Billiardchalktheif/2026ESWContest_free_bulchimbeon/README.md

# 2026ESWContest_free_불침번
> **점검을 대체하지 않고, 점검 사이를 지킵니다.**
> 소방설비 법정 점검(연 1~2회) 사이의 상태 열화를 상시 센서로 감시해, 점검 사각지대를 메우는 AIoT 기반 소방설비 상태감시·점검보조 플랫폼입니다.

## 저장소 구조

| 폴더 | 내용 |
|---|---|
| `docs/` | 설계·기획 자료 |
| `guides/` | 실험·조립 가이드 |
| `server/` | ESP32 펌웨어(.ino) |
| `bulchimbeon_sw/` | 라즈베리파이 서버(Python: 수신·판정·AI·대시보드) |
| `app/` | 네이티브 앱(Flutter) |
| `simulation/` | Wokwi 하드웨어 시뮬레이션 |
| `data/` | 실물 실험 원시 데이터 (엣지별, 상세는 `data/README.md`) |

## docs/ — 설계·기획 자료
불침번 개발과정을 정리한 자료입니다.

- `불침번_하드웨어_조감도_핀배치_v3.pdf` — 전체 시스템 구조도 + 모듈별 핀 배치 (가장 먼저 볼 자료)
- `불침번_하드웨어_최종기술문서.pdf` — 하드웨어 최종 기술문서
- `AI_학습_데이터_수집_가이드.md` — AI 학습 시 데이터 수집 방법 초기 구상안
- `Fail-Safe_설계철학_정리.md` — 프로젝트 구성 중 산업적인 측면에서의 정리
- `소프트웨어_구상안_초안.md` — 서버/AI/판정로직 아키텍처 초안
- `소프트웨어 구성안 v3.md` — 서버/AI/판정로직 아키텍처 최신안 (실제 코드는 이 기준)
- `개발_장애요인_해결방안_정리.md` — 개발 중 발생한 기술적 문제와 해결 과정 (CT클램프→INA219 교체 등)
- `네트워크_인프라_장애요인_해결방안_정리.md` — 라즈베리파이 자체 WiFi 핫스팟(BulchimbeonAP) 인프라에서 겪은 문제 정리 (핫스팟 비영속성, ESP32 WPA 협상 실패, RTC 부재로 인한 하트비트 오판정 등)
- `소화기_게이트웨이_ESP-NOW_WiFi_동시사용_문제_정리.md` — 위 문서의 WPA 협상 문제 해결 후에도 남아있던 소화기 게이트웨이 WiFi 반복 끊김 원인 추적기 (라즈베리파이 AP 모드 `brcmfmac` 드라이버 결함 + ESP32 ESP-NOW/WiFi 단일 라디오 공유 제약, 최종적으로 파이를 외부 공유기 클라이언트 모드로 전환해 해결), 예선(WiFi)/결선(RS-485 유선) 통신 방식 차이 결정 배경
- `소화기_리프노드_딥슬립_제거_디버깅_정리.md` - 소화기 노드 캘리브레이션 과정에서 발견한 esp32-mini의 딥슬립 과정에서의 충돌로 인한 딥슬립 로직 삭제
- `개발_체크리스트.md` — 하드웨어 조립 및 실험 시 체크할 내역
- `발전가능성_확장방안_정리_v2.md` — 실물 규모 확장 시 설계 변경 방향
- `불침번_잔여작업_체크리스트.md` — 하드웨어 및 소프트웨어 구축 완료 후의 잔여 작업 체크리스트
- `불침번_팀원용_이해자료_최종.md` — 프로젝트 취지·로직을 쉽게 풀어쓴 내부 참고자료
- `앱_통합_아이디어_초안.md` — (폐기) 텔레그램 알림봇 + PWA 연동 초기안 — 네이티브 앱으로 방향 전환됨
- `유도등_변경사항_정리.md` — 실제 제작 과정에서 생긴 문제점을 바탕으로 변경 및 수정 사항 정리본
- `유도등_실물실험_기록.md` — 유도등 노드 실물 제작 및 실험 내용 정리
- `수계_유량센서_추가_변경사항_정리.md` — 펌프성능시험의 문제점을 발견 후 성능시험배관에 유량센서를 추가하는 방안  
- `라즈베리파이_소프트웨어_검증_가이드.md` - 라즈베리파이를 통한 중앙제어 시스템을 시뮬레이션하는 가이드
- `라즈베리파이_초기세팅_가이드.md` - 라즈베리파이를 다루기 위한 초기 세팅 가이드라인
- `자탐_유도등_열화감지_회로구성.md` - 열화감지 관련 내용 정리 및 회로 구성 정리
- `자탐1(차동식)_실물실험_기록.md` - 자탐1(차동식) 노드 실물 제작 및 실험 내용 정리
- `자탐2(광전식)_실물실험_기록.md` - 자탐2(광전식) 노드 실물 제작 및 실험 내용 정리
- `자탐1_루프저항_2층판정_재조정_정리.md` — 자탐1 실물(5초 간격) 기준 오프셋 실측, 클램핑 위치 버그, 회귀 노이즈 증폭 문제 발견부터 시연용/결선전용 2단계 재조정, DEMO_MODE 플래그 도입까지 전 과정 정리
- `자탐1_온도상승률_판정로직 및 점검모드신설_소프트웨어_인수인계.md` - 자탐1의 작동/부작동시험의 판정 로직과 점검모드의 신설 관련 소프트웨어 수정사안
- `bulchimbeon_animatic.html` — 애니매틱으로 만든 시연영상 초기 구성안

**시연영상 초기 구성안**: [바로 재생하기](https://billiardchalktheif.github.io/2026ESWContest_free_bulchimbeon/docs/bulchimbeon_animatic.html)

## guides/ — 실험·조립 가이드
하드웨어 핀 배치 및 각 테스트베드 조립과 실험 방법입니다.

- `테스트베드_조립가이드.md` — 5개 모듈 조립 순서 총정리
- `자탐_실험가이드.md` — 자탐1(차동식)·자탐2(광전식) 실험 프로토콜
- `수계_실험가이드.md` — 압력센서를 활용한 펌프성능시험의 주기적인 측정 및 전류센서(INA219)를 통한 충압펌프 작동 빈도 확인
- `수계_배관구조_최종가이드.md` — 유량센서가 추가되고 배관구조가 변경되면서 수정된 실험 가이드
- `수계_통합가이드_최종.md` — 펌프성능시험과 충압펌프 자동 기동을 위한 배관/배선 정리 및 최종 로직 설명
- `가스계_실험가이드.md` — 로드셀을 이용한 가스저장용기의 무게 변화(공병중량 분리 계산) 확인
- `소화기_실험가이드.md` — 자이로 센서 및 게이트웨이와의 통신 연결 상태를 통해 도난/분실 확인
- `유도등_실험가이드.md` — 유도등 구동전압 탐색 및 배터리 방전 실험
- `유도등_실험가이드_v2.md` — 유도등 노드의 수정본(조도센서 사용 방안 삭제)
- `실험_캘리브레이션_데이터축적_통합정리.md` — 6개 엣지 실험을 "캘리브레이션/추세축적/AI학습축적/반복검증" 관점으로 재구성한 통합 인덱스 (무엇을·왜·얼마나 쌓아야 하는지 빠르게 파악용)

## server/ — ESP32 펌웨어
각 모듈의 ESP32에 올라가는 펌웨어(.ino)입니다. 라즈베리파이에서 상시 구동되는 수신·판정·AI·대시보드 서버는 아래 `bulchimbeon_sw/` 섹션 참고.

| 파일 | 담당 모듈 | 비고 |
|---|---|---|
| `fire_alarm_differential_node.ino` | 자탐1 (차동식구역) | ADS1115+TS0202, 온도상승률 계산, 배선 열화 감지 |
| `fire_alarm_differential_node_v5.ino` | 자탐1 (차동식구역) | 점검모드 신설 및 작동 택트스위치 설치 |
| `fire_alarm_differential_node_v6.ino` | 자탐1 (차동식구역) | 워치독 로직 삽입 |
| `fire_alarm_photoelectric_node.ino` | 자탐2 (광전식구역) | ADS1115+MQ-2+DHT22, AI 비화재보 판별 대상, 배선 열화 감지 |
| `fire_alarm_photoelectric_node_v2.ino` | 자탐2 (광전식구역) | 점검모드 신설 및 작동 택트스위치 설치 |
| `fire_alarm_photoelectric_node_v3.ino` | 자탐2 (광전식구역) | 워치독 로직 삽입 |
| `pump_node_INA219.ino` | 수계 | INA219(I2C) 기반 — CT클램프는 DC 측정 불가로 폐기, 이 파일이 최신 수정본 |
| `pump_node_INA219_v7.ino` | 수계 | 유량센서 추가 및 압력센서를 통한 충압펌프 자동 기동 |
| `pump_node_INA219_v23.ino` | 수계 | 압력센서 임계값 수정 및 주배관 측 압력값 기준으로 충압펌프 및 주펌프 작동 |
| `pump_node_INA219_v24.ino` | 수계 | 펌프성능시험 실행 명령어(P) 작동 택트스위치 설치 |
| `pump_node_INA219_v25.ino` | 수계 | 워치독 로직 삽입 |
| `gas_node.ino` | 가스계 (CO2) | HX711, NVS 기반 캘리브레이션 저장 |
| `gas_node_v2.ino` | 가스계 (CO2) | 캘리브레이션을 통해 실측 중량과 측정 중량 대조 후 무게 상수 대입 |
| `gas_node_v3.ino` | 가스계 (CO2) | 영점(TARE), 기준중량저장(SET_INITIAL) 실행 명령어 작동 택트스위치 설치 |
| `gas_node_v4.ino` | 가스계 (CO2) | 워치독 로직 삽입 |
| `extinguisher_leafnode.ino` | 소화기 리프노드 ×4 | ESP32-C3, MPU6500+딥슬립, ESP-NOW 송신 |
| `extinguisher_leafnode_v2.ino` | 소화기 리프노드 ×4 | 워치독 로직 삽입 과정에서 충돌로 인한 딥슬립 로직 삭제 |
| `extinguisher_leafnode_v3.ino` | 소화기 리프노드 ×4 | 상호 간 연결 확인 로직 삽입 |
| `extinguisher_gateway.ino` | 소화기 게이트웨이 | ESP-NOW 수신 → WiFi/UDP 중계, 상시전원 |
| `extinguisher_gateway_v2.ino` | 소화기 게이트웨이 | 점검모드 신설 및 작동 택트스위치 설치 |
| `extinguisher_gateway_v3.ino` | 소화기 게이트웨이 | 워치독 로직 삽입 |
| `extinguisher_gateway_v4.ino` | 소화기 게이트웨이 | 상호 간 연결 확인 로직 삽입 |
| `evac_light_node.ino` | 유도등 | CD74HC4067 멀티플렉서, 데모모드(20분→45초 압축) 포함 |
| `evac_light_node_v2.ino` | 유도등 | 아날로그 멀티플렉서 및 조도센서 사용 삭제 |
| `evac_light_node_v3.ino` | 유도등 | 방전시험을 거치며 얻은 결과를 기준으로 수정 |
| `evac_light_node_v4.ino` | 유도등 | 방전시험(s), 데모시험(d) 실행 명령어 작동 택트스위치 설치 |
| `evac_light_node_v5.ino` | 유도등 | 워치독 로직 삽입 |

## bulchimbeon_sw/ — 라즈베리파이 서버 소프트웨어 (Python)
UDP 수신 → SQLite 저장 → 규칙/회귀/AI 3계층 판정 → 부저·LCD·대시보드 출력까지, 라즈베리파이에서 상시 구동되는 서버 전체입니다. AI는 정확히 2곳(수계 주펌프 파형 분류, 자탐2 비화재보 판별)에만 쓰고 나머지 설비(자탐1/가스계/유도등/소화기)는 전부 통계·규칙 기반입니다. 구조·실행 순서·설계 결정 배경은 `bulchimbeon_sw/README.md`에 자세히 정리되어 있습니다.

- `server/` — `main.py`(실행 진입점), `receiver/`(UDP 수신), `storage/`(SQLite 스키마·마이그레이션), `judge/`(규칙·회귀·AI 판정 로직), `dispatch/`(부저+LCD 출력)
- `ml/` — 수계 파형 분류기·자탐2 비화재보 판별기 학습 스크립트, 예측 정확도(MAE) 검증
- `dashboard/` — Flask 대시보드(`app.py`) + 템플릿
- `app_api/` — 네이티브 앱(Flutter) 연동용 FastAPI 서버(`inspection_api.py`). 설비 체크리스트 조회 + 점검기록 등록 API 제공 (점검이력 영구 저장은 미구현, 앱 쪽 `app/네이비브앱_결선_발전방향.md`에 후속 작업으로 명시됨)
- `simulate/` — 더미 데이터 생성기, 실측 라벨 데이터 DB 반영 스크립트, 판정 로직 검증 스크립트
- `requirements.txt` — Python 의존성

## app/ — 네이티브 앱(Flutter) 개발
안드로이드 기준 네이티브 앱. 대시보드 외 알림/QR조회/PDF리포트 등 출력 채널을 담당합니다.

- `개발_코드/` — Flutter 앱 실제 소스. `main.dart`, `home_screen.dart`(설비 상태 리스트), `equipment_detail_screen.dart`(설비 상세), `alerts_screen.dart`(알림), `scanner_screen.dart`(QR 스캔), `settings_screen.dart`(설정+PDF 리포트), `pubspec.yaml`, `AndroidManifest.xml`, `network_security_config.xml`
- `네이티브앱_쉬운설명.md` — 네이티브 앱·Flutter가 뭔지 비유로 풀어쓴 개념 입문 자료
- `네이티브앱_개발가이드.md` — 화면 구성, API 연동 목록(`/api/status` 등), 기능별 구현 순서 정리
- `처음부터_시작하기_Windows.md` — Flutter 개발환경 설치 가이드 (Windows)
- `네이티브앱_고급기능_가이드.md` — QR스캔·PDF리포트 등 고급 기능 구현 가이드
- `QR코드_생성_가이드.md` — QR코드에는 짧은 식별자(예: `EXT-01`)만 넣고 앱이 스캔 후 서버(`/api/equipment/<코드>`)에 조회하는 A방식 생성 가이드
- `라즈베리파이_연동_가이드.md` — Flutter 앱을 라즈베리파이 서버(`api.py`, 5001포트)와 연동하는 단계별(STEP 0~) 실행 가이드
- `raspberry_pi_integration_plan.md` — 라즈베리파이·QR코드 연동 개발 마일스톤(단계별 작업 계획서)
- `앱개발_과정.md` - Flutter를 이용한 앱 개발 및 코드 (틀 완성 + QR스캔·PDF리포트 기능 완료, 서버 연동 대기 중)
- `앱개발_총정리.md` - 네이티브앱 개발 목적 과정 개선방향의 총정리
- `네이비브앱_결선_발전방향.md` — 예선 제출(9/3) 기준 QR→설비상세→점검완료→PDF 풀 플로우는 완성. 시간상 예선에서 스킵하고 결선에서 이어갈 6개 항목 정리(앱 아이콘 커스텀, PDF 한글 폰트, 점검이력 영구 저장, 홈화면 실시간 폴링 등)

## simulation/ — 하드웨어 시뮬레이션 (Wokwi)
실물 부품 도착 전, 회로·로직을 미리 검증한 시뮬레이션입니다.

- **가스계(CO2) 모듈(로드셀)**: [Wokwi에서 열기](https://wokwi.com/projects/471159083371335681)
  - 소스: `simulation/가스계_wokwi/`
   -  **시뮬레이션 한계 (자세히)**:
    - **HX711은 공식 지원 부품이라 실물과 거의 동일하게 동작** (Wokwi 부품 중 신뢰도가 가장 높은 축).
    - **캘리브레이션 계수(CALIBRATION_FACTOR)는 임시값**: 가상 로드셀의 신호 크기가 실물과 다르기 때문에, 실물 그램 단위로 정확히 안 맞습니다. 실물 로드셀 수령 후 알고 있는 무게(동전 등)로 재보정할 예정입니다.
    - **공병중량(EMPTY_CONTAINER_WEIGHT)은 시뮬레이션에서 0으로 설정**:
      실물 상수(예: 500g)를 그대로 넣으면 시뮬레이션의 작은 임의값(수십 단위)과 스케일이 안 맞아 손실률이 이상하게 계산되는 문제를 겪었습니다.
      시뮬레이션에서는 이 값을 0으로 두고 "슬라이더 값 자체를 약제중량으로 취급"하는 방식으로 로직만 검증했습니다.
    - **검증된 것**: 약제중량 기준 손실률 계산식(총중량이 아니라 공병중량을 뺀 값 기준), 10% 임계치 도달 시 상태 전환(정상→주의→재충전 필요) 판정 로직.
    - **검증 안 된 것**: 실제 CO2 저장용기 중량대에서의 로드셀 분해능, 실물 공병중량 적용 시의 정확도.

- **소화기 모듈(자이로 + 연결끊김)**: [Wokwi에서 열기](https://wokwi.com/projects/471162307837300737)
  - 소스: `simulation/소화기_wokwi/`
  -  **시뮬레이션 한계 (자세히)**:
    - **무선통신(ESP-NOW)을 푸시버튼으로 대체**:
       실물은 리프노드가 게이트웨이와 ESP-NOW로 실제 무선 통신하면서 "연결 유지/끊김"을 판단하지만, Wokwi에서 보드 2개 간 무선통신을 구현하기 어려워
       **푸시버튼 하나로 "연결 끊김" 상태를 대신 흉내냈습니다** (버튼 안 누름=연결 유지, 누름=연결 끊김).
    - **가속도 임계값(ACCEL_THRESHOLD)을 실측으로 재조정함**:
        처음엔 하드코딩된 "정지 시 9.8"을 기준으로 잡았는데, Wokwi의 가상 MPU6050은 기본 상태에서 중력을 시뮬레이션하지 않아 항상 흔들림으로 오인식되는 문제가 있었습니다.
        **정지 상태 기준값을 setup()에서 직접 측정해서 잡는 방식**으로 바꿔 해결했습니다 — 이 방식은 실물에서도 동일하게 적용 가능합니다(설치 각도가 어떻든 자동으로 맞춰짐).
    - **검증된 것**: 가속도 이벤트 감지 → 일정 시간 대기 → 연결상태 확인 → 오탐/이탈 확정이라는 2단계 판정 흐름 전체, 정지상태 기준값 자동 캘리브레이션 로직.
    - **검증 안 된 것**: 실제 ESP-NOW 페어링·통신 성공률, 실물 배터리(LiPo+TP4056) 구동 상태에서의 동작, 여러 리프노드가 동시에 게이트웨이와 통신할 때의 처리.
 
- **수계 모듈(압력 + 전류2)**: [Wokwi에서 열기](https://wokwi.com/projects/471258535724992513)
  - 소스: `simulation/수계_wokwi/`
  -  **시뮬레이션 한계 (자세히)**:
    - **INA219 미지원**: 전류센서 2개(충압/주펌프)를 포텐셔미터로 대체(GPIO0/GPIO1). 실물은 I2C(주소 0x40/0x41)로 통신하지만, 시뮬레이션에서는 아날로그 입력값을 그대로 mA 단위처럼 취급했습니다.
    - **압력센서도 포텐셔미터로 대체**(GPIO4) — 저항분압 계산 없이 raw값을 바로 kPa로 스케일링한 단순화 버전입니다.
    - **워터펌프 자체는 시뮬레이션 대상에서 제외** — 릴레이 출력(GPIO18/19)은 신호만 내보낼 뿐 실제로 아무것도 구동하지 않습니다.
    - **duty_cycle 계산은 캡처 타이밍에 민감함**:
      한 번의 전류 샘플링(캡처)이 매우 짧은 시간(수백ms~1초) 동안 이뤄지는데, 사람이 마우스로 포텐셔미터를 그 찰나에 움직이지 않으면 "값이 안 변한 것"으로 인식되어 duty_cycle이 0으로 나올 수 있습니다.
      이는 시뮬레이션 조작 방식의 한계이며, 실물 INA219는 실제 펌프의 진짜 전류 변화를 훨씬 빠르게 읽어 이런 제약이 없습니다.
    - **검증된 것**: RMS/Peak/duty_cycle 계산 로직이 입력 변화에 정확히 비례 반응하는 것, 충압펌프 기동 엣지 감지 및 기동 간격(cycle_interval_sec) 계산 로직.
    - **검증 안 된 것**: 실제 체절/부하 상태에서의 전류 패턴, 압력값 추세로 서버가 밸브 상태를 추정하는 로직(server 쪽 별도 검증 필요), 실물 니들밸브 조작과의 연동.
 
- **유도등 모듈(전압 + 조도)**: [Wokwi에서 열기](https://wokwi.com/projects/471260578018942977)
  - 소스: `simulation/유도등_wokwi/`
  -  **시뮬레이션 한계 (자세히)**:
    - **CD74HC4067 멀티플렉서 미지원**:
      실물은 유도등 4개(배터리전압×4 + 조도×4 = 8채널)를 멀티플렉서 하나로 순차 스캔하지만, Wokwi에 이 부품이 없어서 **유도등 1개 분량만 축소해서 시뮬레이션**했습니다.
      멀티플렉서의 채널 전환 로직 자체는 단순 반복(S0~S3 비트 조합)이라 코드 리뷰로 검증 가능하다고 판단해, 정작 확인이 필요한 핵심 판정 로직(전압 추이, 방전시험 상태전환)에 집중했습니다.
    - **배터리 전압을 포텐셔미터1(GPIO4)로 대체**:
      실물은 유도등 배터리 단자에서 저항분압으로 전압을 낮춰 ADS1115(또는 멀티플렉서 경유)로 읽지만, 시뮬레이션에서는 포텐셔미터로 전압값 자체를 흉내냈습니다. 손으로 값을 낮추면서 "배터리가 방전되는 상황"을 재현했습니다.
    - **CDS 조도센서를 포텐셔미터2(GPIO3)로 대체**:
      실제 빛의 밝기를 감지하는 게 아니라, "조도값이 바뀌면 lux 계산 로직이 반응하는가"만 검증했습니다.
      시험 초반(488→324→127)에는 값 변화를 확인했으나, 이후 구간에서는 포텐셔미터를 고정해둔 채로 진행해 127로 유지된 것이며 — 이는 조작을 멈춘 결과일 뿐 로직 결함은 아닙니다.
    - **실제 20분 정격 방전시험 대신 데모모드(45초 압축)만 시뮬레이션**:
      원본 코드에는 실제 정격시험(20분, 30초 간격 샘플)과 데모(45초, 그 비율에 맞춘 간격) 두 가지가 있는데, 20분을 시뮬레이션으로 기다리는 건 비효율적이라 데모모드 로직만 검증했습니다.
      두 모드는 "지속시간·샘플간격 숫자만 다르고 로직은 동일"하게 설계되어 있어(원본 코드의 `testDurationMs`, `testSampleIntervalMs` 파라미터화 구조),
      데모모드가 정상 작동하면 실제모드도 같은 코드 경로를 타므로 검증 효력이 있다고 판단했습니다.
    - **데모 버튼을 인터럽트(GPIO0)로 구현**: 실물과 동일하게 `attachInterrupt`로 버튼을 처리해, 시험 도중에도 다른 처리가 멈추지 않는 논블로킹 구조를 그대로 시뮬레이션했습니다.
    - **검증된 것**: 평상시 모니터링(3초 간격 전송) ↔ 방전시험 모드 전환, 방전시험 중 배터리 전압이 샘플마다 달라지는 것을 반영해 서버에 보내는 흐름, 시험 시간(45초) 경과 후 자동 종료 및 평상시 모드 복귀.
    - **검증 안 된 것**: 4개 유도등 동시 스캔(멀티플렉서 채널 전환 타이밍), 실제 20분 정격 방전시험(시간 관계상 데모모드로만 대체 검증), 2선식/3선식 배선에 따른 실물 동작 차이(현장 확인 필요 — 원본 코드 주석에도 명시됨).    
 
- **자탐1(차동식구역) 모듈(온도 + 루프저항)**: [Wokwi에서 열기](https://wokwi.com/projects/471254826421447681)
  - 소스: `simulation/자탐1(차동식)_wokwi/`
  -  **시뮬레이션 한계 (자세히)**:
    - **ADS1115 미지원**: Wokwi에 이 외장 ADC 부품이 없어서, 실물 코드의 `ads.readADC_SingleEnded()` 부분을 ESP32 내장 `analogRead()`로 임시 대체했습니다. 실물에서는 원래 코드(ADS1115 A0/A1 채널) 그대로 사용합니다.
    - **센서를 포텐셔미터로 대체**: 실물 온도센서(TS0202)와 감지기 루프저항을 손으로 돌리는 가변저항(포텐셔미터) 2개로 흉내냈습니다. 실제로 열을 가하는 게 아니라 "값이 서서히 변하면 코드가 올바르게 반응하는가"만 검증하는 용도입니다.
    - **핀 번호가 실물과 다름**: 시뮬레이터의 ESP32-C3 보드가 실제 구매한 ESP32-C3 보드와 핀 배치가 달라서(예: GPIO5는 시뮬레이터에서 아날로그 입력 자체가 안 됨), GPIO3/GPIO4로 임시 배정했습니다.
                                 실물 배선은 하드웨어 조감도 문서(ADS1115 A0/A1) 기준을 따릅니다.
    - **검증된 것**: 온도 상승률(dT/dt) 계산 로직, 루프저항 단선(개방) 감지 로직, JSON 패킷 구성 — 이 세 가지 핵심 판정 로직이 값 변화에 정확히 반응하는 것을 확인했습니다.
    - **검증 안 된 것**: 실제 센서의 정밀도·응답속도, ADS1115 특유의 노이즈 특성, WiFi/UDP 실제 전송(시뮬레이터는 가상 네트워크라 서버로 실제 도달하지 않음)

- **자탐2(광전식구역) 모듈(가스 + 온습도 + 루프저항)**: [Wokwi에서 열기](https://wokwi.com/projects/471257287920422913)
  - 소스: `simulation/자탐2(광전식)_wokwi/`
  -  **시뮬레이션 한계 (자세히)**:
    - **ADS1115 미지원**: 자탐1과 동일한 이유로, 실물 코드의 `ads.readADC_SingleEnded()` 부분을 ESP32 내장 `analogRead()`로 임시 대체했습니다. 실물에서는 원래 코드(ADS1115 A0/A1 채널) 그대로 사용합니다.
    - **MQ-2 가스센서를 포텐셔미터로 대체**: 실제 가스 성분을 감지하는 게 아니라, 손으로 돌리는 가변저항으로 "가스농도 신호값이 바뀌면 코드가 올바르게 반응하는가"만 검증했습니다.
    - **루프저항도 포텐셔미터로 대체**: 자탐1과 동일하게, 감지기 루프 배선 상태를 흉내낸 가변저항입니다.
    - **핀 번호가 실물과 다름**:
        ESP32-C3-MINI-1 시뮬레이터 보드는 GPIO0~4만 아날로그 입력이 가능해서(자탐1에서 GPIO5가 아날로그 입력 자체를 지원하지 않는 걸 확인했음), 포텐셔미터 2개를 GPIO4·GPIO3으로 배정했습니다.
        실물 배선은 하드웨어 조감도 문서(ADS1115 A0/A1) 기준을 따릅니다.
    - **DHT22는 공식 지원 부품**이라 실물과 동일하게 동작합니다 — 온도·습도 슬라이더를 직접 조절해 값 변화를 확인했습니다(온도 63.9℃, 습도 0%→34.5%로 각각 독립 반응 확인됨).
    - **검증된 것**: 루프저항(배선 상태)·가스농도(MQ-2)·온도·습도, 이 4개 값이 각각 독립적으로 측정되어 하나의 JSON 패킷으로 정상 구성·전송되는 흐름 전체.
    - **검증 안 된 것**: 실제 MQ-2가 진짜 화재 연기와 조리 수증기를 구분할 때 보이는 신호 패턴(이건 물리적으로 실물 센서·실제 연기/수증기가 있어야 확인 가능
                         실물 데이터 수집 후 자탐2 AI(비화재보 판별) 학습 단계에서 검증 예정), WiFi/UDP 실제 전송(시뮬레이터는 가상 네트워크라 서버로 실제 도달하지 않음).

- **라즈베리파이 서버 — MOCK_MODE 소프트웨어 검증**
  - 소스: `simulation/라즈베리파이 검증 로그.md`
  - **참고**: 위 항목들(가스계~유도등)은 Wokwi를 이용한 **하드웨어 회로 시뮬레이션**이고, 이 항목은 실물 라즈베리파이 도착 전 **서버 소프트웨어(수신·판정·AI·대시보드) 자체를 노트북에서 미리 실행·검증**한 기록입니다.
  - **검증 내용**: DB 초기화 → UDP 수신 서버 실행 → 더미데이터(9개 시나리오) 전송 → AI 모델 2종 학습(수계 펌프분류, 자탐2 비화재보판별) → 대시보드 실행 → 자탐 z-score 판정 로직 별도 검증 → 가스계/유도등 회귀예측 정확도(MAE) 산출
  - **확인된 것**: 판정 로직(규칙·회귀·AI 3계층) 정상 작동, 밸브상태 서버추정 로직 정상 작동, 자탐 오탐억제·열화감지 전이 정상 작동
  - **주의**: AI 분류 정확도가 시뮬레이션(더미)데이터 기준 100%로 나왔으나, 이는 인공 생성 데이터의 경계가 실측 센서 노이즈보다 뚜렷하기 때문 — **실물 센서 데이터 학습 전까지는 참고용 수치**로만 사용.
              대신 Feature importance(수계: rms 45.5%+peak 41.1%, 자탐2: 온도상승률·가스농도·습도가 고른 기여도)가 물리적으로 타당한 근거로 확인됨
  - 정량지표(보고서 활용 가능): 가스계 예측 MAE 0.77일(오차율 6.7%), 유도등 예측 MAE 0.62일(오차율 2.2%)
---

## data/ — 실물 실험 데이터
6개 엣지 중 지금까지 진행된 실험 데이터입니다. 파일별 컬럼 설명과 분석 결과는 `data/README.md`에 정리되어 있습니다.

| 엣지 | 상태 | 요약 |
|---|---|---|
| 광전식 | 실험 완료(최종본) | normal/smoking/incense/heat/fire 5클래스 64세션 통합 + 최종분석보고서 |
| 차동식 | 실험 5종 완료 | 온도 상승률 판정 임계값 확정(캘리브레이션 상수 포함) |
| 가스계 | 캘리브레이션 완료 | 로드셀 무게손실 회귀검증(3.85일 로그) |
| 수계 | 채집 완료 | 충압펌프 4클래스(정상/유량저하/공회전/기동실패) 분류용 데이터 |
| 유도등 | 실험 완료 | 충전시간별(1h~8h) 방전시험 |
| 소화기 | 캘리브레이션 완료 | 건물 내 층의 변화 시에 이탈 감지 확인 |
