Billiardchalktheif/2026ESWContest_free_bulchimbeon/docs/개발_장애요인_해결방안_정리.md

# 개발 중 발생한 장애요인과 해결방안 — 정리 자료

> 발표자료(개발완료보고서) 4번 항목용 소재 모음입니다. 지금까지 설계/부품 선정 과정에서 실제로 부딪혔던 문제와 해결 과정을 모듈별로 정리했습니다. 발표 슬라이드로 옮길 때 임팩트 있는 것 위주로 추리면 됩니다.

---

## 1. 가스계 (CO2 소화설비)

### 장애요인 ①: 압력센서로는 미세 누설을 감지할 수 없음
당초 가스계 저장용기의 약제 손실을 압력센서로 감지하려 했으나, 고압식 CO2/할론 저장용기는 내부가 액체+기체 평형 상태로 존재해 **약제가 새어나가도 압력은 거의 일정하게 유지**되고(포화증기압, 온도에만 좌우), 액체가 거의 소진된 시점에야 압력이 급격히 떨어지는 물리적 특성이 있음. 압력만으로는 점진적 손실을 조기에 감지할 수 없다는 것을 확인.

**해결방안**: 압력 대신 **로드셀(중량) 측정 방식**으로 설계 전환. 화물지킴이 프로젝트에서 사용한 HX711 로드셀 앰프 로직을 그대로 재사용해 개발 리스크를 최소화함. 판정 임계치는 **중량손실 10%** (출처: 소방시설등 점검관리 매뉴얼 — 이산화탄소소화설비 점검표, "이산화탄소는 중량 손실 10% 미만" — 불활성가스 5%·기타 가스계와 기준이 다름).

### 장애요인 ②: 약제 종류에 따라 물리적 특성이 상반됨
불활성기체(질소·아르곤 계열)는 순수 기체로 저장돼 압력이 곧 충전량을 직접 반영하는 반면, CO2/할론은 위와 같이 압력이 손실량을 반영하지 못함. 하나의 방식으로 통일할 수 없었음.

**해결방안**: 약제 화학적 특성에 따라 진단 방식을 분기 — **CO2/할론은 중량 측정, 불활성기체는 압력 측정**으로 설계 원칙 수립.

### 장애요인 ③: 로드셀 마운팅 방식 오류
재고로 보유한 S자형 로드셀은 원래 인장(당기는 힘)력 측정에 최적화된 형태로, 용기를 단순히 얹어놓는 압축 방식으로 쓰면 접촉 불안정으로 오차가 커짐.

**해결방안**: 평판 하프브릿지형 로드셀 2개를 평판 양 끝에 배치해 하중을 분산시키는 구조로 재설계, 안정성 확보.

---

## 2. 자동화재탐지설비 (자탐)

### 장애요인 ①: 실제 배선 전원(DC 24V) 재현 불가
자동화재탐지설비는 실제로 수신기에서 감지기 회로에 DC 24V를 공급하는 구조이나, 학생 프로젝트 특성상 실제 수신기 구매나 건물 배선공사가 불가능함.

**해결방안**: 진짜 감지기 제품을 재현하는 것이 아니라 **감지기 회로의 전기적 특성(루프 전류/저항)만 저전압(3.3V/5V)으로 시뮬레이션**하는 것으로 스코프를 명확히 재정의. 발표 시 이 스코프 한계를 정직하게 명시하기로 함.

### 장애요인 ②: 절연저항 측정 방식이 상시 감시에 부적합
절연저항 측정(DC 250V)은 정전 상태에서 주기적으로 측정하는 것이 정석이라, "상시 감시"라는 프로젝트 목적과 맞지 않음.

**해결방안**: 절연저항 대신 **루프 전류/저항 베이스라인 상시 로깅** 방식으로 대체. 감지기 종류(차동식/정온식/광전식)와 무관하게 범용으로 적용 가능한 방식임을 확인.

### 장애요인 ③: 열원 시뮬레이션 안전성 문제
차동식 감지기 작동 재현을 위한 열원으로 니크롬선(발열선)을 검토했으나, 발열체 노출로 인한 화재 위험이 있고 자탐 모듈 특성상 가연성 물질과 근접 배치될 가능성이 있어 안전 문제 제기.

**해결방안**: 니크롬선 대신 **열풍기(헤어드라이어 등)**로 대체 — 발열체 노출 없이 동일한 온도 상승 재현 가능, 준비물 확보도 용이함.

### 장애요인 ④: 온습도센서(DHT22)의 반응속도 한계
차동식 감지기의 핵심 원리는 온도 절대값이 아닌 "온도 상승 속도(dT/dt)"인데, DHT22는 초당 0.5회 수준의 느린 응답속도로 빠른 온도 변화율을 정밀하게 측정할 수 없음을 확인.

**해결방안**: 별도로 **NTC 서미스터(빠른 응답속도)**를 추가해 차동식 전용 온도 측정 라인을 구성. DHT22는 연기감지기구역의 습도 보조 측정용으로 역할 재조정.

### 장애요인 ⑤: 센서 수량 설계 오류
감지기 모형(더미) 개수에 맞춰 온도/가스 센서 개수도 늘려야 한다고 잘못 설계함(NTC 서미스터를 감지기 모형 수와 동일하게 3개로 배정).

**해결방안**: 감지기 모형은 회로에 저항만 얹은 더미 부품으로 그 자체로는 아무것도 감지하지 않으며, 실제 감지 센서(NTC/MQ-2/DHT22)는 **해당 방호구역(챔버) 공간의 대기 상태를 대표하는 것**이므로 감지기 모형 개수와 무관하게 방호구역당 1세트면 충분함을 재확인, 부품 수량 정정.

---

## 3. 수계소화설비

### 장애요인 ①: 유선/무선 통신구조 결정 시 원가 문제
설비 개수가 많은 자탐·소화기 모듈에서 "설비 1개당 ESP32 1개"로 설계하면 원가가 기하급수적으로 증가하는 문제 발견.

**해결방안**: 설비의 물리적 밀집도에 따라 유선/무선을 분리하는 원칙 수립 — 밀집된 설비(가스계, 수계)는 구역당 ESP32 1개로 유선 처리, 산개된 설비(소화기)는 저전력 무선 리프노드+게이트웨이 구조로 처리.

### 장애요인 ②: 워터펌프 양정(성능) 스펙 미상
선정한 미니 워터펌프 제품에 양정(수두) 정보가 명시되지 않아, 압력센서 스펙 선정이 어려움. 유량(Q)만으로 토리첼리 공식을 활용한 이론적 역산을 시도했으나, 이는 개방 상태 유속에 대응하는 값일 뿐 실제 최대 양정(체절 상태)과는 다른 값임을 확인.

**해결방안**: 이론적 역산 대신 **실측(펌프 구매 후 수직관 실험) 우선 원칙**으로 전환. 압력센서는 저압 범위(0~100kPa)로 스펙을 하향 조정.

### 장애요인 ③: 압력챔버 측정 로직의 우선순위 문제
초기에 CT클램프(전류)와 압력센서(압력) 둘 다 1차 프로토타입 필수 항목으로 설계했으나, 핵심 로직(충압펌프 기동빈도 감지)은 전류센서만으로 성립함을 재확인. (이후 CT클램프는 DC 전류 측정 불가로 INA219로 교체)

**해결방안**: 압력센서를 2차(통합/데모 단계)로 이동시켜 1차 개발 부담 경감.

### 장애요인 ④: 밸브 규격 불일치
미세누수 재현용 니들밸브를 구매하려 했으나, 실제 사용 중인 실리콘 호스(내경 8mm)와 초기 검토 제품의 니플 규격(내경 10mm 기준)이 맞지 않는 문제 발견.

**해결방안**: 니플(barb) 방식 대신 **푸시핏(퀵커넥트) 방식**으로 전환 — 이 방식은 호스 내경이 아닌 외경 기준으로 규격이 정해져, 보유 호스(외경 10mm)와 정확히 일치하는 제품으로 대체.

### 장애요인 ⑤: 릴레이 모듈 트리거 전압 호환성 우려
저가 범용 릴레이 모듈은 5V 트리거 기준으로 설계된 경우가 많아 ESP32(3.3V 출력)와 직결 시 정상 작동을 보장할 수 없는 문제.

**해결방안**: 3.3V 호환이 명시된 광커플러 방식 릴레이 HAT 모듈로 대체 구매.

### 장애요인 ⑥: 충압펌프 기동빈도 로직만으로는 점검 효과가 제한적이라는 문제 제기
누수 감지(충압펌프 기동빈도)와 파형분류(AI) 조합만으로는 실제 법정 점검 항목(펌프성능시험)과의 연관성이 약하고, 파형분류는 학습 데이터 확보·검증 난이도가 높아 결과 신뢰도에 대한 우려 제기.

**해결방안(검토 중)**: 법정 성능시험 기준(체절운전 시 정격토출압력 140% 이하, 150% 과부하 운전 시 정격토출압력 65% 이상)을 그대로 재현하는 방향으로 전환 검토. 솔레노이드 밸브를 추가해 체절/부하 조건을 자동으로 전환하며 압력값을 비교하는 규칙 기반 로직으로 설계 — AI 학습 없이도 법정 기준과 직접 비교 가능한 명확한 결과 도출. (팀 논의 진행 중)

### 장애요인 ⑦: CT클램프로는 DC 전류를 측정할 수 없음
전류센서 선정 단계에서 비접촉식 CT클램프(SCT-013)를 채택했으나, CT클램프는 전자기 유도 원리(변화하는 자기장 감지)로 동작해 **교류(AC) 전류만 측정 가능**하다는 사실을 뒤늦게 확인. 워터펌프는 12V **직류(DC)**로 구동되므로, 이 상태로는 전류값이 거의 0 또는 무의미한 노이즈로 측정될 뻔한 근본적 설계 오류였음.

**해결방안**: **INA219(션트저항 기반 I2C 전류/전력 모니터)**로 전면 교체. CT클램프처럼 전선을 감싸는 비접촉 방식이 아니라, 전선을 절단해 전류 경로에 직렬로 삽입(High-side)하는 방식으로 배선 자체를 재설계. DC/AC 모두 측정 가능하며, 저전류(수백 mA대) 정밀도도 CT클램프보다 우수해 오히려 미니 펌프 측정에 더 적합함을 확인.

---

## 4. 소화기구

### 장애요인 ①: 압력게이지 판독의 물리적 한계
소화기 압력게이지(직경 약 30mm)에 바늘 위치 판독용 센서(카메라, IR 반사센서 등)를 부착하려 했으나, 정상범위 구간이 4mm 내외로 매우 좁아 다중 센서 배치가 물리적으로 불가능함을 확인.

**해결방안 검토 과정**:
1. 카메라(ESP32-CAM) + 이미지 인식 → 실물 배포 시 소화기 개수만큼 카메라가 필요해 원가 구조가 무너지는 문제 발견 (예: 복도 1개당 7대 × 17,000원)
2. IR 반사센서 다중 배치 → 게이지 물리적 크기 제약으로 배치 불가

**최종 해결방안**: 압력 판독 자체를 포기하고, **"제자리에 있는가(도난·분실 감지)"로 점검 목표를 재정의**. 압력보다 더 근본적인 사각지대(육안점검 접근성 문제)를 겨냥하는 것으로 스코프 전환.

### 장애요인 ②: 가속도센서 단독으로는 오탐 발생
소화기 이동 감지를 가속도센서만으로 구현할 경우, 청소 중 접촉이나 단순 재배치와 실제 반출을 구분할 수 없는 문제.

**해결방안**: 가속도센서(즉시 이벤트 감지)와 무선 게이트웨이 연결상태(층 이탈 확인)를 **AND 조건으로 결합** — 빠르지만 오탐 가능성 있는 신호와, 느리지만 확실한 신호를 조합해 정확도 확보.

### 장애요인 ③: 배터리 물리적 크기와 전원 안전성 문제
초기 선정한 18650 배터리는 원통형으로 부피가 커 소형 리프노드(ESP32-C3, MPU6500)와 물리적 비율이 맞지 않고 부착이 어려움. 또한 LiPo 배터리 직결 시 완충 전압(4.2V)이 ESP32 허용 전압을 초과할 위험 확인.

**해결방안**: 18650 대신 **소형 LiPo 파우치셀**로 교체. 전압 문제는 **승압형(부스트) TP4056 모듈**을 사용해 배터리 잔량과 무관하게 항상 안정된 5V를 출력하도록 해결.

---

## 5. 유도등

### 장애요인: 20m 간격 다수 설치로 인한 원가 문제
유도등은 복도 20m마다 반복 설치되는 특성상, 개별 ESP32 배치 시 원가가 크게 증가하는 문제(자탐·소화기와 동일한 유형의 문제).

**해결방안**: **아날로그 멀티플렉서(CD74HC4067, 16채널)**를 도입해 구역당 ESP32 1개로 다수의 유도등 배터리 전압·조도 신호를 순차 처리하도록 설계. 배터리는 반드시 유도등 순정 규격(Ni-Cd/Ni-MH, 동일 전압·용량)을 사용해 화학종류 혼용에 따른 안전 문제를 방지.

---

## 6. 공통 인프라

### 장애요인: 부품 시세 변동
초기 예산안에 반영한 라즈베리파이4 가격이 실제 시세와 크게 차이남을 확인 — 2026년 D램 가격 급등으로 인해 제조사가 가격을 인상한 것이 원인.

**해결방안**: 최신 시세로 예산 재산정, 사양도 4GB에서 헤드리스 운용 기준 2GB로 하향해 비용 최적화.

---

## 사용 팁 (발표 슬라이드 구성 시)

분량 제약(2번+3번 항목이 10P) 안에서 4번 항목까지 배분해야 하므로, 위 내용 중 **기술적으로 가장 흥미롭고 시각적으로 보여주기 좋은 3~4개**만 추려서 슬라이드화하는 것을 추천합니다:

1. **가스계 압력→중량 전환** (물리 원리 이해도를 보여주기 좋음)
2. **소화기 압력판독→이탈감지 전환** (원가 구조 분석 능력을 보여주기 좋음, 표/그래프로 시각화 용이)
3. **통신 구조(유무선 분리)** (전체 시스템 설계 사고력을 보여주기 좋음)
4. (여유 있으면) 수계 성능시험 전환 논의

나머지는 "그 외 세부 트러블슈팅"으로 한 줄씩 요약해 언급하는 정도로 처리하면 좋을 것 같습니다.
