Billiardchalktheif/2026ESWContest_free_bulchimbeon/data/수계 엣지/충압펌프_전류파형_분석_보고서.md

# 충압펌프 전류파형 데이터 채집 실험 — 분석 보고서

**작성일**: 2026-08-22
**목적**: 충압펌프 INA219 전류값(RMS/Peak/Duty)으로 정상운전/유량저하/공회전/기동실패
4가지 상태를 분류하는 AI 모델(`train_pump_classifier.py`)의 학습용 데이터 채집 및 사전 분석

---

## 1. 실험 배경

기존 5개 분류(정상운전/체절운전/유량저하/공회전/기동실패) 중 **체절운전을 제외**하고 4개
클래스로 단순화하여 진행함. 사유:
- 충압펌프는 원래 배관이 거의 충수된 상태에서 짧게 보충하는 역할이라, "체절운전"과
  "정상운전"의 전류파형 차이가 주펌프만큼 뚜렷하지 않을 것으로 판단.
- 실무적으로 조치가 필요한 4가지 상황(정상/공회전/유량저하/기동실패)에 집중하는 것이
  더 명확한 분류체계.

각 클래스는 전용 데이터 채집 스케치(`pump_jockey_data_collector_v2.ino`, v23 운영 코드와
완전히 별개)로, 충압펌프 릴레이를 상시 ON 상태로 유지하며 물리적 조건만 바꿔가며 채집함.

---

## 2. 실험 설계

| 클래스 | 물리적 조건 | 내부 다양화 |
|---|---|---|
| normal | 정격전압(12V) 고정 | 나비밸브 개도 3단계(완전개방/중간개방/완전폐쇄) |
| low_flow | 나비밸브는 normal 상태로 고정 | 파워서플라이 전압 6.5V~12V, 0.5V 간격 12단계 |
| dryrun | 정격전압(12V) 고정 | 배관 제거 정도 2가지 시도 → 최종 1가지 채택 |
| start_fail | 정격전압(12V) 고정 + 전압부족(6V) | 전원선 반복 분리 / 6V 극단적 저전압 |

**원칙**: 각 클래스마다 하나의 변수만 바꾸고 나머지는 고정 — 모델이 "이 변화가 어느
원인 때문인지" 명확하게 학습하도록 설계.

---

## 3. 데이터 채집 중 발견된 이슈와 조치

### 3.1 라벨 컬럼 오류 (채집 단계 실수, raw 값은 정상)

채집 스케치의 `LABEL` 명령 입력을 누락하여, 원본 CSV의 `label` 컬럼이 전 파일에서
`normal`로 고정 출력됨. **측정된 RMS/Peak/Duty 값(raw data) 자체는 정상적으로 채집되었으며
오염되지 않음** — 파일명이 실제 실험 조건을 정확히 나타내고 있어, 파일명 기준으로 라벨을
재구성하여 `summary/combined_all_labeled.csv`를 생성함. 데이터 재채집은 불필요했음.

### 3.2 6V — "유량저하"가 아니라 "기동실패"에 더 가까움

6V에서 물이 거의 나오지 않는 것을 육안으로 확인. 데이터도 이를 뒷받침:
- 대부분 샘플 RMS 4.6~4.9mA (거의 정지 수준)
- 간헐적으로 30~70mA 버스트 (임펠러가 간간이 꿈틀대는 것으로 추정)

이는 "유량이 줄어든 정상적 저속운전"이 아니라 "기동 토크 부족으로 사실상 멈춘 상태"에
해당하여, **`low_flow`에서 제외하고 `start_fail` 클래스로 재분류**함.

### 3.3 공회전 — 두 조건 중 하나만 채택

- **흡입+토출 배관 모두 제거**(펌프만 단독 구동): RMS 75~90mA — 다른 클래스와 겹치지
  않는 명확한 구간. **채택.**
- **흡입측만 제거**: RMS 160~180mA — `low_flow` 9V대(179~186mA)와 값 범위가 크게 겹침
  (§4.2 참고). 학습 데이터에서 **제외**하고 참고용으로만 보관
  (`raw/reference_excluded/`).

---

## 4. 데이터 분석 결과

### 4.1 클래스별 기본 통계

| 클래스 | 샘플 수 | RMS 평균(mA) | RMS 범위 |
|---|---|---|---|
| dryrun | 39 | 81.3 | 72.0~101.9 |
| low_flow | 867 | 182.3 | 113.8~245.0 |
| normal | 235 | 209.8 | 139.7~261.4 |
| start_fail | 156 | 7.3 | 0.9~68.7 |

전압이 오를수록 low_flow 내에서도 RMS가 단조증가(6.5V 126.9mA → 11.5V 235.9mA)하는
경향이 확인되어, feature가 물리적 원인과 잘 대응됨.

### 4.2 클래스 간 중첩(Overlap) 문제

**normal과 low_flow의 RMS 값은 83.7%가 서로의 값 범위 안에서 겹칩니다.**
(low_flow 867개 샘플 중 726개가 normal의 RMS 최소~최대 구간 내부에 위치)

이는 RMS 단일 지표만으로는 두 클래스 완전 분리가 어렵다는 뜻이며, 아래 두 가지로
보완이 필요함:
1. **다변량 특징 활용**: Peak, Duty, Peak/RMS 비율(파형 형태)을 함께 사용
   - Peak/RMS 비율: dryrun 1.76 > start_fail 1.97(변동 큼) > normal 1.68 > low_flow 1.52
   - 단일 지표보다 클래스 간 분리에 유리할 것으로 기대
2. **다른 센서와의 결합**: 전류만으로 애매한 경계(예: 흡입측 일부 이상 vs 중간 수준
   저전압)는, 유량센서·압력센센서 값과 결합하면 명확히 구분 가능
   (공회전이면 유량 0에 가깝고, 저전압이면 유량은 있되 적음).

### 4.3 정상운전 내부 변동성

`valve_full_closed`(체절 상태)의 RMS 표준편차(21.2)가 다른 정상 조건(8~9대)보다 훨씬
큼. 밸브가 막힌 상태에서 압력이 주기적으로 쌓였다 빠지며 생기는 진동성 부하로 추정되며,
나쁜 데이터가 아니라 정상 클래스 내의 자연스러운 다양성을 반영한 것으로 판단.

---

## 5. 클래스 불균형

| 클래스 | 샘플 수 |
|---|---|
| low_flow | 867 |
| normal | 235 |
| start_fail | 156 |
| dryrun | 39 |

`dryrun`이 `low_flow` 대비 1/22 수준으로 극히 적음. 학습 시 다음 중 하나 이상 고려 필요:
- `class_weight='balanced'` 옵션 사용 (RandomForest 등)
- dryrun 클래스 추가 채집 (시간 되면 우선순위로 권장)
- SMOTE 등 오버샘플링 기법 적용

---

## 6. 학습 데이터셋 최종 구성

`summary/combined_all_labeled.csv` — 총 1,297개 샘플, 4개 클래스, 올바른 라벨 반영 완료.
`low_flow`의 12V 데이터는 정격전압 기준점(사실상 normal과 동일 조건)이라 학습셋에서 제외.

---

## 7. 다음 단계 제안

1. `train_pump_classifier.py`에 위 데이터셋 연결, RandomForest 등으로 1차 학습
2. Confusion Matrix로 normal↔low_flow 오분류율 확인 (§4.2 중첩 문제 실제 영향 검증)
3. 시간이 되면 dryrun 클래스 데이터 추가 채집 (클래스 불균형 완화)
4. 서버(라즈베리파이)에 학습된 모델 배치, 실시간 분류 파이프라인 연결
5. `reference_excluded/` 데이터는 향후 "경계 사례(edge case)" 보강 학습용으로 재검토 가능
