Billiardchalktheif/2026ESWContest_free_bulchimbeon/data/광전식 엣지/자탐2_광전식_최종분석보고서.md

# 불침번 — 자탐2(광전식) 비화재보 판별 AI 학습데이터 최종 분석 보고서

> normal(정상) / smoking(흡연: 연초+전자담배) / incense(향 단독) / heat(열풍기 단독) / fire(향+열원, 화재모의) — 5개 클래스, 총 64세션 통합 분석. MQ-2·DHT22(온습도) 센서 기반, ADS1115로 상시 수집.

---

## 1. 요약

| 클래스 | 세션수 | MQ2 상승률(평균) | 습도 변화(평균) | 온도 상승(평균) |
|---|---|---|---|---|
| normal | 15 | 14.33%* | ±0.24%p | +0.05°C |
| smoking | 20 | 21.93% | **+12.99%** | +0.24°C |
| incense | 10 | 37.61% | +3.07% | +0.41°C |
| heat | 10 | 2.86% | **-29.01%** | +10.32°C |
| fire | 9 | 23.85% | **-35.94%** | +13.06°C |

*normal의 MQ2 상승률은 실제 반응이 아니라 센서 예열 아티팩트입니다 (2절 참고).

**가장 중요한 결론**: 온도가 거의 안 움직이는 세 클래스(normal/smoking/incense) 중에서는 MQ2·습도 조합으로, 온도가 뚜렷이 오르는 두 클래스(heat/fire) 중에서는 **습도의 방향(heat는 -29%, fire는 -36%로 더 큼)과 MQ2 반응 유무(heat는 2.86%로 거의 없고 fire는 23.85%로 뚜렷함)** 로 갈립니다. 특히 **습도가 오르는가/내리는가**가 1차 분리 기준으로 가장 강력합니다 — 연기·흡연 계열은 전부 습도 상승, 열이 개입되는 순간 습도는 확실히 하강으로 꺾입니다.

---

## 2. 클래스별 상세

### 2-1. normal (정상상태, 15세션)

세션마다 MQ-2가 예열되며 상승하다 평탄해지는 곡선입니다. **이 상승은 정상상태의 신호가 아니라 히터 예열 아티팩트**이므로, 실제 분류 특징으로는 "예열 이후 평탄구간에서 변화가 거의 없다(0%대)"는 점을 써야 합니다. `normal_plateau_reference.csv`에 예열 제외한 평탄구간 대표값이 별도로 있습니다.

- 세션 진행 순서에 따라 습도(59.5%→57.5%)와 MQ2 plateau가 같이 낮아지는 경향 확인 — MQ-2가 습도에도 교차반응한다는 근거

### 2-2. smoking (흡연, 20세션 = 연초10 + 전자담배10)

- 연초(야외): MQ2 +16.25%, 습도 +6.78% — 다만 측정 자체가 더운 습한 야외에서 진행되어 절대값이 아닌 상승률 기준
- 전자담배(실내, 거리별): 가까이 MQ2 +51.4%/습도 +40.0%, 중간 +31.9%/+18.5%, 멀리서 +11.4%/+9.5% — **거리에 선형적으로 비례하는 깔끔한 용량-반응**
- 연초 9회차(MQ2 +34.91%)가 이상치로 남아있음, 원인 미확인
- **습도가 크게 오른다는 게 이 클래스의 핵심 시그니처** (PG/VG 에어로졸·연소 수분 때문으로 추정)

### 2-3. incense (향 단독, 10세션)

- MQ2 +37.61%(가장 큼), 습도는 +3.07%로 거의 안 움직임
- 7회차(MQ2 +85.09%)가 뚜렷한 이상치 — 근접 노출 여부 확인 필요, 원인 미확인
- **MQ2는 크게 반응하는데 습도는 거의 안 움직인다**는 게 스모킹 클래스와 갈리는 지점 (고체 연소 연기는 수분이 적음)

### 2-4. heat (열풍기 단독, 10세션)

- MQ2 +2.86%(거의 무반응), 습도 -29.01%(하강), 온도 +10.32°C
- 루프저항 절대값이 다른 클래스 대비 약 50Ω 높게 나왔으나, **가변저항 조작에 따른 정상적 변동으로 확인됨** (문제 아님)
- **열만 있고 연소 부산물이 없으면 MQ2는 거의 반응하지 않는다**는 걸 보여주는 대조군

### 2-5. fire (향+열원, 화재모의, 9세션 — 원래 10세션에서 1·2회차 중복 병합)

- 1회차와 2회차가 같은 실험을 시간축만 밀려 두 번 기록한 것으로 확인되어 하나로 병합, 9세션으로 처리
- MQ2 +23.85%, 습도 -35.94%(전체 클래스 중 최대 하강), 온도 +13.06°C
- 열풍기 단독보다 습도 하강폭·온도 상승폭이 더 큼 — 향의 연소열이 더해졌거나 측정일 조건 차이로 추정(원인 미확정, 결론에는 영향 없음)

---

## 3. 분류 로직 제안 (특징 우선순위)

```
1차 분리 — 습도 변화 방향
  ├─ 습도 상승 (+) → normal 또는 smoking
  │     └─ MQ2 상승률 낮음(~0%, 평탄) → normal
  │     └─ MQ2 상승률 높음(10%+) → smoking
  │
  └─ 습도 하강 (-) → heat 또는 fire
        └─ MQ2 거의 무반응(~0~5%) → heat (오작동 원인, 화재 아님)
        └─ MQ2 뚜렷이 상승(20%+) → fire

  (incense는 습도 변화가 거의 없는 애매한 위치 — MQ2가 크게 뛰는데 온도·습도 변화가 없다는
   조합 자체로 별도 분리 필요: "MQ2만 단독으로 크게 뛰고 온도·습도는 안 움직인다" → incense)
```

normal/smoking 경계보다 **incense가 heat·fire 판정 로직에서 가장 헷갈리는 위치**입니다 — MQ2는 크게 뛰지만 온도가 안 오른다는 점에서 fire와는 구분되지만, 학습 시 이 조합이 명확히 학습되도록 각 클래스가 충분히 대표되어야 합니다.

---

## 4. 데이터 품질 이슈 — 학습 전 반드시 확인할 것

| 이슈 | 클래스/세션 | 처리 상태 |
|---|---|---|
| MQ2 예열 아티팩트 | normal 전체(1회차 제외) | 평탄구간만 사용하도록 별도 참고파일 제공 |
| 이상치 | tobacco 9회차(+34.91%), incense 7회차(+85.09%) | 원인 미확인 — 포함 여부 결정 필요 |
| 세션 중복 | fire 1·2회차 | 병합 완료, 9세션으로 재처리됨 |
| 환경 조건 차이 | tobacco(야외, 고온다습) | 절대값 대신 상승률(%) 기준으로 통일해 완화 |
| 루프저항 베이스라인 차이 | heat/fire(약 315~320Ω) vs 나머지(약 265~269Ω) | 가변저항 조작에 의한 정상 변동으로 확인, 문제 아님 |

**학습 데이터로 쓰기 전에 두 이상치(tobacco_09, incense_07)의 실험 조건을 다시 한번 확인해주시면, 최종 확정본으로 넘길 수 있습니다.**

---

## 5. 첨부 데이터

- **`photoelectric_all_classes_combined.csv`** — 5클래스 64세션 통합, 상승률(%) 기준 대표값 1행/세션 (AI 담당에게 넘길 메인 파일)
- 클래스별 원본 시계열 + 세션요약 (참고/재처리용, 항상 함께 보존): `normal_raw_timeseries.csv`/`normal_session_summary.csv`/`normal_plateau_reference.csv`, `tobacco_raw_timeseries.csv`/`tobacco_session_summary.csv`/`tobacco_delta_reference.csv`, `ecig_raw_timeseries.csv`/`ecig_session_summary.csv`, `incense_raw_timeseries.csv`/`incense_session_summary.csv`, `heat_raw_timeseries.csv`/`heat_session_summary.csv`, `fire_raw_timeseries.csv`/`fire_session_summary.csv`

## 6. 다음 단계 제안

1. tobacco_09, incense_07 이상치 원인 확인 → 포함/제외 결정
2. `photoelectric_all_classes_combined.csv`를 AI 담당에게 전달, `ml/train_nuisance_classifier.py` 학습 실행
3. 학습 결과 confusion matrix에서 incense↔fire, normal↔smoking 경계 오분류율 확인 — 위 3절 분류 로직 가설이 맞는지 검증
4. 필요 시 소화기/수계 등 다른 엣지 데이터도 같은 형식(session_id/label/rise%)으로 정리해 프로젝트 전체 데이터 문서 통일
