Billiardchalktheif/2026ESWContest_free_bulchimbeon/docs/불침번_팀원용_이해자료_최종.md

# 불침번 — 우리가 만드는 게 뭔지, 왜 만드는지

> 조원들과 시스템 이해를 맞추기 위한 문서입니다. 발표자료 아니고, 그냥 "이게 뭔지 알고 시작하자"용이에요. 편하게 읽으세요.

---

## 1. 한 줄 요약

**"소방설비 점검을 1년에 1~2번 사람이 하는데, 그 사이에 설비가 서서히 고장 나가는 건 아무도 몰라요. 우리는 그 사이 기간을 센서로 상시 감시합니다."**

이게 전부예요. 나머지는 다 이 한 문장을 구현하는 디테일입니다.

---

## 2. 왜 이걸 만들었나 — 문제의식

소방설비(감지기, 스프링클러, 소화기, 유도등 등)는 법으로 정기점검을 받아야 해요. 근데 이 점검이:

- **작동점검**: 1년에 1번
- **종합점검**: 1년에 1~2번

이게 딱 그 순간의 "스냅샷"이에요. 사진 한 장 찍는 거랑 비슷해요. 근데 실제로 설비가 망가지는 건 사진 찍는 그 순간이 아니라, **점검과 점검 사이 몇 달 동안 서서히** 일어나요. 배선이 부식되거나, 배터리가 조금씩 방전되거나, 배관에서 물이 미세하게 새거나.

법정 점검은 이 "서서히 나빠지는 과정"을 못 봐요. 다음 점검 때 가서야 "어? 이거 왜 이래" 하는 거죠.

**우리 시스템이 하는 일**: 그 사이 기간에 센서를 계속 붙여놓고 데이터를 쌓아서, "이거 서서히 나빠지고 있다"를 미리 잡아내는 거예요. 관리사님을 대체하는 게 아니라, 관리사님이 못 보는 그 빈 시간을 채워주는 보조 시스템이에요.

---

## 3. 전체 그림

```
[센서 5분야] → [각자 담당 ESP32 보드가 판단] → [라즈베리파이 서버로 전송]
                                                        ↓
                                    [데이터 저장 + 필요하면 AI 분석]
                                                        ↓
                              [화면 대시보드 / 경고음 / 스마트폰 알림]
```

자탐, 수계, 가스계, 유도등은 각 구역마다 ESP32 보드가 있어서 WiFi로 서버에 데이터를 보내고, 소화기는 배터리로 돌아가는 작은 보드들이 전력을 아끼려고 더 가벼운 무선 방식(ESP-NOW)으로 근처 게이트웨이한테 보낸 뒤, 게이트웨이가 그걸 모아서 서버로 전달해요.

| 분야 | 뭘 감시하나 |
|---|---|
| 자탐 (화재감지기) | 배선이 서서히 나빠지는지 + 오작동 원인 구분 |
| 수계 (스프링클러 펌프) | 펌프 성능이 기준치를 유지하는지 |
| 가스계 소화설비 (CO2 소화설비) | 가스가 조금씩 빠지고 있는지 |
| 소화기 | 제자리에 잘 있는지 (도난/분실) |
| 유도등 | 배터리가 비상시 20분을 버틸 수 있는 상태인지 |

하나씩 풀어볼게요.

---

## 4. 분야별로 뭘 하는지 (비유로)

### 🔥 자탐 (화재감지기) — "배선 건강검진 + 가짜 신고 구분"

감지기 종류에 따라 두 구역으로 나눠서 다뤄요.

**차동식구역**: 열을 감지하는 방식이에요. 온도가 얼마나 빠르게 오르는지(NTC 서미스터로 측정)를 보고 진짜 화재인지 판단해요. 열원은 열풍기로 재현해요.

**광전식(연기)구역**: 이 구역도 메인은 배선 감시(위와 동일)이고, 여기엔 하나가 더 붙어요. 담배연기나 요리할 때 나는 수증기 때문에 감지기가 괜히 울리는 경우가 많은데(비화재보), 가스 성분(MQ-2)과 습도(DHT22)를 같이 봐서 **"지금 감지기가 오작동할 만한 상황인지"를 참고 정보로 진단**해요. 이건 화재를 판정해서 경보를 울리는 게 아니라(그건 원래 있는 수신기 역할), 감지기가 비화재보 없이 정확히 작동하는지 점검하는 보조 기능이에요.

**공통 로직**: 두 구역 다, 감지기랑 수신반을 잇는 전선에 흐르는 전류/저항을 계속 재서 **서서히 오르는 추세**를 잡아요. 배선이 부식되거나 접촉이 헐거워지면 이 값이 서서히 변하거든요. 혈압을 매일 재면 병 오는 걸 미리 아는 것처럼요. 감지기 모형은 그냥 회로에 저항 하나 얹은 더미(장식)라서, 실제 감지는 별도 센서(NTC/MQ-2/DHT22)가 그 방 전체 공기 상태를 대표해서 재는 거예요.

---

### 💧 수계 (스프링클러 펌프) — "펌프가 제 힘을 내는지 확인 + AI로 상시 검증"

두 계층으로 나눠서 운영해요. 하나가 실패하면 다른 하나로 넘어가는 관계가 아니라, **역할이 다른 두 판정이 동시에 존재**하는 구조예요.

**1차 확인 — 펌프성능시험 원리 참고 (규칙 기반, 대시보드 참고 지표)**

> ⚠️ 이건 소방시설관리사가 하는 공식 법정 점검(연 1~2회)을 대체하는 게 아니에요. 법정 성능시험의 원리(체절/부하 압력 비교)를 **참고해서 축소 재현**하고, 그 결과는 어디까지나 참고용 추세 지표예요. 공식 점검은 그대로 그 주기대로 필요하고, 우리는 그 사이 기간에 이상 징후를 미리 알려주는 보조 역할이에요.

실제 법정 기준: 펌프를 완전히 막았을 때(체절) 압력이 너무 세면 안 되고, 부하를 걸었을 때 압력이 너무 약하면 안 돼요. 우리는 이 원리를 참고해서 축소 재현해요:
1. 밸브를 완전히 잠금 → 펌프 켬 → 최고 압력값 측정 (체절압)
2. 밸브를 열음 → 펌프 계속 작동 중 압력값 측정 (부하압)
3. 이 두 값을 법정 기준, 처음 설치했을 때 기록해둔 값이랑 비교

압력은 배관에 끼운 압력센서로 재고, 밸브는 시연 때 직접 손으로 조작해서 체절/부하 상태를 만들어요. 실제 건물이라면 이 시험은 펌프 마모·방류 비용 때문에 법정 점검 주기(연 1~2회)에만 할 수 있어요.

> 출처: 화재안전기준(NFPC/NFTC) — 체절운전 시 정격토출압력의 140% 초과 금지, 정격토출량 150% 운전 시 정격토출압력의 65% 이상

**2차 판정 — INA219 전류센서 + AI 검증계층 (상시 작동)**
성능시험은 어차피 자주 못 돌리니까, 그 사이 기간(실배포 기준 361일)은 **INA219로 잰 전류 파형을 AI가 상시로 감시**해서 "정상/과부하/공회전"을 판단해요. 이게 원래 우리 프로젝트의 핵심 취지(점검 사이 사각지대를 저비용 센서로 메운다)와 정확히 맞아떨어지는 부분이에요.

> 참고: 처음엔 CT클램프(비접촉식)로 설계했는데, CT클램프는 자기유도 원리라 **직류(DC)를 측정할 수 없다는 걸 뒤늦게 발견**했어요. 우리 펌프는 12V DC라 이대로면 전류값이 아예 안 잡힐 뻔했고, **INA219(전선을 끊어서 직렬로 끼우는 방식)로 교체**해서 해결했어요.

**두 판정이 만나는 지점**: 성능시험을 실행하는 그 짧은 순간(밸브를 조작하는 순간)엔, 압력센서가 "지금 체절/부하 상태다"를 객관적으로 확인해주니까, 그 순간의 INA219 전류 파형에 확실한 정답 라벨(체절→OO, 부하→OO)을 붙일 수 있어요. 즉 **성능시험이 AI 학습 데이터를 검증해주는 역할도 겸해요** — 예전엔 "이 파형이 정상인지 아닌지" 사람이 대충 판단해서 라벨 붙였는데, 이제는 밸브 상태로 객관적으로 확인된 라벨을 쓸 수 있게 된 거예요.

**확인이 아직 필요한 부분**: 밸브를 완전히 잠갔을 때(체절) 펌프 전류가 정말 "과부하"에 해당하는 높은 값으로 나오는지는 펌프 종류에 따라 다를 수 있어요. 원심펌프는 오히려 막았을 때 전류가 낮게 나오는 경우도 있어서, 부품 받으면 제일 먼저 실측으로 확인해봐야 하는 부분이에요. (반대로 나와도 라벨만 바꾸면 되니 로직이 무너지는 건 아니에요)

**보조 지표 — 충압펌프 기동빈도**
배관에 미세누수가 있으면 압력 보충하려고 펌프가 자주 켜졌다 꺼져요. 같은 INA219로 이 패턴도 같이 봐요(전류가 흐르면 펌프 켜짐, 안 흐르면 꺼짐). 타이어에 미세한 구멍 나면 며칠마다 바람을 넣어야 하는 것과 같은 원리예요.

---

### 🧯 가스계 소화설비 (CO2 소화설비) — "저울 위에 올려두고 무게 재기"

가스 소화설비는 압력이 아니라 **무게**로 재야 해요(CO2가 액체+기체로 같이 있어서 압력만으로는 손실량을 못 잡거든요). 저울(로드셀) 위에 용기를 얹어놓고 무게를 계속 재요. **CO2는 무게가 처음보다 10% 이상 줄면 재충전**해야 하는데, 그 10%에 도달하기 며칠 전에 미리 "곧 재충전해야 함"이라고 알려줘요.

> 출처: 소방시설등 점검관리 매뉴얼 — 이산화탄소소화설비 점검표(9-B 소화약제), 소화약제 저장량 점검방법 합격기준 — "이산화탄소는 중량 손실 10% 미만"(불활성가스는 압력손실 5% 미만, 기타 가스계는 압력손실 10% 또는 중량손실 5% 미만으로 CO2와 기준이 다름)

---

### 🧯 소화기 — "누가 들고 가면 바로 알림"

원래 소화기는 게이지 압력을 확인하는 게 점검 항목인데, 게이지가 500원짜리 동전보다 조금 큰 크기라 센서 붙이는 게 물리적으로 너무 어려웠어요. 그래서 방향을 바꿨어요.

→ **압력 대신 "제자리에 있는가"를 감시**해요. 소화기에 작은 가속도 센서를 붙여서, 누가 들어올리는 순간 바로 감지해요. 청소하다 살짝 건드린 것까지 다 경보 울리면 성가시니까, "진짜로 다른 층/구역으로 이동했는지"까지 같이 확인해서(무선 신호가 원래 있던 곳과 끊겼는지) 오작동을 걸러요.

---

### 💡 유도등 — "정전 났을 때 불이 켜질까?"

정전되면 유도등이 배터리로 20분 이상 버텨야 하는데, 이 배터리가 평소엔 멀쩡해 보여도 서서히 열화될 수 있어요. 우리는 배터리 전압을 계속 재서, 서서히 떨어지는 추세를 보고 "이 배터리 곧 문제 생기겠다"를 미리 예측해요. 유도등이 20m마다 여러 개 설치되는 특성상, 멀티플렉서(신호를 순서대로 여러 개 처리해주는 부품) 하나로 ESP32 1개가 여러 유도등을 한꺼번에 처리하도록 설계했어요.

> 출처: 유도등 및 유도표지의 화재안전기준 — 비상전원(배터리) 20분 이상 유효하게 작동

---

## 5. 다 합치면 어디로 가나

각 분야 센서들은 자기 구역 담당 ESP32 보드로 데이터를 보내고, 그게 다시 라즈베리파이(중앙 서버)로 모여요. 거기서:

- 데이터를 계속 저장하고
- 필요한 곳은 AI/통계로 판단하고
- 화면 대시보드에 지도처럼 보여주고
- 이상 있으면 경고음이나 앱 알림을 보내요

---

## 6. AI는 어디에 쓰이나

**"AI가 시스템 전체를 판단한다"가 아니에요.** 판정 대부분은 그냥 "법으로 정해진 기준값보다 큰가 작은가"를 계산식으로 확인하는 거예요 (예: CO2 무게가 10% 이상 줄었나? 체절압이 기준치를 넘었나?). 이게 훨씬 명확하고 설명하기도 쉬워요.

AI가 실제로 필요한 곳은 두 군데예요 — 둘 다 **"여러 값을 동시에 보고 패턴을 구분해야 하는" 문제**라는 공통점이 있어요.

**① 자탐 연기감지기구역 — 오작동(비화재보) 판별**
온도 상승률(NTC), 가스 농도(MQ-2), 습도(DHT22) 세 가지 값을 동시에 보고 "진짜 화재냐, 요리하다 난 연기냐"를 구분해요. 조건이 여러 개 얽혀있어서 단순 if문으로는 깔끔하게 안 나뉘어요.

**② 수계 — 펌프 전류 파형으로 정상/과부하/공회전 구분**
INA219로 잰 전류 파형의 모양을 보고 펌프 상태를 분류해요. 이건 성능시험(체절/부하 시험)이 도는 그 순간에 확실한 정답 라벨을 붙여서 학습하고, 평소에는 이 모델이 상시로 돌면서 INA219만으로 펌프 상태를 계속 감시해요.

**나머지(추세 예측)는 AI 없이 파이썬 몇 줄로 충분해요**
- 자탐 배선 저항이 서서히 오르는 추세
- 유도등 배터리 전압이 서서히 떨어지는 추세
- 가스계 무게가 서서히 줄어드는 추세

이런 건 "값이 시간에 따라 어떻게 변하는지" 점 몇 개를 직선으로 이어서, 그 직선이 언제 기준선에 닿을지 계산하는 **회귀분석**으로 풀려요. `numpy.polyfit` 한 줄이면 되는 수준이라 AI 담당이 아니어도 누구나 짤 수 있어요:

```python
import numpy as np
a, b = np.polyfit(경과일_리스트, 측정값_리스트, 1)  # 직선의 기울기(a)와 절편(b) 구하기
도달예상일 = (기준값 - b) / a
```

학습 데이터를 모아서 훈련시키는 AI랑 다르게, 이건 그냥 수학 공식이라 데이터가 몇 개만 있어도 바로 계산돼요.

**정리하면**: AI는 "자탐 오작동 판별"과 "수계 펌프 상태 분류" 두 곳에 쓰고, 나머지 추세 예측은 회귀분석(파이썬 몇 줄)으로 처리하는 걸로 방향을 잡았어요.

---

## 7. 부품 오기 전까지 다 같이 할 수 있는 것

역할을 미리 딱딱 나누기보다, 지금 이 시점에 부품 없이도 할 수 있는 일들이에요. 관심 가는 것부터 편하게 붙잡으면 될 것 같아요.

- **코드 뼈대 짜기**: 센서값 읽는 부분, 판정 로직(if문), 서버로 데이터 보내는 부분 — 실제 센서 대신 임시로 가짜 값 넣어서 흐름만 먼저 만들어두면 부품 오자마자 바로 연결 가능
- **라즈베리파이 서버 준비**: 데이터 받아서 저장하고, 화면에 보여주는 부분 — 센서 부품이랑 무관하게 지금 바로 시작 가능
- **개발완료보고서 작성**: 개발개요, 개발환경, 기능설계도, 차별성, 파급효과 항목 — 지금까지 정리된 자료로 대부분 채울 수 있어요
- **배선 체크리스트 정리**: 부품 오는 순간 바로 조립 시작할 수 있게, 어떤 핀에 뭘 연결할지 미리 문서로 정리해두기

다들 이 중에서 관심 가거나 자신 있는 거 골라서 시작하면 되고, 겹쳐도 상관없어요 — 어차피 다 같이 봐야 할 부분들이라.

---

*질문 있으면 언제든 편하게 물어보세요.*
