Billiardchalktheif/2026ESWContest_free_bulchimbeon/simulation/라즈베리파이 검증 로그.md

*C:\Users\khjzz>cd C:\임베디드 sw 경진대회\bulchimbeon_sw
C:\임베디드 sw 경진대회\bulchimbeon_sw> 
이런식으로 코드가 들어가있는 파일로 경로를 바꾼 후 진행해야함!

# 0) requirements 설치치

-  pip install -r requirements.txt

C:\임베디드 sw 경진대회\bulchimbeon_sw>pip install -r requirements.txt
Defaulting to user installation because normal site-packages is not writeable
Requirement already satisfied: numpy in C:\Users\khjzz\AppData\Roaming\Python\Python314\site-packages (from -r requirements.txt (line 1)) (2.5.1)
Requirement already satisfied: pandas in C:\Users\khjzz\AppData\Roaming\Python\Python314\site-packages (from -r requirements.txt (line 2)) (3.0.5)
Requirement already satisfied: scikit-learn in C:\Users\khjzz\AppData\Roaming\Python\Python314\site-packages (from -r requirements.txt (line 3)) (1.9.0)
Requirement already satisfied: joblib in C:\Users\khjzz\AppData\Roaming\Python\Python314\site-packages (from -r requirements.txt (line 4)) (1.5.3)
Requirement already satisfied: flask in C:\Users\khjzz\AppData\Roaming\Python\Python314\site-packages (from -r requirements.txt (line 5)) (3.1.3)
Requirement already satisfied: python-dateutil>=2.8.2 in C:\Users\khjzz\AppData\Roaming\Python\Python314\site-packages (from pandas->-r requirements.txt (line 2)) (2.9.0.post0)
Requirement already satisfied: tzdata in C:\Users\khjzz\AppData\Roaming\Python\Python314\site-packages (from pandas->-r requirements.txt (line 2)) (2026.3)
Requirement already satisfied: scipy>=1.10.0 in C:\Users\khjzz\AppData\Roaming\Python\Python314\site-packages (from scikit-learn->-r requirements.txt (line 3)) (1.18.0)
Requirement already satisfied: narwhals>=2.0.1 in C:\Users\khjzz\AppData\Roaming\Python\Python314\site-packages (from scikit-learn->-r requirements.txt (line 3)) (2.24.0)
Requirement already satisfied: threadpoolctl>=3.5.0 in C:\Users\khjzz\AppData\Roaming\Python\Python314\site-packages (from scikit-learn->-r requirements.txt (line 3)) (3.6.0)
Requirement already satisfied: blinker>=1.9.0 in C:\Users\khjzz\AppData\Roaming\Python\Python314\site-packages (from flask->-r requirements.txt (line 5)) (1.9.0)
Requirement already satisfied: click>=8.1.3 in C:\Users\khjzz\AppData\Roaming\Python\Python314\site-packages (from flask->-r requirements.txt (line 5)) (8.4.2)
Requirement already satisfied: itsdangerous>=2.2.0 in C:\Users\khjzz\AppData\Roaming\Python\Python314\site-packages (from flask->-r requirements.txt (line 5)) (2.2.0)
Requirement already satisfied: jinja2>=3.1.2 in C:\Users\khjzz\AppData\Roaming\Python\Python314\site-packages (from flask->-r requirements.txt (line 5)) (3.1.6)
Requirement already satisfied: markupsafe>=2.1.1 in C:\Users\khjzz\AppData\Roaming\Python\Python314\site-packages (from flask->-r requirements.txt (line 5)) (3.0.3)
Requirement already satisfied: werkzeug>=3.1.0 in C:\Users\khjzz\AppData\Roaming\Python\Python314\site-packages (from flask->-r requirements.txt (line 5)) (3.1.8)
Requirement already satisfied: colorama in C:\Users\khjzz\AppData\Roaming\Python\Python314\site-packages (from click>=8.1.3->flask->-r requirements.txt (line 5)) (0.4.6)
Requirement already satisfied: six>=1.5 in C:\Users\khjzz\AppData\Roaming\Python\Python314\site-packages (from python-dateutil>=2.8.2->pandas->-r requirements.txt (line 2)) (1.17.0)

---

# 1) DB 생성
 - python server/storage/db.py

C:\임베디드 sw 경진대회\bulchimbeon_sw>python server/storage/db.py
DB 초기화 완료: C:\임베디드 sw 경진대회\bulchimbeon_sw\server\storage\bulchimbeon.db

---
# 2) 수신 서버 실행 (터미널 A, 실제로는 라즈베리파이에서 상시 구동)

 - python server/main.py

C:\임베디드 sw 경진대회\bulchimbeon_sw>python server/main.py
UDP 수신 대기 중: 0.0.0.0:9000
[ALERT:caution] fire_alarm/A구역(정상): 루프 저항 z-score 이상 감지 (z=1.91, 저항=20.67Ω, 상태=caution)
[알림-LCD] (LCD 없는 개발환경 - 콘솔로 대체) fire_alarm/A구역(정상): 루프 저항 z-score 이상 감지 (z=1.91, 저항=20.67Ω, 상태=caution)
[ALERT:caution] fire_alarm/광전식구역: 루프 저항 z-score 이상 감지 (z=4.40, 저항=20.73Ω, 상태=caution)
[알림-LCD] (LCD 없는 개발환경 - 콘솔로 대체) fire_alarm/광전식구역: 루프 저항 z-score 이상 감지 (z=4.40, 저항=20.73Ω, 상태=caution)
[ALERT:alarm] evac_light/1층 복도: 실측 방전지속시간 19.0분 - 법정 최소 20분 미달
[알림-부저] (GPIO 없는 개발환경 - 콘솔로 대체)
[알림-LCD] (LCD 없는 개발환경 - 콘솔로 대체) evac_light/1층 복도: 실측 방전지속시간 19.0분 - 법정 최소 20분 미달
[ALERT:alarm] extinguisher/창고 4: 소화기 이탈 확정 - 마지막 중계 게이트웨이: gw_01
[알림-부저] (GPIO 없는 개발환경 - 콘솔로 대체)
[알림-LCD] (LCD 없는 개발환경 - 콘솔로 대체) extinguisher/창고 4: 소화기 이탈 확정 - 마지막 중계 게이트웨이: gw_01

---
# 3) 더미 데이터 전송 (터미널 B)

- python simulate/dummy_generator.py --all

C:\임베디드 sw 경진대회\bulchimbeon_sw>python simulate/dummy_generator.py --all
[수계-분류] 180개 파형 전송 완료 (정상/과부하/공회전 각 60개)
[수계-충압펌프] 기동주기 40회 전송 완료 (후반부 미세누수 재현)
[수계-성능시험] 체절/부하/공회전 각 40개 전송 완료 (valve_state는 서버가 압력값으로 추정 - dryrun만 예외)
[자탐] 100개 시점 전송 완료 (A=정상 / B=점진적 열화)
[자탐2-비화재보] fire/cooking/normal 각 60개 전송 완료 (label 자동부여)
[가스계] 60일치 중량 데이터 전송 완료 (gas_type=co2)
[유도등] 60일치 배터리 전압 데이터 전송 완료
[유도등-데모방전시험] evac_light_01 30개 샘플 전송 완료 (목표 잔여시간 약 18분 재현)
[소화기] 4개 노드 이탈감지 시나리오 전송 완료 (ext_02=오탐으로 무시되어야 함 / ext_04=이탈 확정되어야 함)

---
# 4) AI 모델 학습 (성능시험/비화재보 라벨 우선) -> server/judge/ai_models/에 저장됨

- python ml/train_pump_classifier.py

C:\임베디드 sw 경진대회\bulchimbeon_sw>python ml/train_pump_classifier.py
[정보] 성능시험 라벨 354개로 학습 (신뢰도 우선, manual 라벨 미포함)
==================================================
학습 데이터: 265개 / 테스트 데이터: 89개
==================================================

[분류 리포트]
                  precision    recall  f1-score   support

         dry_run       1.00      1.00      1.00        30
normal_operation       1.00      1.00      1.00        30
 stall_operation       1.00      1.00      1.00        29

        accuracy                           1.00        89
       macro avg       1.00      1.00      1.00        89
    weighted avg       1.00      1.00      1.00        89

[혼동 행렬] (행=실제, 열=예측)
        dry_run  normal_operation  stall_operation
  dry_run        30          0          0
normal_operation         0         30          0
stall_operation         0          0         29

[Feature importance] - 왜 이렇게 판정했는지 설명하는 근거
  rms          0.455 ##################
  peak         0.411 ################
  duty_cycle   0.134 #####

모델 저장 완료: C:\임베디드 sw 경진대회\bulchimbeon_sw\server\judge\ai_models\pump_classifier.joblib

---
- python ml/train_nuisance_classifier.py
C:\임베디드 sw 경진대회\bulchimbeon_sw>python ml/train_nuisance_classifier.py
==================================================
학습 데이터: 405개 / 테스트 데이터: 135개
==================================================

[분류 리포트]
              precision    recall  f1-score   support

     cooking       1.00      1.00      1.00        45
        fire       1.00      1.00      1.00        45
      normal       1.00      1.00      1.00        45

    accuracy                           1.00       135
   macro avg       1.00      1.00      1.00       135
weighted avg       1.00      1.00      1.00       135

[혼동 행렬] (행=실제, 열=예측) - fire/cooking 신호가 겹치면 여기 바로 드러남
        cooking       fire     normal
  cooking        45          0          0
     fire         0         45          0
   normal         0          0         45

[Feature importance] - 왜 이렇게 판정했는지 설명하는 근거
  temp_rise_rate 0.360 ##############
  mq2_raw        0.355 ##############
  humidity_pct   0.284 ###########

모델 저장 완료: C:\임베디드 sw 경진대회\bulchimbeon_sw\server\judge\ai_models\nuisance_classifier.joblib

---
# 5) 대시보드 실행 (터미널 C) -> http://localhost:5000

- python dashboard/app.py

C:\임베디드 sw 경진대회\bulchimbeon_sw>python dashboard/app.py
 * Serving Flask app 'app'
 * Debug mode: on
WARNING: This is a development server. Do not use it in a production deployment. Use a production WSGI server instead.
 * Running on all addresses (0.0.0.0)
 * Running on http://127.0.0.1:5000
 * Running on http://172.16.239.40:5000
Press CTRL+C to quit
 * Restarting with stat
 * Debugger is active!
 * Debugger PIN: 108-448-140
172.16.239.40 - - [05/Aug/2026 18:03:30] "GET / HTTP/1.1" 200 -
172.16.239.40 - - [05/Aug/2026 18:03:36] "GET / HTTP/1.1" 200 -
172.16.239.40 - - [05/Aug/2026 18:03:41] "GET / HTTP/1.1" 200 -
172.16.239.40 - - [05/Aug/2026 18:03:46] "GET / HTTP/1.1" 200 -
172.16.239.40 - - [05/Aug/2026 18:03:51] "GET / HTTP/1.1" 200 -
172.16.239.40 - - [05/Aug/2026 18:03:56] "GET / HTTP/1.1" 200 -
172.16.239.40 - - [05/Aug/2026 18:04:01] "GET / HTTP/1.1" 200 -
172.16.239.40 - - [05/Aug/2026 18:04:07] "GET / HTTP/1.1" 200 -
172.16.239.40 - - [05/Aug/2026 18:04:12] "GET / HTTP/1.1" 200 -
... 계속 나옴

---
# 6) 자탐 z-score 판정 검증

- python simulate/verify_fire_alarm_zscore.py

C:\임베디드 sw 경진대회\bulchimbeon_sw>python simulate/verify_fire_alarm_zscore.py
[ALERT:caution] fire_alarm/B구역(열화재현): 루프 저항 z-score 이상 감지 (z=1.87, 저항=21.58Ω, 상태=caution)
[알림-LCD] (LCD 없는 개발환경 - 콘솔로 대체) fire_alarm/B구역(열화재현): 루프 저항 z-score 이상 감지 (z=1.87, 저항=21.58Ω, 상태=caution)
[ALERT:caution] fire_alarm/A구역(정상): 루프 저항 z-score 이상 감지 (z=-3.97, 저항=19.19Ω, 상태=caution)
[알림-LCD] (LCD 없는 개발환경 - 콘솔로 대체) fire_alarm/A구역(정상): 루프 저항 z-score 이상 감지 (z=-3.97, 저항=19.19Ω, 상태=caution)

[fire_zone_A] 상태 이력 (뒤 20개): ['normal', 'normal', 'normal', 'normal', 'normal', 'normal', 'normal', 'normal', 'normal', 'normal', 'normal', 'normal', 'normal', 'normal', 'normal', 'normal', 'normal', 'normal', 'normal', 'normal']
  [PASS] alarm 비율=0%, caution 비율=7% (지속성 조건으로 오경보 억제됨)

[fire_zone_B] 상태 이력 (뒤 20개): ['normal', 'normal', 'caution', 'caution', 'normal', 'normal', 'caution', 'alarm', 'caution', 'caution', 'caution', 'caution', 'caution', 'normal', 'normal', 'normal', 'normal', 'normal', 'normal', 'normal']
  [PASS] caution -> alarm 전이 확인됨

---

# 7) 가스계/유도등 회귀 예측 정확도 검증 (개발완료보고서 근거자료)

- python ml/evaluate_predictions.py

C:\임베디드 sw 경진대회\bulchimbeon_sw>python ml/evaluate_predictions.py
============================================================
예측 정확도 검증 - 앞 70% 데이터로 예측, 뒤 30%로 실측 비교
============================================================
[가스계] 케이스 8개 / MAE = 0.77일 (평균 오차율 6.7%)
[유도등(predicted_days_to_replace)] 케이스 8개 / MAE = 0.62일 (평균 오차율 2.2%)

JSON 저장: C:\임베디드 sw 경진대회\bulchimbeon_sw\ml\prediction_accuracy.json
CSV 저장: C:\임베디드 sw 경진대회\bulchimbeon_sw\ml\prediction_accuracy.csv
