Billiardchalktheif/2026ESWContest_free_bulchimbeon/data/차동식 엣지/차동식_실험보고서.md

# 자탐1(차동식구역) 온도 상승률 판정 임계값 설계 실험보고서

| 항목 | 내용 |
|---|---|
| 실험 일자 | 2026-08-23 |
| 실험 대상 | 자탐1 (차동식 화재감지 구역, `fire_alarm_differential_node.ino`) |
| 실험자 | 하드웨어/실험 담당 |
| 목적 | NTC 온도센서 raw↔℃ 캘리브레이션 및 "감지기의 형식승인 및 검정기술기준" 제14조 기반 화재 판정(온도 상승률) 임계값 확정 |
| 관련 원본 데이터 | `raw/`, `originals/` (본 폴더) |

## 1. 실험 목적 및 배경

### 1-1. 왜 "상승률" 기준인가

자탐1은 `zone_type = differential`(차동식)로 분류되며, 차동식 감지기는 절대온도가 아니라 **단위시간당 온도 상승 속도(℃/min)** 로 화재를 판정해야 한다. 절대온도 고정 임계값 방식(예: "25℃ 넘으면 경보")은 정온식 감지기의 판정 방식이며, 차동식에 적용하면 규정에 어긋난다.

### 1-2. 근거 규정

"감지기의 형식승인 및 검정기술기준" 제14조(차동식스포트형감지기의 감도시험)에 따른 1종 기준:

| 종별 | 작동시험 상승률 T(℃/min) | 작동 제한시간 M(분) | 부작동시험 상승률 t(℃/min) | 부작동 유지시간 m(분) |
|---|---|---|---|---|
| 1종 | 10 이상 | 4.5 | 2 이하 | 15 |

설계 목표: **10℃/min 이상 상승 시 화재로 판정(4.5분 이내 응답)**, **2℃/min 이하 상승은 15분간 유지되어도 오작동 금지**.

### 1-3. 핵심 설계 원칙

판정 로직은 "부작동시험용"과 "작동시험용"으로 나뉜 두 개의 별도 알고리즘이 아니라, 하나의 상시 임계값 함수(`evaluate_temp_rise_rate()`)가 양쪽 기준을 동시에 만족하도록 설계된다. 부작동시험/작동시험은 이 하나의 로직에 서로 다른 물리적 자극(완만한 상승 vs 급격한 상승)을 가해 검증하는 절차일 뿐이다.

## 2. 실험 방법

총 5개 실험을 순서대로 진행했다. 열원은 가정용 열풍기(1단, 저출력)를 사용했고, 온도 측정은 시판 디지털 온도계로 수기 기록했다. ESP32 노드는 ADS1115(16bit ADC)로 NTC 전압을 5초 간격으로 측정해 UDP로 전송하며, 시리얼 로그에도 동일 데이터를 출력하도록 구성했다.

| # | 실험명 | 방법 | 지속시간 |
|---|---|---|---|
| 1 | 무반응시험 | 열원 없이 상온 방치, raw 노이즈 바닥 확인 | 15분 |
| 2 | 부작동시험 1회 | 열풍기를 짧게 여러 번 분사(간헐적 버스트)해 완만한 상승 재현 시도 | 15분 |
| 3 | 부작동시험 2회 | 열풍기 1단 고정, 거리를 초반에 맞춘 뒤 건드리지 않고 15분 유지(연속 저출력) | 15분 |
| 4 | 작동시험 1회 | 열풍기를 거리 바꿔가며 연속으로 조사("와리가리"), 중단 없이 진행 | 2분 |
| 5 | 작동시험 2회 | 열풍기 1분 고정 조사 후 중단, 나머지는 자연 냉각 관찰 | 약 7.3분(가열 1분+냉각) |

실험 3의 median filter 관련 노트: 실험 3 진행 중 raw 로그에서 실제 온도 변화로 설명되지 않는 단일 샘플 이상치(주변 대비 150~420raw 이탈)가 다수 발견되어, 이후 `measureTempC()`를 단일 ADC 읽기에서 **10회 측정 후 중앙값(median)** 방식으로 교체했다. 실험 4, 5는 이 수정 이후 진행됐다.

## 3. 실험 결과

### 3-1. 실험 1 — 무반응시험

15분간 무열원 상태에서 raw는 8518~8601 사이(폭 83)에서 미세하게 흔들렸고, 5초 구간 변화량은 -54~+32 범위였다. 이 값이 "아무 일도 없을 때의 노이즈 바닥"이며, 판정 임계값은 이 폭보다 확실히 커야 한다.

### 3-2. 실험 2 — 부작동시험 1회 (간헐적 버스트) — 방법론 부적합, 참고용

간헐적으로 열풍기를 분사한 결과 실측온도가 22.6~28.6℃ 사이에서 크게 출렁였고, 구간 최대 상승률이 **+10.2℃/min**(9분→9분30초, 23.5→28.6℃)로 나타났다. 이는 오히려 "작동시험" 기준(10℃/min)에 해당하는 수치로, **부작동시험이 요구하는 "2℃/min 이하로 완만하게, 15분간"이라는 시험 조건 자체를 충족하지 못했다.** 즉 이 실험은 방법론이 부적합해 부작동시험 통과/실패 판정 근거로 사용할 수 없으며, raw↔℃ 관계 파악을 위한 참고 데이터로만 남긴다(전체 구간 회귀: raw ≈ -102.3×℃ + 10881.2, R²=0.639, 낮은 신뢰도).

### 3-3. 실험 3 — 부작동시험 2회 (고정저출력 연속) — 방법론 충족

열풍기 거리를 고정하고 건드리지 않은 결과, 실측온도는 22.9~24.8℃ 사이에서 완만하게 움직였고 구간 최대 상승률은 **+2.00℃/min**(9분→9분30초, 23.8→24.8℃)로 규정 상한(2℃/min)에 정확히 걸쳤다. 15분 내내 이를 초과하는 구간이 없어 **부작동시험의 물리적 조건(t=2, m=15)은 충족**된 것으로 판단한다.

다만 raw 로그에는 실제 온도 변화로 설명되지 않는 단일 샘플 이상치가 다수 관측됐다(§4-3 참고). 이 데이터에 최종 확정 임계값(`ALARM_RAW_DROP_PER_WINDOW=500`, 20초 창)을 그대로 적용해보면, **20초 창 기준 최대 raw 하락폭이 554로 임계값을 초과**한다(00:05:35 부근, 노이즈 스파이크 구간). 즉 이 raw 원본을 그대로 판정 로직에 흘렸다면 부작동시험 도중 오탐(false alarm)이 발생했을 수 있다는 뜻이다. 이 발견이 median filter 도입의 직접적 근거가 됐다(§5-3).

### 3-4. 실험 4 — 작동시험 1회 (2분 연속 와리가리)

실측온도가 22.2℃에서 120초 만에 106.6℃까지 상승했다(구간 최대 상승률 238.2℃/min). raw는 9684에서 1493까지 하락했고, **20초 창 기준 최대 raw 하락폭은 4580**으로 확정 임계값(500)의 약 9배에 달한다.

### 3-5. 실험 5 — 작동시험 2회 (1분 가열 + 냉각) — 캘리브레이션 채택 데이터

열풍기를 1분간 고정 조사한 후 중단, 이후 약 6분간 자연 냉각을 관찰했다. 실측온도는 22.5℃에서 70초 만에 78.3℃까지 상승한 뒤 서서히 냉각해 440초 시점에 22.5℃까지 복귀했다. raw는 최저 1533까지 하락했으며, **20초 창 기준 최대 raw 하락폭은 7708**로 확정 임계값의 약 15배에 달한다.

## 4. 캘리브레이션 분석 (raw ↔ ℃)

### 4-1. 손 온도계와 임베디드 NTC의 열적 반응 지연(hysteresis) 발견

실험 5 데이터에서 raw가 가장 낮은(가장 뜨거운) 시점은 61초인데, 실측 온도계의 최고점은 70초로 **9초의 시차**가 있었다. 더 결정적으로, **같은 실측 23.5~23.6℃ 구간**임에도:

- 가열 초반(26초, 온도가 오르는 중): raw ≈ 9301
- 냉각 후반(291~301초, 온도가 내려가는 중): raw ≈ 8111~8212

동일 온도에서 raw가 1000 이상 차이 났다. 이는 측정 노이즈가 아니라, 손 온도계(반응이 빠름)와 인클로저 안에 있는 임베디드 NTC(열용량이 커서 반응이 느림)의 열적 반응 속도 차이로 발생하는 이력현상(hysteresis)으로 판단된다.

**결론: 냉각 구간 데이터는 raw↔℃ 캘리브레이션에서 제외하고, 가열(상승) 구간 데이터만 사용한다.**

### 4-2. 회귀 결과 비교

실측온도를 시리얼 로그 시각에 선형보간해 raw와 대응시킨 뒤 회귀분석한 결과는 다음과 같다.

| 데이터 | 구간 | 슬로프 (raw/℃) | 절편 | R² | 채택 |
|---|---|---|---|---|---|
| 부작동시험 1회 | 전체 (22.6~28.6℃) | -102.3 | 10881.2 | 0.639 | 참고용(방법론 부적합) |
| 부작동시험 2회 | 전체 (22.9~24.8℃) | -207.8 | 13350.2 | 0.523 | 참고용(노이즈 스파이크로 신뢰도 낮음) |
| 작동시험 1회 | 전체 (22.2~106.6℃) | -99.8 | 11643.0 | 0.946 | 참고용(온도범위 과도하게 넓어 NTC 비선형성 영향) |
| 작동시험 2회 | 전체(가열+냉각, 22.5~78.3℃) | -125.5 | 11091.1 | 0.855 | 참고용(냉각구간 hysteresis 오염) |
| **작동시험 2회** | **상승구간만 (22.5~78.3℃, ≤70s)** | **-138.6** | **12769.5** | **0.956** | **✅ 최종 채택** |

NTC 서미스터는 저항-온도 관계가 원래 비선형(지수적)이라, 22~106℃처럼 넓은 범위를 하나의 직선으로 피팅하면 범위에 따라 로컬 기울기가 달라진다. 판정 로직이 실제로 신경 써야 하는 구간은 상온(20~30℃대)에서 상승이 막 시작되는 초반이므로, 상온에 가장 가까운 상승구간 데이터를 최종치로 채택했다.

### 4-3. 이 오차가 실제 판정에 영향을 주는가

슬로프 추정치가 실험마다 -99.8~-207.8로 흔들리지만, 이 불확실성이 알람 판정에 미치는 영향은 다음 마진 비교로 확인했다.

10℃/min(작동시험 기준)을 raw/20초창으로 환산하면 슬로프에 따라 약 333~692 raw/20초 수준이다. 반면 실제 작동시험에서 관측된 raw 하락폭은 20초 창 기준 4580~7708로, 계산상 임계값의 **최소 7배 이상**에 달한다. 슬로프 추정에 다소 오차가 있어도 실화재를 놓칠 위험은 낮다고 판단한다.

다만 부작동시험(2회) 원본에서는 노이즈로 인한 20초창 최대 하락폭이 554까지 나와, 확정 임계값(500)을 근소하게 초과했다(§3-3). 이는 실화재 미탐지보다 **오탐(false alarm) 리스크**에 해당하며, median filter 적용으로 완화될 것으로 기대되나 필터 적용 후 재검증은 아직 수행하지 않았다(§6 한계 참고).

## 5. 펌웨어 개선 이력

### 5-1. 원시 ADC 값 보존

기존에는 온도값(℃) 계산 결과만 로깅했으나, 캘리브레이션을 위해 `temp_raw_adc`, `temp_v` 원시값을 별도로 로깅/전송하도록 `measureTempC()`, `sendPacket()`을 수정했다.

### 5-2. 경과시간 로깅 추가

수기로 측정하는 실측온도와 로그를 시간축으로 대조할 수 있도록 `boot=HH:MM:SS` 형식의 부팅 경과시간을 시리얼 로그와 패킷(`boot_elapsed_ms`)에 추가했다.

### 5-3. 중앙값 필터 적용

실험 3(부작동시험 2회) 진행 중 실제 온도 변화로 설명되지 않는 단일 샘플 raw 이상치(주변 대비 150~420raw 이탈)가 다수 발견됐다. 평균 필터는 이상치를 1/N로 희석할 뿐 완전히 제거하지 못하므로, `measureTempC()`를 10회 측정 후 정렬해 중앙값을 취하는 방식으로 교체했다. 실험 4, 5는 이 수정 적용 후 진행됐으며, 육안상 단일 샘플 스파이크 빈도가 눈에 띄게 줄었다.

## 6. 결론 및 최종 확정 값

| 상수 | 값 | 근거 |
|---|---|---|
| `TEMP_RAW_PER_C` | -139.0 (반올림) | §4-2 작동시험 2회 상승구간 회귀 |
| `RATE_WINDOW_SAMPLES` | 5 (20~25초 창) | 무반응시험 노이즈 폭(§3-1) 대비 충분히 큰 창 확보 |
| `ALARM_RAW_DROP_PER_WINDOW` | 500 | 제14조 1종 10℃/min 환산치(약 333~692) 대비 여유 있는 하한 + 실제 화재 재현 시 마진 7배 이상(§4-3) 확인 |

이 값들은 `server/judge/`의 `evaluate_temp_rise_rate()` 함수에 반영되며, 판정 로직 자체는 점검모드 여부와 무관하게 항상 동일하게 동작하도록 설계했다(별도 문서 `자탐1_온도상승률_판정로직_소프트웨어_인수인계.md` 참고).

## 7. 한계 및 후속 과제

- **부작동시험 재검증 미실시**: median filter 적용 이전 데이터(실험 3)에서 확정 임계값 기준 오탐 가능 구간(554 > 500)이 발견됐다. 필터 적용 후 동일 조건(15분, 2℃/min 이하 완만 상승)으로 재실험해 오탐이 실제로 해소됐는지 확인하는 절차가 남아 있다. 시간이 허락한다면 우선순위가 가장 높은 후속 실험이다.
- **저온구간 상승 데이터 부족**: 최종 채택 회귀(§4-2)에 사용된 상승구간 실측 포인트가 4개뿐이라(22.7/22.8/24.1/26.1℃), 정밀도를 높이려면 20~40℃대에서만 서서히(1분 이상) 가열하는 보충 실험이 이상적이다. 다만 §4-3의 마진 분석상 필수는 아니다.
- **WiFi 미연결 상태**: 모든 실험에서 `WIFI_SSID`/`WIFI_PASS`가 placeholder라 매 5초 재연결 시도 로그가 발생했다. 통합테스트 전 실 자격증명으로 교체가 필요하다.
