Billiardchalktheif/2026ESWContest_free_bulchimbeon/data/가스계 엣지/가스계_캘리브레이션_결과_정리.md

# 가스계(CO2) 노드 — 캘리브레이션 최종 정리

**작성일**: 2026-08-21
**대상 파일**: `gas_node.ino`
**테스트 기간**: 2026-08-17 16:30 (SET_TIME) ~ 2026-08-21 (약 3.85일)
**테스트 방식**: 실제 CO2 용기 대신 자동 방향제 분사기(7분 30초 간격 분사)를 무게손실 시뮬레이션용 대체물로 사용

---

## 1. 하드웨어 이슈 및 해결

- 로드셀(10kg 바형 2개 병렬) 신호선(흰/초록) 접촉불량 발견 — 손으로 흔들 때 raw 값이 -1.5M~-3.2M까지 튀는 것으로 진단(정상 범위 ±650K 근처). 실시간 진단용 `MONITOR`/`STOP` 시리얼 명령으로 배선 4가닥을 개별로 흔들어보며 원인 특정.
- 원인: E+/E- (전원)보다 A+/A- (신호선)이 HX711 내부에서 ~128배 증폭되기 때문에 접촉저항 영향이 훨씬 크게 증폭됨.
- 조치: 신호선 납땜 처리 → 흔들림 테스트 시 편차가 ±162g 수준에서 ±16g 수준으로 개선 확인.
- **캘리브레이션 계수 변경 이력**: `420.0`(임시값) → `93.07`(502g 실측 역산) → **`87.9`**(납땜 후 재캘리브레이션, 501g 실측 기준). *하드웨어를 물리적으로 만질 때마다(납땜 등) raw 신호 특성이 바뀌므로 재캘리브레이션이 필요했음.*

## 2. 온도 드리프트 발견 (중요 — 소프트웨어팀 공유 필요)

- 테스트 도중 에어컨을 껐다 켰다 하면서 로드셀 판독값이 최대 ±50g 수준으로 요동치는 현상 발견.
- 실측(전자저울) 대조로 확인:
  - 테스트 시작 시점 실측: **501g**
  - 테스트 종료 시점 실측: **458g**
  - 같은 시점 시스템 판독값(에어컨 off 누적 상태): **~407g** → 시스템이 실제보다 약 50g 낮게 표시하는 절대오차 확인
- 원인: 로드셀(스트레인게이지)과 HX711 모두 온도 의존적 드리프트가 있음 — 저가 바형 로드셀은 온도보상이 부실해 영향이 큼.
- **중요**: 이 오차는 배율(calibration factor) 오차가 아니라 **영점(TARE) 오차**라서 %손실 계산에서 상쇄되지 않음. 절대 중량값의 신뢰도에 직접 영향을 줌.
- 완화책: 에어컨을 상시 가동해 온도를 안정시킨 구간만 분리해서 분석에 사용(§3).
- **향후 과제**: 서미스터 보유 중이나 이번 일정상 온도보상 로직은 미구현. 온도센서 기반 보정(raw 보정, `initial` 기준선은 건드리지 않는 방식) 또는 주기적 실측 대조+오프셋 보정 절차 도입이 필요. 실제 CO2 저장실은 법적으로 40도 이하 유지 의무가 있어 이번 책상 테스트보다는 온도 변동폭이 작을 것으로 예상되나, 근본 해결은 아님.

## 3. 회귀분석 검증 결과

- 전체 로그(817개 유효 포인트, 5분 간격) 중 에어컨을 상시 가동해 온도가 안정적이었던 구간(2026-08-20 14:00 ~ 종료, 약 22.8시간)만 추려서 검증.
- 이 구간의 **앞 70%**만으로 1차 선형회귀를 학습시켜 "10% 손실 임계값(450.9g, 시작 실측 501g 기준) 도달 시점"을 예측하고, 나머지 구간에서 실제 도달 시점과 대조:

| 항목 | 값 |
|---|---|
| 회귀 적합도 (R², 학습 구간) | 0.951 |
| 기울기 | -4.88 g/h (-117.0 g/day) |
| 예측 도달 시점 | 청정구간 시작 +7.85h |
| 실제 도달 시점 | 청정구간 시작 +8.67h |
| **예측 오차** | **약 49분** |

→ 짧은 구간의 데이터만으로도 향후 임계값 도달 시점을 신뢰할 만한 정확도로 예측 가능함을 실측으로 확인.

- 실측 anchor(501g → 458g) 기준 전체 헤드라인 수치:
  - 3.85일간 실측 손실률 **8.58%** (환산 **2.23%/day**)
  - 이 속도 유지 시 10% 도달까지 총 **4.48일** 소요 예상

## 4. 소프트웨어팀 전달 사항 — `gas_node.ino` 확정 설정값

```cpp
const int   HX711_DOUT_PIN = 16;
const int   HX711_SCK_PIN  = 17;
const float DEFAULT_CALIBRATION_FACTOR = 87.9;   // 납땜 후 재캘리브레이션 확정값
const byte  AVG_SAMPLES = 30;                    // 노이즈 저감용 평균 샘플 수
```

- `initialWeightG`은 ESP32 Preferences(NVS)에 저장되며, **설치 시 반드시 `TARE` → `SET_INITIAL` 순서로 현장에서 재설정 필요** (이 문서의 87.9는 로드셀 계수일 뿐, 기준중량은 설치 환경마다 다시 잡아야 함).
- 서버(`bulchimbeon_sw/server/judge/regression.py`)에 이미 있는 확인 필요 항목 재확인 요청:
  1. **공병중량 미차감 이슈**: 손실률은 총중량이 아니라 "총중량 − 공병중량"(약제중량) 기준으로 계산해야 함(v7 버그수정 코멘트 참고). 이번 방향제 테스트 리그는 공병중량을 별도 실측하지 않아 이 보정을 적용하지 못했음 — 실제 CO2 용기 설치 시 `EMPTY_CONTAINER_WEIGHT_G` 실측 필수.
  2. **임계값 확정 필요**: 소방시설 점검관리 매뉴얼 1권은 CO2 중량손실 10%, 2권은 5%로 기준이 달라 팀 확인 대기 중(코드 주석에도 명시됨). 확정 전까지는 보수적으로 낮은 값(5%) 기본 적용 중 — 이 프로젝트에서는 실험 편의상 10% 기준으로 검증했으므로, 최종 임계값이 5%로 확정될 경우 위 §3 예측 오차 검증도 5% 기준으로 재확인 권장.

## 5. 첨부 파일

- `gas_node.ino` — 확정 캘리브레이션 반영된 최종 펌웨어
- `gas_node_log.csv` — 원본 로그 (817개 유효 포인트, 2026-08-18 16:51 ~ 2026-08-21 12:51)
- `gas_regression_chart.png` — 회귀검증 차트 (원시 데이터, 청정구간, 예측/실제 크로싱 포인트, 실측 대조점 포함)

---

*이 문서는 3일 캘리브레이션 테스트 종료 시점 기준 정리본입니다. 실제 CO2 용기 설치 후에는 §4의 절차(TARE/SET_INITIAL, 공병중량 실측)를 반드시 다시 수행해야 합니다.*
