Billiardchalktheif/2026ESWContest_free_bulchimbeon/data/광전식 엣지/스모킹(연초_전자담배) 클래스/스모킹_클래스_분석보고서.md

# 불침번 — 자탐2 스모킹(흡연) 클래스 데이터 분석

> 연초 10세션 + 전자담배 10세션(가까이 2 · 중간 4 · 멀리서 4), 총 20세션 통합 분석. 정상(normal) 클래스와 비교해 "왜 이런 값이 나오는지", "학습에 어떻게 쓸지" 정리한 문서입니다.

---

## 1. 왜 연초와 전자담배를 같은 클래스인데 따로 봐야 하는가

두 데이터는 **측정 환경 자체가 달라서** 절대값으로 비교하면 안 됩니다.

| | 연초 | 전자담배 |
|---|---|---|
| 측정 장소 | 야외(더운 습한 날씨) | 실내 |
| 시작 온도 | 27.8~29.1°C | 25.6~26.4°C |
| 시작 습도 | 66.4~70.6% | 56.5~58.7% |

전자담배는 실내에서 정상 클래스와 거의 같은 조건(온도 26°C대, 습도 57~59%대)에서 측정되어 절대값 비교가 가능하지만, 연초는 야외 환경 자체가 이미 정상 대비 온도 +2~3°C, 습도 +8~10%p 높은 상태에서 시작합니다. 그래서 **절대값이 아니라 "세션 시작 대비 상승률(%)"을 기준으로 통일**해서 분석했습니다. 이렇게 하면 그날 환경이 어쨌든 "흡연으로 인해 얼마나 튀었는가"만 비교할 수 있습니다.

---

## 2. 연초 (10세션, 야외)

| 지표 | 범위 | 평균 |
|---|---|---|
| MQ2 상승률 | 9.7~34.91% | 16.25% |
| 습도 상승률 | 5.05~9.3% | 6.78% |
| 세션 내 온도변화 | 0~0.4°C | 거의 없음 |

- 9회차(MQ2 +34.91%)가 다른 세션(9.7~17.75%)보다 뚜렷이 높은 이상치 — 담배 개수·거리·바람 조건 확인 필요, 원인 미확정 상태로 원본만 보존
- 온도는 세션 내에서 거의 안 움직임 → 연소 자체의 열이 감지기까지 전달되진 않고, 가스·수증기 성분만 감지되는 패턴

## 3. 전자담배 (10세션, 실내, 거리별)

가장 뚜렷한 특징은 **거리에 따른 선형적 용량-반응(dose-response)** 입니다.

| 거리 | 세션수 | MQ2 상승률(평균) | 습도 상승률(평균) |
|---|---|---|---|
| 가까이 | 2 | 51.36% | 40.00% |
| 중간 | 4 | 31.94% | 18.50% |
| 멀리서 | 4 | 11.42% | 9.50% |

거리가 멀어질수록 MQ2·습도 반응이 거의 비례해서 줄어드는, 물리적으로 아주 깔끔한 패턴입니다. 발표자료에서 "센서 반응이 실제 노출 강도에 비례한다"는 근거로 쓰기 좋습니다.

---

## 4. 연초 vs 전자담배 비교

| | 연초 | 전자담배(전체 평균) |
|---|---|---|
| MQ2 상승률 평균 | 16.25% | 27.62% |
| 습도 상승률 평균 | 6.78% | 19.20% |

전자담배가 연초보다 MQ2·습도 반응 모두 훨씬 큽니다. 이전에 짚었던 것처럼 PG/VG 기반 에어로졸이 수분 함량이 높고 MQ-2가 반응하는 휘발성 성분이 더 풍부하기 때문으로 보입니다. 다만 **전자담배 "멀리서" 조건(MQ2 +11.42%, 습도 +9.5%)은 연초(MQ2 +16.25%, 습도 +6.78%)와 수치가 겹치는 구간**이라, 이 둘을 하나의 "smoking" 클래스로 합쳐도 무방합니다 — 오히려 실제로도 "먼 거리 전자담배"와 "일반 흡연"은 감지기 입장에서 비슷한 자극일 가능성이 높습니다.

---

## 5. 정상 클래스와의 구분

| | 정상(예열 후 평탄구간) | 스모킹(전체 20세션) |
|---|---|---|
| MQ2 상승률 | 세션 시작~평탄까지 상승 있으나 이후 변화 없음(0%대) | 지속적 상승, 7.5~56.7% |
| 습도 상승률 | 세션 내 거의 변화 없음(0~1%대) | 지속적 상승, 5~42% |

정상 클래스는 예열 이후엔 평탄해지는 반면, 스모킹 클래스는 노출 기간 내내 MQ2·습도가 같이 계속 오르는 게 핵심 차이입니다. **"오르는 속도(rise rate)"와 "동시에 오르는가(MQ2·습도 동반 상승)"** 이 두 가지가 정상과 스모킹을 가르는 가장 확실한 특징으로 보입니다.

---

## 6. 학습 데이터로 쓸 때 제안

1. **스모킹 클래스는 20세션 모두 사용 가능** — 연초 9회차 이상치만 원인 파악 후 포함 여부 결정
2. **특징값은 절대값이 아니라 상승률(%) 기준으로 통일** — `mq2_rise_pct`, `humidity_rise_pct`를 주 특징으로, 절대값은 참고용
3. **전자담배는 거리 정보(가까이/중간/멀리서)를 별도 컬럼으로 유지** — 나중에 "얼마나 가까운 흡연까지 잡아낼지" 민감도 기준을 정할 때 필요
4. **연초-전자담배 경계(멀리서 vs 연초)가 겹치는 구간이 있다는 점을 AI 담당에게 공유** — 두 서브타입을 하나의 라벨로 합쳐도 되지만, 원한다면 subtype 컬럼은 남겨서 나중에 세분화 여지를 열어둠

---

## 7. 첨부 데이터

- `smoking_class_combined.csv` — 연초 10 + 전자담배 10, 총 20세션, 상승률(%) 기준 통합 대표값 (session_id, label=smoking, subtype, condition, mq2_rise_pct, humidity_rise_pct 등)
- `tobacco_raw_timeseries.csv` / `ecig_raw_timeseries.csv` — 각 원본 시계열 (참고·재처리용, 항상 보존)
