Billiardchalktheif/2026ESWContest_free_bulchimbeon/data/가스계 엣지/gas_regression_chart.png

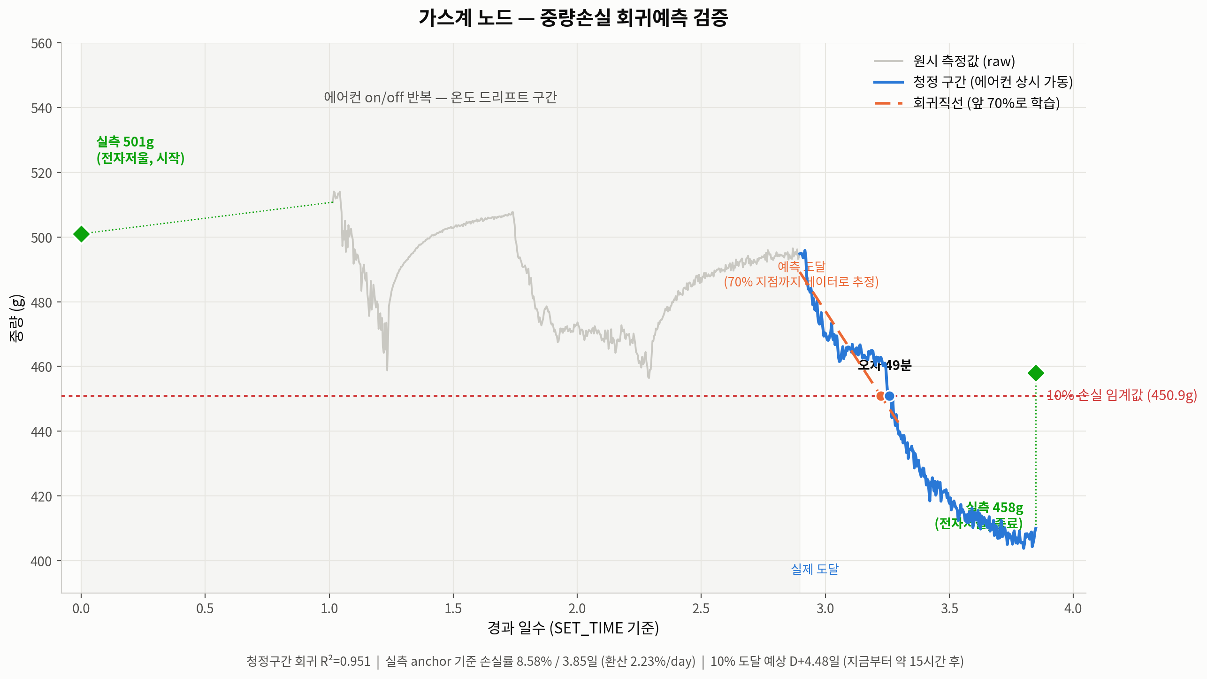
data/가스계 엣지/gas_regression_chart.png
