Billiardchalktheif/2026ESWContest_free_bulchimbeon/guides/수계_실험가이드.md

# 수계 실험 가이드 — 조립부터 실험까지

> 이 문서 하나만 보고 수계(성능시험 + AI 검증) 모듈을 처음부터 끝까지 완성할 수 있게 정리했습니다.

---

## 0. 목표 정리

**법정 기준**: 체절운전 시 정격토출압력의 140% 이하, 정격토출량 150% 운전 시 정격토출압력의 65% 이상 (성능시험배관 기준)

> ⚠️ 이 수치는 참고 기준이며, 우리 시스템이 이 기준으로 공식 법정 판정을 내리는 게 아닙니다. 유량 미측정·실물 규격 미확보 상태이므로 "적합/부적합 판정"이 아니라 "초기 설치값 대비 추세 비교"로 결과를 해석·서술해야 합니다.

**우리 시스템이 하는 일**:
1. **1차 확인(규칙기반)**: 니들밸브로 체절/부하 상태를 만들고, 압력센서로 그 순간의 압력값을 법정 기준·최초 설치값과 비교(참고용 추세 지표)
2. **2차 판정(AI, 상시)**: INA219로 잰 펌프 전류 파형을 보고 정상/과부하/공회전을 분류. 1차 판정이 도는 순간의 전류값에 정답 라벨을 자동으로 붙여 학습 데이터로 활용
3. **보조 지표**: 충압펌프 기동빈도(미세누수 감지)

---

## 1. 준비물

- ESP32 DevKitC × 1
- 미니 DC 워터펌프(12V) × 2 (충압용/주펌프용)
- INA219 DC 전류센서 모듈 × 2
- G1/4 압력센서(0~0.5MPa, 전압출력) × 1
- G1/4 T피팅 (BSP DN8) × 1
- 니들밸브(체절/부하 전환용) × 1
- 릴레이 모듈(2채널) × 1
- 12V 전원어댑터
- 실리콘 호스(내경 8mm), 미니 탱크
- 고정저항 2개 (압력센서 분압용)
- 테프론테이프, 케이블타이

---

## 2. 배관 조립

1. 미니 탱크에 물 채우기, 워터펌프 2개(충압용/주펌프용)를 탱크 안에 담금
2. 각 펌프 출수구에 실리콘 호스 연결
3. 한쪽 호스 라인 중간을 잘라서 **T피팅(G1/4)** 삽입 → 위쪽 암나사에 **G1/4 압력센서** 장착 (테프론테이프로 나사부 밀봉)
4. 같은 라인에 **니들밸브** 설치 (체절/부하 전환용) — 케이블타이로 호스와 피팅 고정
5. 조립 후 물 채워서 **누수 여부 먼저 확인** (전기 배선 전에 반드시 체크)

---

## 3. 전기 배선

| 부품 | 연결 |
|---|---|
| 릴레이 트리거핀 CH1/CH2 | ESP32 GPIO25 / GPIO26 |
| 릴레이 COM/NO (전력측) | 12V 어댑터(+) → COM, NO → INA219 Vin+ |
| **INA219 #1 (충압펌프, 주소 0x40)** | Vin- → 충압펌프(+), SDA→GPIO21, SCL→GPIO22, VCC→3.3V, GND→GND |
| **INA219 #2 (주펌프, 주소 0x41)** | Vin- → 주펌프(+), A0 패드를 VCC로 점퍼(주소를 0x41로 변경), SDA/SCL은 #1과 버스 공유 |
| 펌프(-) 2개 | 12V 어댑터(-)로 공통 연결 |
| 압력센서 (VCC/GND/Signal) | 빨강→5V, 검정→GND, 초록(Signal)→저항분압 후 GPIO32 |

**⚠️ 중요 — INA219는 CT클램프처럼 감싸기만 하면 안 됨.** 전선을 실제로 끊어서 Vin+/Vin- 사이에 직렬로 끼워 넣어야 합니다. CT클램프(비접촉)는 DC 전류를 측정할 수 없어 INA219로 교체된 것입니다.

**압력센서 분압 계산**: 센서 출력이 0.5~4.5V까지 나올 수 있어 ESP32 ADC 한계(3.3V)를 넘습니다. R1=R2(예: 10kΩ)로 정확히 절반 분압해서 최대 2.25V로 낮추고, 코드에서 읽은 값 × 2로 원래 전압을 역산하세요.

---

## 4. 동작 확인 (배선 직후, 실험 전)

1. 코드 업로드 후 시리얼 모니터로 INA219 #1, #2 값이 각각 정상 표시되는지 확인 (같은 주소 충돌 시 둘 다 같은 값이 찍히거나 통신 에러가 남 — 이 경우 A0 패드 점퍼 재확인)
2. 압력센서 값이 분압 계산 반영해서 정상 범위(0~50kPa대)로 나오는지 확인
3. 릴레이 CH1/CH2를 코드로 각각 on/off 해보며 실제로 펌프가 도는지 확인

---

## 5. 실험 프로토콜

### 5-1. ⚠️ 최우선 — 체절 vs 부하 전류 실측 (물리 가정 검증)

이 실험을 하기 전까지는 AI 라벨링 방향을 확정할 수 없습니다. **가장 먼저 진행하세요.**

1. 니들밸브 **완전히 잠금**(체절) → 릴레이로 펌프 켜기 → INA219 전류값과 압력값이 안정될 때까지(약 5~10초) 대기 → 기록
2. 니들밸브 **완전히 개방**(부하) → 펌프 계속 작동 중 → INA219 전류값과 압력값 기록
3. **어느 쪽이 더 높은 전류인지 확인** — 소형 DC 모터는 원심펌프와 반대로 체절(막힘) 상태에서 스톨에 가까워져 전류가 더 높게 나올 가능성이 있습니다. 실측으로 확정하세요.

**기록 양식**
```
[체절] 전류: ___ mA, 압력: ___ kPa
[부하] 전류: ___ mA, 압력: ___ kPa
결론: 체절이 (높음/낮음)
```

**결과 공유**: 팀 채팅방에 "체절이 [높다/낮다]로 나왔음" 한 줄 공유 — 이후 AI 라벨링 방향이 이걸로 결정됩니다.

### 5-2. 성능시험 반복 실행 (AI 학습 데이터 축적)

체절/부하 실험을 여러 번 반복하면서, 매번 압력센서가 확인한 상태(체절/부하)와 그 순간 INA219 전류값을 짝지어 기록합니다. 이게 AI 학습용 라벨 데이터가 됩니다.

- **체절, 부하 각각 최소 30~50회** 목표
- 한 사이클(잠금→측정→열기→측정)에 30초~1분
- **공회전 시나리오는 별도**: 탱크 물을 일부 비우거나 흡입측 호스를 살짝 들어서 펌프가 물 없이 도는 상황을 만들어 전류 패턴 기록 (밸브 조작이 아니라 급수 조건을 바꾸는 것)

### 5-3. 충압펌프 기동빈도 (보조 지표) 확인

니들밸브를 살짝만 열어 미세누수를 흉내내면서, 충압펌프가 얼마나 자주 켜지는지(INA219 전류가 0→값 있음으로 바뀌는 횟수)를 관찰합니다. 완전 밀폐 상태와 비교해 기동 빈도 차이가 나는지 확인하세요.

---

## 6. 오늘의 체크리스트

- [ ] 배관 조립, 누수 확인
- [ ] 릴레이·INA219·압력센서 배선
- [ ] 동작 확인 (INA219 2개 값 정상 구분, 압력값 정상 범위)
- [ ] **체절 vs 부하 전류 실측 (최우선)** — 결과 팀 공유
- [ ] 성능시험 반복 최소 5~10회 (본격 반복은 이후)
- [ ] 충압펌프 기동빈도 시나리오 1회 테스트

---

*본격적인 반복 실험(각 30~50회)은 오늘 다 안 해도 됩니다. 물리 가정 검증(5-1)만 오늘 확실히 끝내면, 나머지는 며칠에 걸쳐 채워도 됩니다.*
