Billiardchalktheif/2026ESWContest_free_bulchimbeon/guides/자탐_실험가이드.md

# 자탐 실험 가이드 — 도착 당일 완성판

> 이 문서 하나만 보고 자탐1(차동식)·자탐2(광전식) 두 구역을 처음부터 끝까지 완성할 수 있게 정리했습니다.

---

## 0. 목표 정리

**공통 원칙**: 감지기 모형(실물)은 회로적으로 아무것도 안 해요 — 그냥 "진짜 정품이 실제로 이 루프에 달려있다"는 걸 보여주는 전시용입니다. 진짜 측정은 별도로 붙인 우리 센서(NTC/TS0202, MQ-2, DHT22)가 담당합니다.

| 구역 | 실물 감지기 역할 | 진짜 데이터 담당 |
|---|---|---|
| 차동식 | 반도체식 감지기 — 전시용 모형 | TS0202 온도센서 (dT/dt 계산) |
| 광전식(연기) | 광전식 감지기 — 전시용 모형 | MQ-2(가스) + DHT22(습도) |

**공통 로직**: 두 구역 다 감지기 회로 루프의 전류/저항을 ADS1115로 상시 감시해서, 배선이 서서히 나빠지는지(부식·접촉불량) 추세를 봅니다.

---

## 1. 준비물

- 반도체식 차동식 감지기 (오늘 도착) × 2
- 광전식(연기) 감지기 × 2
- ESP32 DevKitC × 2
- ADS1115 × 2
- TS0202 온도센서 모듈 × 1 (차동식구역)
- MQ-2 가스센서 모듈 × 1 (광전식구역)
- DHT22 온습도센서 × 1 (광전식구역)
- 고정저항 세트 (루프 회로용)
- 열풍기 (차동식구역 열원)
- 가습기/전기포트 + 발연원(향) (광전식구역)
- 브레드보드 × 2, 챔버(또는 임시 상자) × 2

---

## 2. 감지기 모형 처리 — 전기적으로 손대지 않음

**기본 원칙(추천, 오늘 이걸로 진행)**: 감지기를 챔버 안에 **그냥 물리적으로 놓아두기만** 합니다. 전선 연결 없음. 정격전압 확인도 필요 없고, 회로 역설계도 안 합니다.

**여유 있으면 나중에 (선택, 오늘 필수 아님)**: 감지기를 루프에 매달아 실제 대기 저항으로 얹는 방법도 있습니다. 이 경우:
1. 멀티미터로 감지기 두 단자 사이 저항값을 측정 (대기 상태)
2. 그 값을 루프 베이스라인 계산에 고정 오프셋으로 반영

오늘은 기본 원칙(전시만)으로 진행하고, 이 선택 옵션은 시간 남으면 나중에 붙이세요.

---

## 3. 자탐1 — 차동식구역 조립

### 배선
| 부품 | 연결 |
|---|---|
| ADS1115 SDA | ESP32 GPIO21 |
| ADS1115 SCL | ESP32 GPIO22 |
| ADS1115 VCC/GND | ESP32 3.3V / GND |
| TS0202 VCC | ESP32 3.3V (또는 5V, 모듈이 겸용) |
| TS0202 GND | ESP32 GND |
| TS0202 AO | ADS1115 채널 A0 |
| 루프 회로(고정저항, 감지기 모형 물리적 배치만) | ADS1115 채널 A1 |

### 조립 순서
1. 브레드보드에 ESP32 + ADS1115 배선, I2C 연결 확인
2. 고정저항 2개로 분압 회로 구성 → TS0202 AO 신호를 A0에 연결
3. 별도 고정저항으로 루프 회로 하나 구성 → A1에 연결 (이게 "배선 건강 감시" 대상)
4. 챔버 안에 TS0202와 감지기 모형 2개를 같이 배치 (감지기는 전선 연결 없이 그냥 놓기)
5. 열풍기를 챔버 옆에 대기시켜 놓기 (아직 켜지 않음)

### 동작 확인
코드 업로드 후 시리얼 모니터로 A0(온도), A1(루프저항) 값이 정상 범위로 나오는지 확인.

---

## 4. 자탐2 — 광전식(연기)구역 조립

### 배선
| 부품 | 연결 |
|---|---|
| ADS1115 SDA/SCL | ESP32 GPIO21/22 (자탐1과 동일 패턴) |
| MQ-2 AO | ADS1115 채널 A0 |
| DHT22 신호선 | ESP32 GPIO4 (디지털 단일선) |
| 루프 회로(고정저항, 감지기 모형 물리적 배치만) | ADS1115 채널 A1 |

### 조립 순서
1. 브레드보드에 ESP32 + ADS1115 배선
2. MQ-2 AO → A0 연결
3. DHT22 → GPIO4 직결 (라이브러리 초기화 필요, 데이터시트 핀 배열 확인)
4. 루프 회로(고정저항) → A1
5. 별도 챔버에 MQ-2, DHT22, 감지기 모형 2개 배치
6. 가습기/전기포트, 발연원(향)을 챔버 근처에 대기 (아직 사용 안 함)

### 동작 확인
시리얼 모니터로 A0(가스농도), DHT22(습도), A1(루프저항) 값이 정상 범위로 나오는지 확인. MQ-2는 초기 예열시간(보통 몇 분)이 필요할 수 있으니 값이 안정화될 때까지 대기.

---

## 5. 실험 프로토콜

### 5-1. 차동식구역 — 열원 반응 테스트

1. 평상시(열풍기 끈 상태) 온도값을 1분 정도 기록해 베이스라인 확보
2. 열풍기를 챔버에 20cm 거리에서 조사, **10초간** 유지
3. 온도값이 얼마나 빠르게 오르는지(°C/초) 기록
4. 열풍기 끄고 챔버가 완전히 식을 때까지 대기 (다음 시행에 영향 안 주도록)
5. **최소 10회 반복**, 매번 조건(거리·시간) 동일하게 유지해서 재현성 확인

**기록 양식**
```
시행 번호: ___
시작 온도: ___ ℃
10초 후 온도: ___ ℃
상승률: ___ ℃/초
```

### 5-2. 광전식구역 — 화재/조리연기/평상시 구분 데이터 수집

**한 번에 한 상태만 재현.** 상태 섞이면 라벨이 애매해집니다.

| 상태 | 재현 방법 | 지속 시간 |
|---|---|---|
| `fire` (화재) | 열풍기 조사 + 발연원(향) 동시 투입 | 2~3분 |
| `cooking` (조리연기) | 가습기/전기포트로 수증기 발생 | 2~3분 |
| `normal` (평상시) | 아무 조작 없이 대기 | 2~3분 |

**각 상태당 최소 15~20회 세션** 목표. 시작/종료 시각을 정확히 기록해두면(아래 양식), 나중에 서버 DB에 시간대 기준으로 일괄 라벨을 적용할 수 있습니다.

**기록 양식**
```
실험 일시: 2026-08-XX
상태: fire / cooking / normal
시작 시각: __:__:__
종료 시각: __:__:__
비고: (열풍기 세기, 발연원 투입 타이밍 등)
```

**⚠️ 안전 주의사항**
- 열풍기·발연원 사용 시 환기 확보 — 실제 화재경보기 있는 공간이면 오작동 주의
- 발연원(향)은 불씨 관리 철저히, 다 쓰면 확실히 꺼졌는지 확인
- 가습기는 ESP32/ADS1115에 직접 물방울 튀지 않게 거리 유지 (챔버 안 배치 각도 신경 쓰기)

---

## 6. 오늘의 체크리스트

- [ ] 자탐1: ADS1115+TS0202 배선, 시리얼모니터 값 확인
- [ ] 자탐1: 루프 회로 구성, 감지기 모형 챔버 배치(전기연결 없이)
- [ ] 자탐1: 열원 반응 테스트 최소 3~5회 (시간 되는 만큼)
- [ ] 자탐2: ADS1115+MQ-2+DHT22 배선, 시리얼모니터 값 확인
- [ ] 자탐2: 루프 회로 구성, 감지기 모형 챔버 배치
- [ ] 자탐2: fire/cooking/normal 각 상태 최소 2~3회씩 시범 실행 (본격 반복은 이후 계속)
- [ ] 실험 기록 양식대로 시간 기록 남기기 — 나중에 라벨링 스크립트에 사용
- [ ] 결과 팀 채팅방에 공유

---

*본격적인 반복 실험(각 15~20회)은 오늘 하루에 다 안 해도 됩니다. 배선과 기본 동작 확인이 끝나면, 이후 며칠에 걸쳐 틈틈이 세션을 채워나가면 됩니다.*
