Billiardchalktheif/2026ESWContest_free_bulchimbeon/guides/유도등_실험가이드.md

# 유도등 실험 가이드 — 도착 당일 완성판

> 이 문서 하나만 보고 유도등 스코프를 처음부터 끝까지 완성할 수 있게 정리했습니다. 순서대로 진행하세요.

---

## 0. 목표 정리

**법정 기준**: 유도등 비상전원(배터리)은 정전 후 **20분 이상** 점등 유지해야 함
**우리 시스템이 하는 일**: 배터리 전압을 상시로 재서, 서서히 떨어지는 추세를 보고 "이 배터리가 곧 20분 기준을 못 채우겠다"를 미리 예측
**오늘 목표**: 실물 유도등 1대를 정상 점등시키고, ESP32로 전압을 읽을 수 있는 상태까지 완성

---

## 1. 준비물

- 유도등 본체 (COMENS 복도통로유도등, 현대방재산업)
- 가변 전원공급장치(파워서플라이) — 친구 집에서 가져올 것
- 멀티미터
- 브레드보드, 점퍼선
- ESP32 DevKitC
- 고정저항 2개 (저항분압용)
- CDS 조도센서 모듈 (SZH-SSBH-011)
- CD74HC4067 멀티플렉서 (여러 개 유도등 확장용, 오늘은 1대만이라 필수는 아님)
- 여분 Ni-Cd 배터리(3.6V, 산 것) — 오늘은 안 쓸 가능성 높음, 대기만

---

## 2. 1단계 — 적정 구동전압 찾기

**절대 원칙: 절대 220V 콘센트에 바로 꽂지 마세요.** 지금부터는 저전압 DC 경로로 접근합니다.

### 배선
- 3선(백/흑/적) 중 **백/흑 2개만** 사용 (2선식 결선도 기준)
- 적선은 이번 단계에서 아무 데도 연결하지 않고 그대로 둠 (테이프로 절연 마감)
- 백/흑을 브레드보드로 가져와서 파워서플라이 출력에 연결할 준비

### 전압 탐색 절차
1. 파워서플라이 **전류 제한을 0.1~0.2A로 낮게 설정** (과전류 보호)
2. 출력전압 **0.5V부터 시작**
3. 백(+)/흑(-)에 연결 후, 0.2~0.3V씩 천천히 올리면서 관찰
4. LED가 켜지는 지점을 발견하면 즉시 멈추고 그 전압 기록
5. 발열이나 이상한 냄새 나면 즉시 전원 차단

**예상 범위**: 대략 2~5V 사이일 가능성이 높습니다(일반 LED 순방향전압 감안). 박스에 적힌 "DC1.2V"는 내부 배터리 셀 1개 기준 표기라 그대로 넣는 값이 아닙니다 — 반드시 실측으로 찾으세요.

### 기록
```
정상 점등 확인 전압: _____ V
이때 전류: _____ A
```

---

## 3. 2단계 — 배터리 자동전환 검증 (중요, 분기점)

정상 점등 확인했으면, 바로 이어서 진행합니다.

### 테스트
1. LED가 켜진 상태에서, 파워서플라이 출력을 **갑자기 차단** (전원 끄기 또는 백선 뽑기)
2. LED가 **그대로 계속 켜져 있는지** 즉시 관찰

### 결과에 따라 분기

**✅ 계속 켜져 있으면 (배터리로 자동 전환 성공)**
→ 4단계로 바로 진행. 이 방식(저전압 DC 직결) 그대로 쓰면 됩니다.

**❌ 꺼지면 (자동 전환 안 됨)**
→ 이 보드는 진짜 AC220V를 감지해야 배터리 전환 회로가 작동하는 구조입니다. 아래 "3단계-B"로 진행하세요.

---

## 3단계-A — DC 저전압 방식 확정 (2단계에서 성공한 경우)

이대로 4단계(ESP32 연동)로 넘어가면 됩니다. 브레드보드 배선을 고정하고 라벨을 붙여두세요(나중에 재현 가능하도록).

---

## 3단계-B — AC220V 방식으로 전환 (2단계에서 실패한 경우)

**안전 수칙 (반드시 준수)**
- 배선 작업은 반드시 **플러그를 뽑은 상태**에서 진행
- 노출된 전선을 손으로 만지지 않기, 작업 후 절연테이프로 확실히 마감
- 처음 전원 넣을 때는 옆에 사람 있는 상태에서, 손 대지 말고 눈으로만 확인
- 익숙하지 않으면 교수님이나 전기 다뤄본 사람 동석 요청

**배선**
1. 유도등 원래 AC220V 입력선을 **스위치 달린 멀티탭**에 연결
2. 멀티탭 콘센트에 꽂아서 정상 충전/점등 확인
3. 멀티탭 스위치로 전원 차단 → 배터리 자동전환 재확인 (이번엔 될 것)

**ESP32 연동 시 주의**: AC220V 라인 근처에 저전압 ESP32 회로를 두지 마세요. 전압 tap은 반드시 **배터리 쪽(저전압 구간)**에서만 따야 합니다 — 이건 4단계에서 동일하게 적용됩니다.

---

## 4. ESP32 연동 — 전압 감지 + 점등 확인

어느 분기로 왔든, 여기서부터는 동일합니다. **배터리(빨간 내장 배터리) 커넥터 선(빨강/검정)에 병렬로 가지선을 따서** ESP32로 가져옵니다. 원래 회로는 끊지 않고 옆에서 전압만 엿보는 방식입니다.

### 배선 (단일 유도등 기준, 브레드보드)

| 부품 | 연결 |
|---|---|
| 저항분압 입력 | 배터리(+) 선에서 분기 |
| 저항분압 출력 | ESP32 GPIO34 (ADC1) — 유도등 1대만 할 경우 멀티플렉서 없이 직결 가능 |
| 저항분압 GND | 배터리(-) 선, ESP32 GND와 공통 |
| CDS 조도센서 VCC | ESP32 3.3V |
| CDS 조도센서 GND | ESP32 GND |
| CDS 조도센서 AO | ESP32 GPIO35 (ADC1) |

**저항값 계산**: 배터리 전압이 대략 3.6V 근처(완충 시 살짝 높을 수 있음, 4V대까지 감안)라, ESP32 ADC 한계(3.3V) 대비 여유가 크지 않습니다. **R1=R2=동일 저항값(예: 10kΩ)으로 정확히 절반 분압**해서 여유 있게 낮추는 걸 추천합니다. 코드에서 읽은 값 × 2로 원래 전압을 역산하세요.

### 나중에 4대로 확장할 때 (오늘 안 해도 됨)
- CD74HC4067 SIG→GPIO32, S0~S3→GPIO25,26,27,14
- 유도등 4대의 저항분압 출력 → 멀티플렉서 채널 C1,C3,C5,C7
- CDS 조도센서 4개 → 멀티플렉서 채널 C0,C2,C4,C6
- (단일 유도등용 직결 배선은 이 단계에서 멀티플렉서 채널로 옮기기만 하면 됨, 저항분압 회로 자체는 그대로 재사용)

### 확인
코드 업로드 후 시리얼 모니터로:
- 저항분압 → 배터리 전압값이 대략 3.x V대로 정상 표시되는지
- CDS → 유도등 켜짐/꺼짐에 따라 조도값이 확연히 달라지는지

---

## 5. 실험 프로토콜 — 오늘부터 시작할 수 있는 데이터 수집

이 부분은 회귀분석용 데이터를 쌓는 과정입니다. 자탐/수계처럼 복잡한 라벨링이 필요 없어서 오늘 바로 시작 가능합니다.

### 5-1. 방전시간 실측 (스펙 검증용)
1. 배터리 완충 상태 확인
2. 정상 전원 차단 (2단계와 동일한 방식)
3. **스톱워치로 LED가 실제로 꺼지는 순간까지 시간 측정**
4. 기록: `측정 방전시간: _____ 분` (박스 스펙 60분, 법정기준 20분과 비교)

### 5-2. 전압 추세 로깅 (예측 모델용 — 계속 반복)
완충 → 방전 사이클을 반복하면서 ESP32가 전압을 주기적으로(예: 10~30초마다) 기록하도록 둡니다. 이 데이터가 나중에 "전압이 서서히 떨어지는 추세 → 며칠 후 기준 미달 예상" 회귀분석의 재료가 됩니다.

**기록 양식** (다른 모듈과 통일):
```
실험 일시: 2026-08-XX
사이클: 1회차
완충 시작 전압: ___ V
방전 시작 시각: ___
방전 종료 시각(LED 꺼짐): ___
총 방전시간: ___ 분
비고:
```

### 5-3. 배터리 충전 방법
- 이 유도등 원래 회로(AC220V 또는 확정된 DC 경로)로 다시 충전
- 여분 노란 배터리는 규격 안 맞아 오늘은 보류 — 필요시 별도 Ni-Cd 충전기로 독립 충전해 예비용으로만 사용

---

## 6. 오늘의 체크리스트

- [ ] 1단계: 적정 구동전압 실측 완료
- [ ] 2단계: 배터리 자동전환 여부 확인 (성공/실패 기록)
- [ ] (실패시) 3단계-B: AC220V 안전 배선 전환
- [ ] 4단계: ESP32 저항분압 + CDS 연동, 시리얼모니터 값 확인
- [ ] 5-1: 방전시간 1회 실측
- [ ] 5-2: 전압 로깅 최소 1사이클 확보
- [ ] 결과 팀 채팅방에 공유 (특히 2단계 결과 — 다른 모듈 작업에도 참고될 수 있음)

---

*나머지 3대는 오늘 확정된 배선 그대로 반복 조립하면 됩니다. 확장(멀티플렉서) 작업은 4대가 다 개별 검증된 뒤에 진행하는 걸 추천합니다.*
