Billiardchalktheif/2026ESWContest_free_bulchimbeon/server/pump_node_INA219_v25.ino

/*
  불침번 — 수계 노드 (ESP32 DevKitC) — 충압펌프 + 주펌프 통합

  ⚠️⚠️ v7 정정 — 2가지 시나리오 명확화 (성능시험 vs 자동 충압제어):
    이 노드는 서로 독립적인 두 가지 동작을 수행한다.
    (A) 성능시험(수동 트리거, H-Q 곡선용): 발표자가 주펌프측 개폐밸브를 손으로
        잠근 뒤 시리얼 명령 "P"(또는 TEST_PERFORMANCE)를 입력하면 주펌프가 켜지고,
        압력센서①(성능시험배관, GPIO32) + 유량센서(GPIO27) 값을 매 주기 전송한다.
        H-Q 곡선 자체는 이 노드가 계산하지 않고 라즈베리파이가 압력/유량 값만
        받아서 연산한다.
    (B) 충압펌프 자동제어(상시 감시): 압력센서②(헤더, GPIO34)를 상시 폴링하다가
        히스테리시스 임계값(JOCKEY_HEADER_START/STOP_KPA) 이하로 떨어지면 이 노드가
        직접 릴레이(GPIO25)로 충압펌프를 켜고, INA219(0x40)로 그 순간의 전류파형
        (RMS/Peak/Duty)을 캡처해 라즈베리파이로 전송한다. 라즈베리파이는 이 파형으로
        정상/이상(기동실패 등)을 판정하고, cycle_interval_sec으로 작동빈도(누수 추세)를
        집계한다. (A)와 (B)는 서로 다른 압력센서/배관을 보며 완전히 독립적으로 동작.

  역할 (v7 기준 최종):
    1) 주펌프 INA219 전류값(시계열)을 읽어 feature(RMS/peak/duty cycle)를 현장에서
       계산해 전송 -> 서버가 RandomForest로 정상운전/체절운전/유량저하/공회전/기동실패
       분류 (유일한 AI 적용 지점 중 하나, 2차/상시 — 나머지 하나는 자탐2 비화재보 판별,
       server/nuisance_alarm_classifier.py)
    2) 충압펌프 — 헤더 압력 상시 감시 -> 히스테리시스 기준 자동 기동/정지(위 B) ->
       기동 시 INA219 전류파형을 라즈베리파이로 전송해 AI가 정상여부 판정 + 작동빈도 집계
    3) 성능시험(1차, 규칙기반, 위 A) — 압력값① + 유량값 + INA219 전류값을 항상 함께
       전송한다. 밸브가 **니들밸브/나비밸브(수동 조작)**이므로(v4 §5) 이 노드는
       체절/부하 상태를 직접 알지 못한다. valve_state를 이 노드가 붙이지 않고
       pressure_kpa/flow_lpm을 계속 흘려보내면, 서버가 값 패턴을 보고 체절/부하
       상태를 스스로 추정해서 label을 붙인다(server/pump_performance_test.py의
       determine_valve_state 참고).

  ⚠️ 성능시험(1차)과 AI(2차)의 관계 — 순차 대체가 아니다:
    주펌프 AI(파형분류)는 이 노드가 항상 상시로 돌린다(loop()의 MAIN_SEND_INTERVAL_MS
    주기). 충압펌프 자동제어(B)도 항상 상시로 돈다(HEADER_POLL_INTERVAL_MS 주기).
    성능시험(A)만 밸브를 인위적으로(사람이 손으로) 조작해야 해서 상시로 돌릴 수
    없고, PERF_TEST_AUTO_INTERVAL_MS 주기에만 짧게 펌프를 켜서 발표자가 밸브를
    만질 시간을 준다. 그 순간에만 같은 패킷들에 압력값이 서버의 체절/부하 판정에
    쓰일 뿐, "성능시험 실패시 AI로 넘어간다" 같은 구조가 아니다.

  ⚠️⚠️ v5 정정 — CT클램프 → INA219 교체 (가장 중요한 변경):
    기존 코드는 CT클램프(비접촉, analogRead + AC 커플링 바이어스 회로)를 전제로
    했으나, CT클램프는 전자기 유도 원리라 **직류(DC) 전류를 측정할 수 없다.**
    우리 워터펌프는 12V DC 구동이라 이 상태로는 전류값이 거의 0 또는 무의미한
    노이즈로 측정될 뻔한 근본적 설계 오류였다. INA219(I2C, 션트저항 기반)로
    전면 교체했다.
      - 배선 방식 자체가 바뀜: CT클램프(전선을 감싸기만 함, 비접촉) →
        INA219(전선을 절단해 전류 경로에 직렬로 삽입, High-side)
      - GPIO34/35 아날로그 읽기, ADC_MID_V 바이어스, 커플링 커패시터 관련 코드는
        전부 불필요해짐 (I2C는 그런 아날로그 보정이 필요 없음)
      - 대신 I2C 주소로 두 센서를 구분: 충압펌프=0x40(기본), 주펌프=0x41
        (INA219 보드의 A0 패드를 VCC로 점퍼해서 0x41로 변경)
      - feature_extraction(RMS/peak/duty_cycle) 로직 자체는 그대로 유지 —
        INA219로 읽은 전류값(mA) 시계열에 동일하게 적용

  확정 핀 배치(§3/§5, v5로 정정):
    - INA219(충압펌프, 주소 0x40): SDA -> GPIO21, SCL -> GPIO22 (I2C 공용 버스)
    - INA219(주펌프, 주소 0x41):   SDA -> GPIO21, SCL -> GPIO22 (동일 버스, 주소로 구분)
    - 릴레이 CH1(충압펌프 시험용): GPIO25 (디지털 출력)
    - 릴레이 CH2(주펌프 시험용):   GPIO26 (디지털 출력)
    - 압력센서(G1/4, 0.5~4.5V 출력, 1차 필수 — 성능시험의 핵심 계측 도구): GPIO32 (ADC1)
    - 유량센서(YF-S201, 홀센서 펄스, 1차 필수 — 성능시험배관에 직렬 삽입): GPIO27
    ⚠️ 릴레이는 2채널로 충분하다. **솔레노이드 밸브는 구매/배선하지 않는다.**
       기존 니들밸브/나비밸브를 그대로 재사용하고, 발표자가 시연 시 직접 손으로 잠그고 연다.

  배선 메모:
    - INA219는 전선을 실제로 끊어서 전류 경로에 직렬로 삽입해야 한다(High-side):
      릴레이 NO -> INA219 Vin+, INA219 Vin- -> 펌프(+), 펌프(-) -> 어댑터(-) 공통.
      CT클램프처럼 전선을 감싸기만 하면 안 된다.
    - INA219 두 모듈은 같은 I2C 버스(SDA/SCL)를 공유하되 주소만 다르게 설정한다.
      주소 충돌 시 둘 다 같은 값이 찍히거나 통신 에러가 나므로, 배선 직후 시리얼
      모니터로 두 센서가 독립적으로 읽히는지 반드시 확인할 것.
    - ⚠️ 압력센서(G1/4)는 0.5~4.5V를 출력한다 — ESP32 ADC 입력 한계(3.3V)를 넘는
      신호이므로, **반드시 저항분압을 거쳐서** GPIO32(ADC1)로 연결할 것. 분압 없이
      직결하면 ESP32가 손상될 수 있다. 분압비는 PRESSURE_V_MIN/MAX 상수가
      "분압 이후 ESP32가 실제로 보게 되는 전압 범위"를 가리키도록 실측 후 맞출 것.
    - 니들밸브/나비밸브는 배관에 이미 있던 것을 재사용한다 — ESP32/릴레이와 전혀
      연결되지 않는 완전 수동 부품이다. 자동화(솔레노이드)는 결선 단계 확장 계획으로만
      남겨두고 이번 판에서는 구현하지 않는다. 배관 말단의 나비밸브는 헤더(정상운전)
      경로 압력강하 시연용, 니들밸브는 주펌프 성능시험배관 개폐/유량조절용으로 역할이
      다르다는 점에 유의 — 둘 다 사람이 손으로 조작한다.
    - 유량센서(YF-S201)는 몸통에 흐름방향 화살표가 있다 — 역방향 장착 시 임펠러가
      안 돌아 값이 0으로만 찍히므로, 배관 조립 시 반드시 방향 확인할 것.
    - FLOW_K_FACTOR(7.5)는 데이터시트 참고값이다. 체적법(일정 시간 동안 받은 물의
      부피 실측)으로 캘리브레이션 후 반드시 재조정할 것 — 그전까지 flow_lpm 값은
      상대적 추세 파악용으로만 신뢰하고 절대값은 참고치로 취급.
    - 시리얼 명령: TEST_JOCKEY(충압펌프 릴레이 배선 점검), TEST_PERFORMANCE(성능시험
      수동 트리거 — 펌프를 잠깐 켜서 발표자가 밸브를 조작할 시간을 줌),
      TEST_DRYRUN(공회전 파형 수동 캡처 — 흡입측 차단/탱크 비움 상태에서 실행).

  라이브러리: Adafruit INA219 (아두이노 라이브러리 매니저에서 "Adafruit INA219" 검색)

  견고화 내역: millis() 논블로킹, WiFi 자동 재연결, ArduinoJson, boot_id, NTP epoch 동기화

  [v24 — 택트스위치 추가, 노트북/대시보드 없이 보조배터리 단독 시연 대응]
    - 성능시험(TEST_PERFORMANCE)만 시연 중 실시간으로 트리거해야 해서 GPIO33에
      택트스위치를 달고 loop() 폴링 + millis() 디바운스로 처리한다 (유도등/가스계
      노드와 동일 패턴 — attachInterrupt 대신 폴링을 쓰는 이유는 인터럽트 방식에서
      오인식 문제가 있었기 때문, 유도등 v3 참고).
      GPIO33 = TEST_PERFORMANCE(성능시험 시작) 대체 — 니들밸브 잠근 직후 누름.
      TEST_JOCKEY/TEST_DRYRUN은 배선점검·데이터수집용 1회성 디버그 명령이라
      데모 당일엔 불필요 판단, 버튼 대상에서 제외 — 시리얼로는 계속 사용 가능.
      시리얼 명령(TEST_PERFORMANCE/P)은 디버깅용으로 그대로 유지 — 버튼과 시리얼
      둘 다 같은 함수(startPerformanceTest)를 호출하므로 충돌 없음.
*/

#include <WiFi.h>
#include <WiFiUdp.h>
#include <ArduinoJson.h>
#include <Wire.h>
#include <Adafruit_INA219.h>
#include <time.h>
#include <string.h>
#include <math.h>
#include "esp_task_wdt.h"  // 워치독 타이머 — Fail-Soft(§3-1) 적용
// 아두이노 ESP32 코어 3.x(ESP-IDF 5 기반) 기준 — esp_task_wdt_init()이 구조체 인자를 받는다.
// 코어 3.x는 프레임워크가 이미 TWDT를 초기화해둔 상태일 수 있어(ESP_ERR_INVALID_STATE)
// setup()에서 재설정(reconfigure)으로 방어한다. 코어 2.x를 쓴다면 옛 시그니처
// esp_task_wdt_init(seconds, panic)로 되돌려야 함 — 사용 중인 코어 버전 확인.

// ---- 설정값 (실측 후 재조정) ----
const char* WIFI_SSID = "YOUR_SSID";
const char* WIFI_PASS = "YOUR_PASSWORD";
const char* SERVER_IP = "YOUR_SERVER_IP";   // 라즈베리파이 IP
const uint16_t SERVER_PORT = 9000;

// INA219 I2C 주소 — 보드의 A0 패드를 VCC로 점퍼하면 0x40 -> 0x41로 변경됨
const uint8_t JOCKEY_INA219_ADDR = 0x40;   // 충압펌프 (기본 주소, 점퍼 없음)
const uint8_t MAIN_INA219_ADDR   = 0x41;   // 주펌프 (A0 패드 -> VCC 점퍼)

const int PRESSURE_PIN = 32;         // ADC1 — 압력센서① 성능시험배관(주펌프 곁가지, H-Q 곡선용)
const int PRESSURE_HEADER_PIN = 34;  // ADC1 — 압력센서② 헤더(주+충압 합류 후, 자동제어 상시 감시용)
const int FLOW_SENSOR_PIN = 27;      // 유량센서(YF-S201, 홀센서 펄스) — 성능시험배관에 직렬 삽입
const int RELAY_JOCKEY_PIN = 25;
const int RELAY_MAIN_PIN = 26;

// ---- 성능시험 트리거 버튼 (v24 신규) ----
// 택트스위치(4핀, 대각선 페어): 다리 하나 -> GPIO, 대각선 반대 다리 -> GND.
// INPUT_PULLUP이므로 평소 HIGH, 누르면 LOW.
const int BUTTON_PERFORMANCE_PIN = 33;   // TEST_PERFORMANCE('P') 대체 — 니들밸브 잠근 직후 누름
const unsigned long BUTTON_DEBOUNCE_MS = 50;  // 이 시간 이상 안정적으로 유지돼야 진짜 입력으로 인정

// ---- 릴레이 트리거 극성 스위치 ----
// 보드가 "액티브로우"(LOW일 때 릴레이 ON)인 저가형 모듈이면 아래를 true로.
// 확인법: 둘 다 RELAY_OFF로 초기화한 상태에서 펌프가 꺼져 있는지 켜져 있는지 실측.
//   - 꺼져 있으면 지금 이 설정이 맞는 것
//   - 켜져 있으면 RELAY_ACTIVE_LOW를 반대로 바꿀 것
const bool RELAY_ACTIVE_LOW = true;   // ← 실측 후 확정된 값 (2채널 HAT 실측 기준 액티브로우)
const int RELAY_ON  = RELAY_ACTIVE_LOW ? LOW  : HIGH;
const int RELAY_OFF = RELAY_ACTIVE_LOW ? HIGH : LOW;
// v4: 솔레노이드 밸브 릴레이(CH3)는 제거됨 — 니들밸브 수동조작으로 정정

const int SAMPLE_COUNT = 100;       // 주펌프 전류 한 사이클당 샘플 수 (I2C 통신 속도 고려해 CT클램프 시절보다 축소)
const unsigned long SAMPLE_INTERVAL_US = 2000;  // 샘플 간격(us) — INA219 변환시간 고려해 실측 후 재조정

// 압력센서 "저항분압 이후" 전압 -> kPa 변환 (실측 후 정확한 값으로 교체).
const float PRESSURE_V_MIN = 0.26;   // 실측 캘리브레이션값 (정지상태 원래전압 실측 0.24~0.27V대
                                      // → 중간값으로 설정, 스펙값 0.5V는 이 개체 실제와 안 맞았음)
const float PRESSURE_V_MAX = 4.5;    // 센서 최대범위 전압 (센서 스펙, 분압 전 원래값 — 이전엔 3.0으로
                                      // 잘못 들어있었음, 그건 "분압 후 ESP32 안전범위"였지 센서 스펙이 아님)
// 센서 정격은 0~60MPa지만, 이 프로젝트 압력대(이론 체절압 약 30kPa, 소형 DC펌프
// 양정 3m 기준)에 비해 과분한 범위라 미세한 전압차가 kPa로 크게 뻥튀기됨.
// 아래 EMPIRICAL_SCALE로 나눠서 실측치가 이론치 근방으로 오도록 경험적 보정.
// ⚠️ 이건 정밀 캘리브레이션이 아니라 근사치 스케일링입니다 — 발표자료에는
// "경험적 보정을 거친 상대 추정치"로 명시할 것, 정밀 절대압으로 주장하지 말 것.
// 값을 더 키우면(나누는 수를 늘리면) 결과 kPa가 더 작아짐 — 실측 보고 자유롭게 조정 가능.
const float PRESSURE_EMPIRICAL_SCALE = 40.0;
const float PRESSURE_KPA_MAX = 60000.0 / PRESSURE_EMPIRICAL_SCALE;  // ≈ 1500
                                          // ⚠️ 이 센서는 고압(최대 600bar)까지 재는 범용 모델이라
                                          // 소형 DC펌프(추정 수십~수백kPa 대)에는 과분한 측정범위임.
                                          // ESP32 ADC 12bit(4096단계) 기준 1단계≈14.6kPa로, 펌프가
                                          // 내는 미세한 압력변화 분해능이 부족할 수 있음 — 실측 후
                                          // 데이터가 계단식으로 뚝뚝 끊겨 보이면 이 한계가 원인.
const float ADC_REF_V = 3.3;
const int ADC_MAX = 4095;           // 12bit

// 유량센서 — 펄스 카운트를 L/min으로 환산하는 계수. YF-S201 데이터시트 참고값(7.5)으로
// 시작하되, 체적법(비커+스톱워치) 실측 후 반드시 재조정할 것. 계산식: Hz = pulses/sec,
// flow(L/min) = Hz / K_FACTOR
const float FLOW_K_FACTOR = 7.5;

// ---- 충압펌프 자동제어(헤더 압력 기반, 히스테리시스) — 반드시 실측 후 재조정할 것 ----
// 압력이 START 미만으로 떨어지면 기동, STOP 이상으로 회복하면 정지. START<STOP로
// 폭을 둬서 노이즈로 인한 채터링(짧은 주기 반복 on/off)을 방지한다.
// ⚠️ v16 재조정: 예전 값(400/500)은 PRESSURE_KPA_MAX=60000 시절 placeholder였음.
// 지금 스케일(≈1500, 이론 체절압 30kPa대)에서는 400/500kPa에 절대 못 미쳐서 충압펌프가
// 영원히 자동기동 안 함. 주펌프 실측 범위(0~40kPa)를 참고해 우선 낮춰뒀고, 헤더센서
// 도착 후 [헤더] 디버그 로그 보면서 이 범위에서 실제 미세누설 시뮬레이션에 맞게 재조정할 것.
// ⚠️ v18 재조정: 실측 결과 START/STOP 폭(15~25, 10kPa)이 이 시스템 노이즈 대비 너무 좁아
// 채터링(1~1.5초 만에 반복 on/off) 발생 확인됨. 폭을 넓혀서 안정화.
const float JOCKEY_HEADER_START_KPA = 10.0;   // 실측 후 조정 — 이 압력 밑으로 떨어지면 충압펌프 기동
const float JOCKEY_HEADER_STOP_KPA  = 30.0;   // 실측 후 조정 — 이 압력 이상 회복하면 충압펌프 정지
const unsigned long HEADER_POLL_INTERVAL_MS = 300;  // 헤더 압력 상시 감시 폴링 주기

// ---- 주펌프 자동기동(2단계 — 충압펌프로도 못 따라갈 만큼 더 크게 떨어졌을 때) ----
// v20 신규: 성능시험 후 나비밸브①을 다시 열어두면, 주펌프측 배관이 항상 충수(가압수로
// 채워진) 상태를 유지하도록 헤더압력을 상시 감시해 필요시 자동기동한다.
// 임계값은 충압펌프보다 더 낮게 잡아 "충압펌프가 감당 못 할 때만" 개입하도록 함.
// ⚠️ 성능시험(PERF_RUNNING) 중에는 이 로직을 비활성화 — 그 시간 동안 릴레이 제어권은
// startPerformanceTest()/updatePerformanceTest()가 전담한다 (동시 제어 시 충돌 방지).
const float MAIN_HEADER_START_KPA = 3.0;    // 실측 후 조정 — 충압펌프보다 더 낮은 압력에서만 발동
const float MAIN_HEADER_STOP_KPA  = 30.0;   // 실측 후 조정
// v22: 순간값 하나만 보고 판단하면 두 가지 오작동이 생김을 실측으로 확인 —
//  (1) 완전개방(지속 대량누출)해도 충압펌프가 짧게짧게 밀어올려서 헤더압력이 3.0 위로
//      계속 붙잡히는 순간이 많아, 300ms 폴링이 하필 그 순간을 잡으면 주펌프가 안 켜짐
//  (2) 밸브를 확 잠그는 순간의 수격현상/센서노이즈로 순간적으로 크게(-8kPa 등) 떨어지면
//      실제 누출이 아닌데도 주펌프가 오발동, 곧바로 회복되며 1초 만에 다시 꺼짐(오탐)
// → "몇 초간 지속적으로 낮게 유지"되는지를 봐서 판단하도록 지속시간 조건 추가.
const unsigned long MAIN_TRIGGER_PERSISTENCE_MS = 2000;  // 이 시간 이상 계속 낮아야 진짜 대량누출로 판단

// v23: 실측 결과 (3) 밸브 완전개방 상태를 계속 유지해도, 충압펌프가 매번 30~50kPa까지 강하게
// 밀어올렸다가 7~13kPa 선에서 다시 떨어지는 "빠른 반복 기동"만 계속되고, 3.0kPa 밑으로는
// 거의 안 내려가는 경우가 확인됨. 순간압력 임계값만으로는 이 상황을 "심각한 누출"로 못 잡음.
// → 충압펌프가 짧은 시간 안에 비정상적으로 여러 번 반복 기동하는 것 자체를 "충압펌프로 감당
// 안 되는 상황"의 추가 판단기준으로 사용 (실제 소방설비에서도 충압펌프 과다기동은 경보/주펌프
// 개입 대상). 두 조건(지속적 저압 OR 과다 반복기동) 중 하나만 만족해도 주펌프 기동.
const int JOCKEY_EXCESSIVE_CYCLE_COUNT = 3;         // 이 횟수 이상 반복 기동하면 과다로 판단
const unsigned long JOCKEY_CYCLE_WINDOW_MS = 10000; // 이 시간(10초) 안에 누적된 기동 횟수를 봄
unsigned long jockeyCycleWindowStartMs = 0;
int jockeyCycleCountInWindow = 0;
unsigned long mainLowPressureSinceMs = 0;  // 0이면 "지금 낮은 상태가 아님"
bool mainAutoRunning = false;

// ---- 성능시험(1차) 관련 상수 ----
#define PUMP_TEST_ENVIRONMENT_TESTBED
#ifdef PUMP_TEST_ENVIRONMENT_TESTBED
const unsigned long PERF_TEST_AUTO_INTERVAL_MS = 6UL * 3600UL * 1000UL;    // 테스트베드: 6시간
#else
const unsigned long PERF_TEST_AUTO_INTERVAL_MS = 180UL * 86400UL * 1000UL; // 배포: 180일(법정 점검주기 근접)
#endif
const unsigned long PERF_TEST_DURATION_MS = 120000;   // 발표자가 밸브를 조작할 시간을 충분히 줌(2)

// 충압펌프 기동 감지 — 전류가 이 임계값(mA)을 상승 통과하면 "기동 시작"으로 판단(실측 후 튜닝)
const float JOCKEY_START_THRESHOLD_MA = 30.0;   // v18 재조정: 실측 정상기동 RMS가 41~89mA대라
                                                 // 기존 50.0은 절반 가까이를 오판정(기동실패로 잘못 판정)했음
const unsigned long JOCKEY_POLL_INTERVAL_MS = 500;   // 기동 감지 폴링 주기(파형 아니므로 느려도 됨)

const unsigned long MAIN_SEND_INTERVAL_MS = 3000;      // 주펌프 전류 사이클 간격(평상시/성능시험 공용)
const unsigned long WIFI_CHECK_INTERVAL_MS = 5000;
const long NTP_GMT_OFFSET_SEC = 9 * 3600;
const time_t NTP_SYNCED_THRESHOLD = 1700000000;

WiFiUDP udp;
Adafruit_INA219 inaJockey(JOCKEY_INA219_ADDR);
// v13: 주펌프 INA219 제거 — 보드의 A0/A1 패드가 납으로 이미 막혀있어 주소를 바꿀 수
// 없어서(0x40 고정), 같은 버스에 0x41로 공존시킬 방법이 없었음. 핵심 두 시나리오
// (A: 압력+유량으로 H-Q곡선, B: 충압펌프 INA219로 자동기동 파형분석)엔 원래 불필요한
// 부가기능(주펌프 자체 전류파형 분류)이었어서 제거. 필요해지면 별도 I2C 버스
// (TwoWire 두번째 인스턴스, 다른 SDA/SCL 핀)로 부활 가능.
// Adafruit_INA219 inaMain(MAIN_INA219_ADDR);

uint32_t seqNum = 0;      // 주펌프/충압펌프 패킷 공용 시퀀스 (device_type+pump_type로 서버가 구분)
uint32_t bootId;

unsigned long lastMainSendMs = 0;
unsigned long lastWifiCheckMs = 0;
double jockeyLastStartEpoch = -1;   // 직전 기동 시각(작동빈도/간격 계산용)

float samples[SAMPLE_COUNT];   // 전류값(mA) 시계열 버퍼

// 유량센서 — 인터럽트에서 카운트만 하고, 무거운 연산(JSON 직렬화 등)은 절대 넣지 않는다.
volatile unsigned long flowPulseCount = 0;
unsigned long lastFlowCalcMs = 0;
float lastFlowRateLpm = 0.0;

void IRAM_ATTR onFlowPulse() {
  flowPulseCount++;
}

// ---- 성능시험(1차) 상태 ----
enum PerfTestState { PERF_IDLE, PERF_RUNNING };
PerfTestState perfState = PERF_IDLE;
unsigned long perfStateStartMs = 0;
unsigned long perfLastAutoRunMs = 0;

// 버튼 디바운스 상태 (인터럽트 대신 폴링 — 유도등/가스계 노드와 동일 패턴)
bool buttonPerfLastReading = HIGH;
bool buttonPerfStableState = HIGH;
unsigned long buttonPerfLastChangeMs = 0;

// ---------------------------------------------------------------------------
// WiFi / 시각 동기화 — 다른 노드와 동일 패턴
// ---------------------------------------------------------------------------
void connectWiFi() {
  WiFi.mode(WIFI_STA);
  WiFi.begin(WIFI_SSID, WIFI_PASS);
  Serial.print("WiFi 연결 중");
  unsigned long start = millis();
  while (WiFi.status() != WL_CONNECTED && millis() - start < 15000) {
    delay(300);
    Serial.print(".");
  }
  if (WiFi.status() == WL_CONNECTED) {
    Serial.println(" 연결됨: " + WiFi.localIP().toString());
    configTime(NTP_GMT_OFFSET_SEC, 0, "pool.ntp.org", "time.google.com");
  } else {
    Serial.println(" 연결 실패 - loop()에서 계속 재시도함");
  }
}

void ensureWiFiConnected() {
  if (millis() - lastWifiCheckMs < WIFI_CHECK_INTERVAL_MS) return;
  lastWifiCheckMs = millis();
  if (WiFi.status() != WL_CONNECTED) {
    Serial.println("WiFi 끊김 감지 -> 재연결 시도");
    WiFi.disconnect();
    WiFi.begin(WIFI_SSID, WIFI_PASS);
  }
}

double getEpochSeconds() {
  time_t now;
  time(&now);
  if (now < NTP_SYNCED_THRESHOLD) {
    return millis() / 1000.0;
  }
  return (double)now;
}

// ---------------------------------------------------------------------------
// 공용 — INA219 전류(mA) 시계열 샘플링 (주펌프/충압펌프 둘 다 이 함수를 재사용)
// (CT클램프 시절의 sampleMainPumpWaveform()을 대체. computeRMS/Peak/DutyCycle은
//  server/feature_extraction.py와 동일 로직을 유지하되, 입력이 "AC 파형 진폭"에서
//  "DC 전류값(mA)의 시간에 따른 변화"로 바뀌었다는 점에 유의할 것)
// ---------------------------------------------------------------------------
void sampleCurrentWaveform(Adafruit_INA219 &sensor) {
  for (int i = 0; i < SAMPLE_COUNT; i++) {
    samples[i] = sensor.getCurrent_mA();
    delayMicroseconds(SAMPLE_INTERVAL_US);
  }
}

// v13: 주펌프용 샘플링 함수 비활성화 (inaMain 제거에 따라). sampleCurrentWaveform()
// 자체는 충압펌프(inaJockey)가 계속 쓰므로 그대로 둔다.
// void sampleMainPumpCurrent() {
//   sampleCurrentWaveform(inaMain);
// }

float computeRMS() {
  float sumSq = 0;
  for (int i = 0; i < SAMPLE_COUNT; i++) sumSq += samples[i] * samples[i];
  return sqrt(sumSq / SAMPLE_COUNT);
}

float computePeak() {
  float peak = 0;
  for (int i = 0; i < SAMPLE_COUNT; i++) {
    float a = abs(samples[i]);
    if (a > peak) peak = a;
  }
  return peak;
}

float computeMean() {
  float sum = 0;
  for (int i = 0; i < SAMPLE_COUNT; i++) sum += samples[i];
  return sum / SAMPLE_COUNT;
}

// duty_cycle의 의미가 CT클램프(AC 파형이 임계치를 넘는 비율)와 살짝 달라짐 —
// 여기서는 "평균 대비 변동폭이 threshold를 넘는 샘플의 비율"로 재정의해 리플/맥동을 봄
float computeDutyCycle(float threshold) {
  float mean = computeMean();
  int active = 0;
  for (int i = 0; i < SAMPLE_COUNT; i++) {
    if (abs(samples[i] - mean) > threshold) active++;
  }
  return (float)active / SAMPLE_COUNT;
}

// v4: valve_state는 이 노드가 더 이상 판단하지 않는다(니들밸브가 수동이라 알 방법이
// 없음) — 그래서 이 함수는 항상 pressure_kpa만 함께 실어 보내고, "지금이 체절인지
// 부하인지"는 서버가 압력값 추세를 보고 알아낸다(server/pump_performance_test.py).
// v6: 유량(flowLpm)도 압력과 동일하게 항상 함께 실어 보낸다 — H-Q 곡선(성능시험)과
// 정상운전 중 상대적 유량 추세 파악에 둘 다 필요한 1차 필수 계측값이기 때문.
void sendMainPumpPacket(float rms, float peak, float duty, float pressureKpa,
                        float flowLpm, const char* valveState = nullptr) {
  StaticJsonDocument<256> doc;
  doc["node_id"] = "pump_main_01";
  doc["device_type"] = "water_pump";
  doc["pump_type"] = "main";
  doc["seq"] = seqNum++;
  doc["ts"] = getEpochSeconds();
  doc["boot_id"] = bootId;
  if (!isnan(rms)) doc["rms"] = rms;      // v13: 주펌프 INA219 제거 시 NAN으로 넘어와 필드 생략됨
  if (!isnan(peak)) doc["peak"] = peak;
  if (!isnan(duty)) doc["duty_cycle"] = duty;
  if (!isnan(pressureKpa)) doc["pressure_kpa"] = pressureKpa;
  if (!isnan(flowLpm)) doc["flow_lpm"] = flowLpm;
  if (valveState != nullptr) doc["valve_state"] = valveState;
  // label 필드는 이 노드에서 보내지 않는다 — 성능시험 정답 라벨은 서버가
  // 압력값으로 추정한 valve_state를 보고 직접 채운다(§5 결합안 핵심).

  if (doc.overflowed()) {
    Serial.println("⚠️ JSON 버퍼 부족(main)! StaticJsonDocument/buf 크기를 늘려야 함");
  }

  char buf[256];
  size_t len = serializeJson(doc, buf, sizeof(buf));
  udp.beginPacket(SERVER_IP, SERVER_PORT);
  udp.write((const uint8_t*)buf, len);
  udp.endPacket();
}

// ---------------------------------------------------------------------------
// 압력센서① — 성능시험배관(주펌프 곁가지, H-Q 곡선용, 1차 필수)
// 압력센서② — 헤더(주+충압 합류 후, 충압펌프 자동제어 상시 감시용)
// 둘 다 0.5~4.5V 출력 센서라 저항분압(R1=10kΩ, R2=20kΩ) 후 입력한다.
// ⚠️ 버그 수정: 이전 버전은 "분압 후 ESP32가 읽은 전압"을 "분압 전 센서 스펙(0.5~4.5V)"과
// 바로 비교해서 계산이 어긋나 있었다(실측 시 압력이 항상 -100kPa대로 나오는 원인이었음).
// 반드시 DIVIDER_RATIO로 먼저 "분압 전 원래 센서 전압"으로 되돌린 다음 kPa로 환산할 것.
// ---------------------------------------------------------------------------
const float DIVIDER_R1 = 10000.0;  // 옴, 실측 저항값으로 교체 권장(정확한 5%/1% 오차 있을 수 있음)
const float DIVIDER_R2 = 20000.0;
const float DIVIDER_RATIO = DIVIDER_R2 / (DIVIDER_R1 + DIVIDER_R2);  // Vout/Vin = R2/(R1+R2)

// 캘리브레이션 디버그용 — 성능시험배관 압력센서(PRESSURE_PIN)의 "분압 전 원래 전압"을
// 매 측정마다 여기 저장한다. 물이 안 흐르는 대기압 상태(펌프 OFF, 밸브 잠금 전)에서
// 이 값을 시리얼로 확인해서, 그 실측값을 PRESSURE_V_MIN에 그대로 넣으면 0kPa 기준이 맞춰진다.
// (저항 오차·VCC 오차·센서 개체차가 섞여 있어 스펙값 0.5V가 실제와 안 맞을 수 있음)
float lastMainVOriginal = NAN;

// 60MPa 초광범위 센서라 전압 1mV 흔들림이 kPa로는 ~15kPa씩 뻥튀기됨(ADC 노이즈에 취약).
// 여러 번 재서 평균 내는 오버샘플링으로 흔들림을 줄인다 — 절대 노이즈를 없애진 못하지만
// 표준오차가 1/sqrt(N)로 줄어듦(16번 평균이면 노이즈 진폭이 약 1/4로 감소).
const int ADC_OVERSAMPLE = 32;

int analogReadAveraged(int pin) {
  long sum = 0;
  for (int i = 0; i < ADC_OVERSAMPLE; i++) {
    sum += analogRead(pin);
    delayMicroseconds(200);
  }
  return sum / ADC_OVERSAMPLE;
}

// 헤더 압력센서(내일 도착 예정)는 주펌프 센서와 다른 개체라 0점 전압이 다를 수 있다.
// 도착 후 정지상태(펌프 OFF, 배관 대기압)에서 lastHeaderVOriginal 값을 시리얼로 확인해
// 이 상수에 그대로 넣을 것 (주펌프 캘리브레이션 때와 동일한 절차).
const float PRESSURE_HEADER_V_MIN = 0.255;   // v18 재조정: 정지상태 실측 0.25~0.26V대 오가는 것의
                                              // 중간값으로 조정 (완전히 0kPa로 고정은 어려움 — ADC
                                              // 노이즈가 큰 스케일에서 증폭되는 근본 한계, 잔여 노이즈는 감수)
float lastHeaderVOriginal = NAN;

float readPressureKpa(int pin, float vMin) {
  int raw = analogReadAveraged(pin);
  float vMeasured = (raw / (float)ADC_MAX) * ADC_REF_V;   // ESP32가 실제로 읽은(분압된) 전압
  float vOriginal = vMeasured / DIVIDER_RATIO;             // 분압 전 원래 센서 전압으로 역산
  if (pin == PRESSURE_PIN) lastMainVOriginal = vOriginal;
  if (pin == PRESSURE_HEADER_PIN) lastHeaderVOriginal = vOriginal;
  float ratio = (vOriginal - vMin) / (PRESSURE_V_MAX - vMin);
  return ratio * PRESSURE_KPA_MAX;
}

float measurePressureKpa() {          // 성능시험배관용 (기존 함수명 유지, 하위 호환)
  return readPressureKpa(PRESSURE_PIN, PRESSURE_V_MIN);
}

float measureHeaderPressureKpa() {    // 헤더용 — 별도 V_MIN 캘리브레이션 사용
  return readPressureKpa(PRESSURE_HEADER_PIN, PRESSURE_HEADER_V_MIN);
}

// ---------------------------------------------------------------------------
// 유량센서 (1차 필수 — 주펌프 성능시험배관에 직렬 삽입, YF-S201 홀센서 펄스)
// 인터럽트는 카운트만 하고, 이 함수가 호출될 때(=주펌프 패킷 전송 주기와 동일)
// 그동안 쌓인 펄스 수를 실제 경과시간으로 나눠 L/min으로 환산한다.
// ---------------------------------------------------------------------------
float measureFlowLpm() {
  noInterrupts();
  unsigned long pulses = flowPulseCount;
  flowPulseCount = 0;
  interrupts();

  unsigned long nowMs = millis();
  unsigned long elapsedMs = nowMs - lastFlowCalcMs;
  lastFlowCalcMs = nowMs;
  if (elapsedMs == 0) return lastFlowRateLpm;  // 0 나누기 방지

  float hz = pulses / (elapsedMs / 1000.0);
  lastFlowRateLpm = hz / FLOW_K_FACTOR;
  return lastFlowRateLpm;
}

// ---------------------------------------------------------------------------
// 충압펌프 자동제어 (v7 신규) — 헤더 압력을 상시 감시하다가 히스테리시스
// 임계값(JOCKEY_HEADER_START/STOP_KPA)에 따라 릴레이를 직접 켜고 끈다.
// 기존(v5)의 "전류 임계값으로 기동 여부를 추정"하던 방식은 이제 불필요해졌다
// (우리가 직접 릴레이를 제어하므로 언제 켰는지 정확히 알고 있음). 대신 INA219는
// "명령대로 실제 전류가 흐르는지" 검증 + 파형 feature를 라즈베리파이로 보내
// AI가 정상/이상(기동실패, 공회전 등)을 판정하고 작동빈도를 집계하는 데 쓴다.
// ---------------------------------------------------------------------------
bool jockeyRunning = false;
unsigned long lastHeaderPollMs = 0;

void sendJockeyEventPacket(double intervalSec, float rms, float peak, float duty,
                            bool actualRunning, float headerPressureKpa) {
  StaticJsonDocument<256> doc;
  doc["node_id"] = "pump_jockey_01";
  doc["device_type"] = "water_pump";
  doc["pump_type"] = "jockey";
  doc["seq"] = seqNum++;
  doc["ts"] = getEpochSeconds();
  doc["boot_id"] = bootId;
  if (intervalSec >= 0) doc["cycle_interval_sec"] = intervalSec;  // 직전 기동 이후 경과시간(작동빈도 집계용)
  doc["rms"] = rms;
  doc["peak"] = peak;
  doc["duty_cycle"] = duty;
  doc["actual_running"] = actualRunning;  // false면 "명령은 줬는데 전류가 안 흐름" = 기동실패 의심
  doc["header_pressure_kpa"] = headerPressureKpa;

  // ArduinoJson v6는 용량이 부족해도 에러 없이 필드를 조용히 자르거나 누락시킨다 —
  // 방금 발견한 NTP 타이밍 버그처럼 필드값이 예상보다 훨씬 커지는 경우를 조기에
  // 잡기 위한 안전장치(2026-08-23 추가).
  if (doc.overflowed()) {
    Serial.println("⚠️ JSON 버퍼 부족(jockey)! StaticJsonDocument/buf 크기를 늘려야 함");
  }

  char buf[256];
  size_t len = serializeJson(doc, buf, sizeof(buf));
  udp.beginPacket(SERVER_IP, SERVER_PORT);
  udp.write((const uint8_t*)buf, len);
  udp.endPacket();
}

void controlAutoPumps() {
  if (millis() - lastHeaderPollMs < HEADER_POLL_INTERVAL_MS) return;
  lastHeaderPollMs = millis();

  float headerPressure = measureHeaderPressureKpa();

  // 헤더센서 캘리브레이션용 디버그 출력 — 도착 직후 이 값 보고 PRESSURE_HEADER_V_MIN,
  // JOCKEY_HEADER_START/STOP_KPA를 실측 기준으로 재조정할 것 (지금 값은 placeholder).
  static unsigned long lastDebugPrintMs = 0;
  if (millis() - lastDebugPrintMs > 3000) {
    lastDebugPrintMs = millis();
    Serial.print("[헤더] 압력:"); Serial.print(headerPressure);
    Serial.print("kPa(원래전압:"); Serial.print(lastHeaderVOriginal);
    Serial.println("V)");
  }

  // ---- 1단계: 충압펌프 ----
  static unsigned long jockeyRetryCooldownUntilMs = 0;
  if (!jockeyRunning && headerPressure < JOCKEY_HEADER_START_KPA && millis() >= jockeyRetryCooldownUntilMs) {
    // 기동: 릴레이 ON -> 잠깐 대기 후 INA219로 실제 전류파형 캡처(명령 검증 겸 AI 입력)
    digitalWrite(RELAY_JOCKEY_PIN, RELAY_ON);
    jockeyRunning = true;

    double nowEpoch = getEpochSeconds();
    // NTP 미동기화 시각(millis() 기반, NTP_SYNCED_THRESHOLD 미만)이 jockeyLastStartEpoch에
    // 한 번이라도 저장되면, 나중에 NTP 동기화된 진짜 에폭값과 빼는 순간 결과가 거의
    // 에폭타임스탬프 규모(17억대)로 폭주해서 JSON이 256바이트 버퍼를 넘겨버린다 —
    // 실측 로그로 확인된 버그(2026-08-23). NTP 동기화된 값끼리만 비교하도록 가드.
    double intervalSec = (jockeyLastStartEpoch >= NTP_SYNCED_THRESHOLD)
        ? (nowEpoch - jockeyLastStartEpoch) : -1;
    if (nowEpoch >= NTP_SYNCED_THRESHOLD) {
      jockeyLastStartEpoch = nowEpoch;  // NTP 동기화된 값만 다음 간격계산의 기준으로 채택
    }

    sampleCurrentWaveform(inaJockey);
    float rms = computeRMS();
    float peak = computePeak();
    float duty = computeDutyCycle(0.3 * peak);
    bool actuallyRunning = rms > JOCKEY_START_THRESHOLD_MA;  // 명령 줬는데 전류가 안 흐르면 기동실패 의심

    Serial.print("[충압펌프 기동] RMS:"); Serial.print(rms);
    Serial.print("mA  실제작동:"); Serial.print(actuallyRunning ? "예" : "아니오(기동실패 의심)");
    Serial.print("  헤더압력:"); Serial.print(headerPressure);
    Serial.println("kPa");

    sendJockeyEventPacket(intervalSec, rms, peak, duty, actuallyRunning, headerPressure);

    // v23: 성공적으로 기동했을 때만 "과다 반복기동" 카운터에 반영 (10초 슬라이딩 윈도우)
    if (actuallyRunning) {
      unsigned long nowMs = millis();
      if (jockeyCycleWindowStartMs == 0 || nowMs - jockeyCycleWindowStartMs > JOCKEY_CYCLE_WINDOW_MS) {
        jockeyCycleWindowStartMs = nowMs;  // 윈도우 새로 시작
        jockeyCycleCountInWindow = 1;
      } else {
        jockeyCycleCountInWindow++;
      }
    }

    // v21 버그수정: 실제 전류가 안 흐르면(기동실패) jockeyRunning을 true로 남겨두면
    // 이후 !jockeyRunning 조건이 계속 거짓이 되어 재시도 자체를 영원히 안 하게 됨
    // (실측 로그에서 확인된 문제 — 최초 1회만 시도하고 이후 몇 분간 방치됨).
    // 실패 시 상태를 되돌려 다음 폴링 주기(300ms 후)에 다시 시도하도록 함.
    if (!actuallyRunning) {
      digitalWrite(RELAY_JOCKEY_PIN, RELAY_OFF);
      jockeyRunning = false;
      jockeyRetryCooldownUntilMs = millis() + 3000;  // 계속 실패 시 300ms마다 재시도/로그 도배 방지
    }

  } else if (jockeyRunning && headerPressure >= JOCKEY_HEADER_STOP_KPA) {
    // 정지: 압력 회복 완료
    digitalWrite(RELAY_JOCKEY_PIN, RELAY_OFF);
    jockeyRunning = false;

    double runDurationSec = (jockeyLastStartEpoch >= NTP_SYNCED_THRESHOLD)
        ? (getEpochSeconds() - jockeyLastStartEpoch) : -1;
    Serial.print("[충압펌프 정지] 헤더압력:"); Serial.print(headerPressure);
    Serial.print("kPa (회복완료, 이번 가동시간 약 "); Serial.print(runDurationSec);
    Serial.println("초)");
  }

  // ---- 2단계: 주펌프 (성능시험 중엔 릴레이 제어권 충돌 방지를 위해 완전히 건너뜀) ----
  if (perfState == PERF_RUNNING) return;

  if (headerPressure < MAIN_HEADER_START_KPA) {
    if (mainLowPressureSinceMs == 0) {
      mainLowPressureSinceMs = millis();  // 낮아지기 시작한 시점 기록
    }
    if (!mainAutoRunning && (millis() - mainLowPressureSinceMs >= MAIN_TRIGGER_PERSISTENCE_MS)) {
      // MAIN_TRIGGER_PERSISTENCE_MS 이상 계속 낮게 유지됨 -> 진짜 대량누출로 판단
      digitalWrite(RELAY_MAIN_PIN, RELAY_ON);
      mainAutoRunning = true;
      Serial.print("[주펌프 자동기동] 충압펌프로 부족(지속 확인됨) — 헤더압력:"); Serial.print(headerPressure);
      Serial.println("kPa (충수 유지/누수과다 의심)");
    }
  } else {
    mainLowPressureSinceMs = 0;  // 압력이 회복되면 지속시간 카운트 리셋 (순간 노이즈였다는 뜻)

    if (mainAutoRunning && headerPressure >= MAIN_HEADER_STOP_KPA) {
      digitalWrite(RELAY_MAIN_PIN, RELAY_OFF);
      mainAutoRunning = false;
      jockeyCycleCountInWindow = 0;  // 주펌프가 개입해서 해결됐으니 카운터 리셋
      jockeyCycleWindowStartMs = 0;
      Serial.print("[주펌프 자동정지] 헤더압력:"); Serial.print(headerPressure);
      Serial.println("kPa (회복완료)");
    }
  }

  // v23 추가 조건: 순간압력은 안 낮아도, 충압펌프가 10초 안에 3회 이상 반복 기동하면
  // "충압펌프 혼자 감당 안 되는 상황"으로 보고 주펌프 개입 (완전개방/지속 대량누출 케이스)
  if (!mainAutoRunning && jockeyCycleCountInWindow >= JOCKEY_EXCESSIVE_CYCLE_COUNT) {
    digitalWrite(RELAY_MAIN_PIN, RELAY_ON);
    mainAutoRunning = true;
    Serial.print("[주펌프 자동기동] 충압펌프 과다반복(10초간 "); Serial.print(jockeyCycleCountInWindow);
    Serial.print("회) — 지속 대량누출 의심, 헤더압력:"); Serial.print(headerPressure);
    Serial.println("kPa");
  }
}

// ---------------------------------------------------------------------------
// 충압펌프 릴레이 배선 확인용 — 성능시험 대상이 아니라(§4/§5는 주펌프 한정) 단순 점검 트리거
// ---------------------------------------------------------------------------
void triggerRelayTest(int pin, unsigned long durationMs) {
  digitalWrite(pin, RELAY_ON);
  delay(durationMs);  // 배선 점검용 트리거는 드물게 수동으로만 실행되므로 짧은 블로킹은 허용
  digitalWrite(pin, RELAY_OFF);
}

// ---------------------------------------------------------------------------
// 성능시험(1차, 규칙기반) — 이 노드는 "펌프를 켜서 발표자에게 밸브 조작 시간을
// 주는 것"까지만 담당하고, 체절/부하 구분은 서버가 압력값으로 알아낸다.
// PERF_TEST_AUTO_INTERVAL_MS 주기로 자동 실행되거나, 시리얼 명령
// "TEST_PERFORMANCE"로 수동 트리거할 수 있다.
// ---------------------------------------------------------------------------
void startPerformanceTest() {
  if (perfState != PERF_IDLE) {
    Serial.println("이미 성능시험 진행 중 — 요청 무시");
    return;
  }
  Serial.println("성능시험 시작: 펌프 기동 — 지금부터 니들밸브를 손으로 잠갔다 여세요");
  digitalWrite(RELAY_MAIN_PIN, RELAY_ON);
  perfState = PERF_RUNNING;
  perfStateStartMs = millis();
}

void updatePerformanceTest() {
  if (perfState != PERF_RUNNING) return;
  if (millis() - perfStateStartMs >= PERF_TEST_DURATION_MS) {
    Serial.println("성능시험 종료 — 펌프 정지");
    digitalWrite(RELAY_MAIN_PIN, RELAY_OFF);
    perfState = PERF_IDLE;
  }
}

// 공회전(dryrun) 캡처 — 흡입측 차단/탱크 비움은 밸브 개폐와 무관한 별도 물리 조작이라
// 자동화하지 않고, 담당자가 그 상태를 만든 뒤 수동으로만 트리거한다.
void captureDryrunSample() {
  // v13: 주펌프 전류 샘플링 제거 — 압력/유량 없이 유량만 참고용으로 기록
  float flow = measureFlowLpm();  // 공회전이면 0에 가까운 값이 나오는 게 정상 — 참고용으로 같이 기록
  sendMainPumpPacket(NAN, NAN, NAN, NAN, flow, "dryrun");
}

// 버튼 1개에 대한 폴링+디바운스 처리 (유도등/가스계 노드와 동일 패턴).
// 인터럽트 대신 loop()에서 매번 읽고, 값이 BUTTON_DEBOUNCE_MS 이상 안정적으로
// 유지된 뒤 "눌림 순간(HIGH->LOW로 바뀐 그 한 번)"에만 action()을 호출한다.
void pollButton(int pin, bool &lastReading, bool &stableState,
                 unsigned long &lastChangeMs, void (*action)()) {
  bool reading = digitalRead(pin);

  if (reading != lastReading) {
    lastChangeMs = millis();   // 값이 바뀌는 순간마다 디바운스 타이머 리셋
    lastReading = reading;
  }

  if ((millis() - lastChangeMs) > BUTTON_DEBOUNCE_MS) {
    if (reading != stableState) {
      stableState = reading;
      if (stableState == LOW) {   // INPUT_PULLUP -> 눌리면 LOW. 눌리는 그 순간에만 1회 트리거
        action();
      }
    }
  }
}

void checkButtonPress() {
  pollButton(BUTTON_PERFORMANCE_PIN, buttonPerfLastReading, buttonPerfStableState,
             buttonPerfLastChangeMs, startPerformanceTest);
}

void handleSerialCommands() {
  if (!Serial.available()) return;
  String cmd = Serial.readStringUntil('\n');
  cmd.trim();
  if (cmd == "TEST_JOCKEY") {
    Serial.println("[주의] 이건 배선 점검용 수동 트리거일 뿐, controlJockeyPump()의 자동상태(jockeyRunning)와 무관합니다.");
    triggerRelayTest(RELAY_JOCKEY_PIN, 2000);
  } else if (cmd == "TEST_PERFORMANCE" || cmd == "P") {
    // "P 버튼" = 시리얼 모니터에 P 입력(또는 시연용 물리버튼을 GPIO에 달 경우 그 인터럽트에서
    // startPerformanceTest()를 그대로 호출하면 됨). 발표자가 주펌프측 개폐밸브를 손으로
    // 잠근 뒤 이 명령을 입력 -> 주펌프 기동 -> 압력/유량을 라즈베리파이로 전송 -> H-Q 연산.
    startPerformanceTest();
  } else if (cmd == "TEST_DRYRUN") {
    Serial.println("공회전 파형 캡처 — 흡입측을 먼저 차단/탱크를 비운 상태인지 확인할 것");
    captureDryrunSample();
  }
}

void setup() {
  Serial.begin(115200);
  analogReadResolution(12);

  esp_task_wdt_config_t twdtConfig = {
    .timeout_ms = 30000,   // 30초 동안 loop()에서 응답 없으면 자동 재부팅
    .idle_core_mask = 0,
    .trigger_panic = true,
  };
  if (esp_task_wdt_init(&twdtConfig) == ESP_ERR_INVALID_STATE) {
    esp_task_wdt_reconfigure(&twdtConfig);  // 프레임워크가 이미 초기화해둔 경우 재설정
  }
  esp_task_wdt_add(NULL);  // 현재 태스크(메인 loop)를 감시 대상으로 등록(이미 등록돼 있어도 무해)

  bootId = esp_random();

  pinMode(RELAY_JOCKEY_PIN, OUTPUT);
  pinMode(RELAY_MAIN_PIN, OUTPUT);
  digitalWrite(RELAY_JOCKEY_PIN, RELAY_OFF);  // 부팅 직후 반드시 꺼진 상태로 시작
  digitalWrite(RELAY_MAIN_PIN, RELAY_OFF);

  pinMode(FLOW_SENSOR_PIN, INPUT_PULLUP);
  attachInterrupt(digitalPinToInterrupt(FLOW_SENSOR_PIN), onFlowPulse, FALLING);
  lastFlowCalcMs = millis();

  pinMode(BUTTON_PERFORMANCE_PIN, INPUT_PULLUP);

  Wire.begin();  // INA219 초기화 (주펌프용은 v13에서 제거, 충압펌프용만 사용)

  if (!inaJockey.begin()) {
    Serial.println("[WARN] INA219(충압펌프, 0x40) 초기화 실패 — 배선/주소 확인 필요");
  }
  // v13: 주펌프 INA219 제거 (A0/A1 패드 납땜 막혀있어 주소변경 불가로 하드웨어 제약)
  // if (!inaMain.begin()) {
  //   Serial.println("[WARN] INA219(주펌프, 0x41) 초기화 실패 — A0 패드 점퍼 확인 필요");
  // }

  connectWiFi();
  perfLastAutoRunMs = millis();  // 부팅 직후 바로 시험이 돌지 않도록 기준시각을 지금으로 설정
  Serial.println("준비됨 — GPIO33=TEST_PERFORMANCE(성능시험) / 시리얼 'P'도 동일 동작");
}

// ---------------------------------------------------------------------------
// v16: 유량 기준 성능시험 구간 자동판정 — 사람이 밸브를 돌리는 건 그대로지만,
// "지금이 체절/정격/과부하 중 어디인지"는 유량값으로 ESP32가 직접 판단해서
// 패킷에 라벨을 붙여준다. 압력값 추세로 서버가 간접 추정하는 것보다 훨씬 직접적
// (유량은 밸브 개도의 직접적 물리량이라 신뢰도 높음).
// 펌프 정격유량 240L/h = 4.0L/min 기준. 필요시 아래 상수만 실측 보정할 것.
// ---------------------------------------------------------------------------
const float RATED_FLOW_LPM = 4.0;          // 정격유량(100%)
const float SHUTOFF_FLOW_THRESHOLD = 0.2;  // 이 밑이면 체절(거의 안 흐름)로 간주
const float TOLERANCE_RATIO = 0.10;        // 목표치 ±10% 이내면 해당 구간으로 판정

const char* determineTestPoint(float flowLpm) {
  if (flowLpm < SHUTOFF_FLOW_THRESHOLD) return "shutoff";

  float ratedLow = RATED_FLOW_LPM * (1.0 - TOLERANCE_RATIO);
  float ratedHigh = RATED_FLOW_LPM * (1.0 + TOLERANCE_RATIO);
  if (flowLpm >= ratedLow && flowLpm <= ratedHigh) return "rated_100pct";

  float overloadTarget = RATED_FLOW_LPM * 1.5;  // 150%
  float overloadLow = overloadTarget * (1.0 - TOLERANCE_RATIO);
  float overloadHigh = overloadTarget * (1.0 + TOLERANCE_RATIO);
  if (flowLpm >= overloadLow && flowLpm <= overloadHigh) return "overload_150pct";

  return "transition";  // 밸브 조작 중이라 아직 목표 구간에 안 들어온 상태
}

void loop() {
  esp_task_wdt_reset();  // "나 아직 살아있음" 신호 — 매 반복 맨 먼저 호출

  ensureWiFiConnected();
  handleSerialCommands();
  checkButtonPress();
  controlAutoPumps();
  updatePerformanceTest();

  // 성능시험(1차)은 정해진 주기에만 자동 실행 — AI(2차, 아래 전류패턴분류)는 이 조건과
  // 무관하게 항상 상시로 돈다(파일 상단 "관계" 설명 참고).
  if (perfState == PERF_IDLE && millis() - perfLastAutoRunMs >= PERF_TEST_AUTO_INTERVAL_MS) {
    perfLastAutoRunMs = millis();
    startPerformanceTest();
  }

  if (millis() - lastMainSendMs < MAIN_SEND_INTERVAL_MS) return;
  lastMainSendMs = millis();

  // v21: 압력/유량은 성능시험배관 전용 계측값이라, 나비밸브①이 열려 평상시 상태일 땐
  // 물이 그쪽으로 안 흐르므로 값 자체가 의미 없다(0 근처 고정). 예전엔 이 값을 상시로
  // 찍고 있어서 [헤더] 로그와 뒤섞여 헷갈렸음 — 이제 성능시험 중(PERF_RUNNING)에만
  // 측정/출력/전송하도록 제한. 평상시엔 [헤더] 로그만 남는다.
  if (perfState != PERF_RUNNING) return;

  float rms = NAN, peak = NAN, duty = NAN;
  float pressure = measurePressureKpa();
  float flow = measureFlowLpm();
  const char* testPoint = determineTestPoint(flow);

  Serial.print("[성능시험]  압력:"); Serial.print(pressure);
  Serial.print("kPa(원래전압:"); Serial.print(lastMainVOriginal);
  Serial.print("V)  유량:"); Serial.print(flow);
  Serial.print("L/min");
  Serial.print("  [");
  Serial.print(testPoint);
  Serial.print("]");
  // 목표까지 얼마나 남았는지도 같이 보여줘서 밸브 조작 시 눈으로 좇기 편하게
  if (strcmp(testPoint, "transition") == 0) {
    float distToRated = RATED_FLOW_LPM - flow;
    float distToOverload = (RATED_FLOW_LPM * 1.5) - flow;
    if (fabs(distToRated) < fabs(distToOverload)) {
      Serial.print(" 정격까지 "); Serial.print(distToRated); Serial.print("L/min");
    } else {
      Serial.print(" 과부하까지 "); Serial.print(distToOverload); Serial.print("L/min");
    }
  }
  Serial.println();

  sendMainPumpPacket(rms, peak, duty, pressure, flow, testPoint);
}
