Billiardchalktheif/2026ESWContest_free_bulchimbeon/(commit log)

2026-08-01 simulation/가스계_wokwi/sketch.ino
2026-08-01 simulation/소화기_wokwi/
2026-08-02 Rename AI 학습 데이터 수집 가이드.md to AI_학습_데이터_수집_가이드.md
2026-08-02 AI_학습_데이터_수집_가이드.md
2026-08-05 Revise Raspberry Pi server MOCK_MODE verification details
    Updated verification details for Raspberry Pi server software in MOCK_MODE, including source and validation process.
2026-08-05 앱: QR스캔 + PDF 생성 기능 추가 (서버 없이 가능한 최대치 완료)
2026-08-07 Rename 발전가능성_확장방안_정리.md to v2 version
2026-08-08 Add bulchimbeon_sw/ - central server, ML, dashboard, simulation Python code
    라즈베리파이 수신서버(receiver/storage/judge/dispatch)와 AI 학습 스크립트,
    Flask 대시보드, 더미데이터 시뮬레이터를 추가한다. 기존 server/의 ESP32 .ino
    펌웨어와 이름이 겹치지 않도록 별도 bulchimbeon_sw/ 폴더로 분리했다.
2026-08-08 Revise scenario labels and humidity analysis
    Updated the scenario description for electronic cigarette to '수증기' and clarified humidity analysis.
2026-08-09 Fix ESP32 NTP unsync by overriding packet ts with server receive time
    ESP32가 NTP 동기화 전(millis()/1000 기반 작은 값)에 보낸 패킷을 그대로
    저장하면 z-score/선형회귀 시계열이 1970년대 근처 값으로 깨진다. ESP32의
    NTP 재시도 로직 대신, 서버가 ts < NTP_SYNCED_THRESHOLD_TS(1700000000,
    .ino 파일들과 동일 기준)이면 패킷 수신 시각으로 갈아치우도록 수정.
2026-08-09 Replace fire alarm z-score judgment with 2-layer loop resistance check
    이동평균 z-score는 baseline 자체가 서서히 상승하는 저항값을 따라가버려
    "가속 열화"를 정상으로 오판하는 문제가 실측 검증 중 발견됐다. 급성 단선/
    합선은 화재수신기 도통시험이 이미 감시하므로, 상위 SW는 법정기준(50Ω)
    초과 여부(1층, check_absolute_threshold)와 서서히 진행되는 열화 추세
    (2층, Ω/day 선형회귀, check_resistance_trend)를 독립 평가하는 구조로
    재정립했다(evaluate_loop_resistance, server/judge/regression.py).
    raw 루프저항은 R_loop 고정저항+가변저항의 합이라 법정기준과 스케일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
    [config.py]
2026-08-11 Show corrected loop resistance as main value, raw/formula in collapsible detail
    카드 기본 화면엔 raw가 아니라 보정값(raw - LOOP_FIXED_OFFSET_OHM)을 메인으로
    보여준다 — 실제 판정 기준(50Ω)과 비교되는 건 보정값이지 raw가 아니므로, raw를
    기본 표시하면 관리사가 raw 숫자만 보고 정상/경보를 착각할 수 있다. raw/오프셋/
    계산식은 <details>로 접어두고 필요할 때만 펼쳐보게 했다(JS 불필요).
    RTTF(잔여 고장시간 예측)가 이미 법정기준을 넘어선 뒤에도 상승 중인 표본에서
    음수로 나오던 것도 "이미 기준 초과"로 명시적으로 표시하도록 수정.
2026-08-11 Limit loop resistance trend regression to recent 20 samples
    _fetch_loop_resistance_history가 전체 이력 대신 최근 LOOP_TREND_HISTORY_LIMIT(20)개만
    (ORDER BY ts DESC LIMIT 20 후 시간순 재정렬) 가져오도록 변경. 오래전 스파이크 하나가
    전체 이력에 계속 남아 회귀 기울기를 영구적으로 왜곡하는 문제 방지 — 이미 정상으로
    돌아온 뒤에도 과거 스파이크 때문에 기울기가 커 보이는 상황을 막는다.
    LOOP_TREND_MIN_SAMPLES(3)는 그대로 유지 — 이 함수가 반환하는(최대 20개) 표본에
    대해 동일하게 적용됨. 회귀 스크립트로 aging-out 동작 확인.
2026-08-13 Split online/offline heartbeat timeout by device_type (gas needed its own)
    가스계는 실배포 기준 전송주기가 1일이라, 공통 90초 무수신 기준을 쓰면
    정상 작동 중에도 항상 offline로 표시됐다. server/config.py에
    HEARTBEAT_TIMEOUT_SEC를 device_type별 딕셔너리로 바꾸고(gas=130000초,
    나머지는 기존 90초 유지), is_node_online() 공통 헬퍼를 추가해
    receiver/packet_parser.py(mark_offline_nodes)와 dashboard/app.py
    (get_heartbeats)가 하나의 판정 기준만 공유하도록 정리했다.
    가스 ESP32 노드는 시연용으로 SEND_INTERVAL_MS를 5초로 낮춰도(esp32/gas_node/
    gas_node.ino, 이번 커밋에는 미포함 — esp32/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
2026-08-15 Add 수증기_소중대_통합_분석_리포트.md file
2026-08-15 Rename 수증기_소중대_통합_분석_리포트.md
2026-08-15 Move 수증기_소중대_통합_분석_리포트.md to photoelectric directory
2026-08-15 data/ 실험데이터를 엣지·클래스별 구조로 재정리
    광전식 엣지(노말/쿠킹 클래스)와 유도등 엣지 데이터를 하위 폴더로 분리하고,
    누락돼 있던 유도등 방전 실험 원시 데이터를 추가함.
    [normal_plateau_reference.csv, normal_raw_timeseries.csv, normal_session_summary.csv, vapor_raw_data_대.csv, vapor_raw_data_소.csv, vapor_raw_data_중.csv, vapor_summary_대.csv, vapor_summary_소.csv]
2026-08-15 data/에 README 추가 — 폴더·파일별 데이터 설명 문서화
2026-08-15 Add network infrastructure troubleshooting doc (hotspot, WPA, RTC/heartbeat)
    라즈베리파이 자체 WiFi 핫스팟(BulchimbeonAP) 인프라에서 겪은 3가지 문제와
    해결방안 정리: 재부팅 시 핫스팟 소실(autoconnect 미설정), ESP32만 인증
    실패(WPA1/2 혼합 협상 → WPA2-CCMP 고정), RTC 부재로 시계가 과거에 고정되며
    발생한 하트비트 오판정(fake-hwclock 주기 저장). docs/개발_장애요인_해결방안_정리.md와
    같은 형식으로 작성.
2026-08-15 광전식 엣지에 스모킹·화재 클래스 데이터 추가, README를 업로드 상태에 맞게 갱신
    - 스모킹(연초_전자담배) 클래스, 화재(열원_연기) 클래스 신규 업로드
    - 쿠킹(수증기) 클래스 -> 쿠킹(수증기_소중대) 클래스로 폴더명 동기화
    - data/README.md·README.md의 data/ 섹션을 실제 업로드된 파일 구성에 맞게 재작성 (유도등 엣지의 txt->csv 교체 반영 포함)
    [ecig_raw_timeseries.csv, ecig_session_summary.csv, incense_raw_timeseries.csv, incense_session_summary.csv, smoking_class_combined.csv, tobacco_delta_reference.csv, tobacco_raw_timeseries.csv, tobacco_session_summary.csv]
2026-08-15 Adjust EVAC_DISCHARGE_THRESHOLD_V to 0.3V
    Updated EVAC_DISCHARGE_THRESHOLD_V to 0.3V based on measurements.
2026-08-16 Update LOOP_FIXED_OFFSET_OHM to measured value (98.4 ohm, Fluke 17B+)
    가변저항을 열화 없음(최소) 위치로 완전히 돌린 상태에서 A1~GND 순수 고정저항
    (100Ω 저항 실물)을 멀티미터로 직접 실측한 값(2026-08-16)으로 교체. 기존
    242.0은 가변저항이 섞인 상태의 근사치였음.
    simulate/dummy_generator.py도 FIRE_ALARM_BASELINE_OHM 계산에 253.0을
    하드코딩하던 걸 config.py의 LOOP_FIXED_OFFSET_OHM을 직접 import해서 쓰도록
    바꿔, 앞으로 실측값이 또 바뀌어도 여기서 안 잊게 했다.
    server/judge/regression.py, dashboard/app.py,
    simulate/verify_loop_resistance_judgment.py는 전부 config에서 import해서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
2026-08-16 Finalize LOOP_FIXED_OFFSET_OHM at 230 (measured minimum) + clamp negatives
    여러 차례 실측(98.4 -> 230.9 -> 234.4)을 거쳐 최종 확정: 정상 상태 raw는
    233~236Ω에서 흔들리지만 물리적 접촉/진동으로 순간 230Ω까지 떨어지는 게
    관찰됐다. 루프저항은 "열화 없음"이 물리적 최솟값이므로 오프셋은 평균이
    아니라 관측된 최솟값 근처로 잡아야 한다 - 평균으로 잡으면 정상 노이즈
    하락만으로 corrected 값이 음수가 된다.
    오프셋을 아무리 신중히 잡아도 노이즈로 음수가 나올 가능성은 남으므로,
    evaluate_loop_resistance(server/judge/regression.py)와 dashboard/app.py의
    get_fire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
    [config.py]
2026-08-16 Split negative clamping: raw/regression stay unclamped, only display clamps
    직전 커밋에서 evaluate_loop_resistance의 저장/회귀용 corrected 값에
    max(0, ...)를 적용했더니, 오프셋(230) 근처에서 노이즈로 낮게 나온 샘플만
    0으로 뭉개지고 높게 나온 샘플은 그대로 남는 비대칭 클램핑이 발생했다.
    이 비대칭 데이터로 선형회귀를 돌리면 실제로는 열화가 없는데도 인위적인
    양의 기울기가 생기고, Ω/day 환산 과정에서 수십~수백 배로 증폭돼(79.67
    Ω/day 등) 가짜 alarm이 떴다 — raw 저항이 정상인데도 대시보드에 alarm이
    뜨는 현상으로 관측됨.
    server/judge/regression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
2026-08-16 Downsample loop resistance regression history (5 packets = 1 sample)
    자탐1 실물(SEND_INTERVAL_MS=5000)에서 20개 표본이 겨우 100초 분량이라
    노이즈가 Ω/day 환산 시 864배 증폭돼 가짜 alarm이 뜨는 문제가 실측으로
    확인됐다. raw 저장/1층 절대임계값/대시보드 실시간 표시는 매 패킷 그대로
    유지하고, 2층(추세) 회귀에만 다운샘플링을 적용한다:
    - _fetch_loop_resistance_history: 최근 raw 100개(LIMIT*N)를 가져온 뒤
    오래된 쪽부터 5개마다 1개씩 골라 20개로 줄인다 - 20개 표본이 100초가
    아니라 500초에 걸쳐 퍼지도록 시간창 자체를 넓힌다.
    - evaluate_loop_resistance: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
2026-08-16 Retune LOOP_TREND_ALARM_SLOPE/CAUTION_SLOPE from empirical noise stats
    다운샘플링(5개당 1개)만으로는 D시나리오(5초 간격 노이즈, 목표 alarm 5%
    이하)를 통과하지 못했다 — 근본 원인은 LOOP_TREND_ALARM_SLOPE(2.0)/
    CAUTION_SLOPE(0.5)가 "임시값, 실측 후 재조정 필요"로 설계된 채 방치돼
    있었던 것. 노이즈 분포를 20~25회 반복 시뮬레이션으로 실측(steady-state
    표준편차 ~36Ω/day, 워밍업 구간은 ~195Ω/day)해 재조정했다.
    - LOOP_TREND_ALARM_SLOPE: 2.0 -> 700
    - LOOP_TREND_CAUTION_SLOPE: 0.5 -> 230
    - LOOP_TREND_MIN_SAMPLES(3)는 그대로 유지 — 그리드서치 결과 안 올려도
    목표를 만족해서,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
    [config.py]
2026-08-16 자탐 루프저항 2층 판정 결선 전용 재조정 (시연 3분 제약 해제)
    시연 영상(3분)에서 자탐 회귀분석(2층 추세 판정)을 아예 노출하지 않기로
    결정됨에 따라, "3분 내 반응" 제약을 버리고 노이즈 억제(오탐 최소화)만
    최우선으로 재탐색:
    - LOOP_TREND_DOWNSAMPLE_EVERY_N 5->100, LOOP_TREND_HISTORY_LIMIT 20->50
    (회귀 창을 25초에서 약 6.94시간으로 대폭 확대)
    - LOOP_TREND_MIN_SAMPLES 3->15 (초기 워밍업 구간 불안정 기울기 필터링)
    - LOOP_TREND_ALARM_SLOPE 700->8, LOOP_TREND_CAUTION_SLOPE 230->3
    (D시나리오 실측 노이즈 표준편차 ~0.45Ω/day, 99th percentile ~0.92Ω/day
    기준 재산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
2026-08-16 대시보드 시연 모드 플래그 추가 (자탐 2층 판정 필드 숨김)
    결선 전용으로 재조정된 자탐 루프저항 2층 판정(열화 추세/잔여 고장시간 예측)이
    대시보드에 조건 없이 항상 표시되던 문제를, 코드 삭제 없이 플래그로 전환:
    - server/config.py: DEMO_MODE=True 추가 (기본값 True — 시연 준비 기간이므로
    기본으로 숨김, 결선 시 False로 전환)
    - dashboard/app.py: get_fire_alarm_cards가 카드 딕셔너리에 demo_mode를 포함.
    loop_trend_slope_ohm_per_day/loop_rttf_days 값 자체는 그대로 계산·전달되고,
    숨기는 건 템플릿 렌더링 단계에서만 처리 (데이터 흐름/DB 저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
2026-08-16 README를 광전식 엣지 최종 데이터 구성에 맞게 갱신
    - 광전식 엣지 실험 완료 표기 및 최종 통합 파일(photoelectric_all_classes_combined.csv, 최종분석보고서) 설명 추가
    - 화재(열원_연기) 클래스를 incense/heat/fire 3종 하위 실험으로 상세화
    - 쿠킹(수증기) 클래스가 5클래스 통합 분석에는 미포함됨을 명시
2026-08-16 자탐1 루프저항 2층 판정 재조정 정리 문서 추가 및 README 색인 갱신
    docs/자탐1_루프저항_2층판정_재조정_정리.md — 오프셋 실측 확정, 클램핑 위치
    버그(DB/회귀 계산과 화면 표시 분리), 회귀 기울기(Ω/day) 노이즈 증폭 문제
    발견, 시연 3분 제약 하 1차 재조정(700/230), 결선 전용 2차 재조정(8/3 +
    시간창 확대), DB 인덱스 추가, DEMO_MODE 플래그 도입까지 전 과정을
    팀 공유용/개발완료보고서 근거자료로 정리. README.md docs 색인에 반영.
2026-08-20 소화기 게이트웨이 ESP-NOW/WiFi 동시사용 문제 정리 문서 추가
    docs/소화기_게이트웨이_ESP-NOW_WiFi_동시사용_문제_정리.md — WPA 프로토콜
    협상 문제(네트워크_인프라_장애요인_해결방안_정리.md) 해결 후에도 남아있던
    소화기 게이트웨이 WiFi 반복 끊김의 원인 추적과 최종 해결 과정 정리.
    - 1차 가설: 라즈베리파이 brcmfmac 드라이버의 AP 모드 결함(vndr ie set error)
    - 2차 가설: ESP32 단일 라디오의 ESP-NOW/WiFi STA 시분할 공유 충돌
    - 검토한 대안(USB WiFi 동글, ESP8266 분리, USB Serial 직결)과 각 한계
    - 최종 해결: 라즈베리파이를 AP 모드 대신 외부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
2026-08-21 Rename data/가스계_캘리브레이션_결과_정리.md to data/가스계 엣지/가스계_캘리브레이션_결과_정리.md
2026-08-21 README에 가스계 엣지 데이터 섹션 추가
    gas_node_log.csv, gas_regression_chart.png, 가스계_캘리브레이션_결과_정리.md 신설분 반영.
    캘리브레이션 확정값(87.9), 온도 드리프트(영점 오차) 이슈, 10% 손실 임계값 예측 검증 결과(오차 ~49분) 요약.
2026-08-21 Add files via upload
    라즈베리파이 연동이랑 큐알코드 생성 순서
2026-08-22 자탐2 5클래스 실측 데이터 DB 반영 스크립트 추가
2026-08-22 재현 실행 순서에 자탐2 데이터 임포트 단계 추가
2026-08-22 자탐2 분류기에 5-fold 교차검증 추가
2026-08-22 자탐2 분류기에 mq2_to_humidity_ratio 파생 feature 추가 (incense/smoking 오분류 개선)
    5-fold 교차검증(64개 전체)에서 incense 10개 중 3개가 오분류(2개는 smoking으로,
    1개는 normal로)됐던 걸 확인한 뒤, CSV 원본 데이터를 직접 비율로 계산해보니
    incense는 "MQ2만 크게 뛰고 습도는 거의 안 움직이는" 시그니처, smoking(연초/
    전자담배)은 "MQ2 상승과 함께 습도도 같이 오르는" 시그니처(담배 연기에 수증기가
    섞여 나옴)라는 가설을 세웠다. mq2_raw/(humidity_pct의 절대값+1) 비율을 파생
    feature로 추가해 재학습한 결과, smoking으로 오분류되던 incense 2개가 전부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
2026-08-22 자탐2 분류기 최종 모델을 전체 64개 데이터로 재학습하도록 변경
2026-08-22 자탐2 실시간 추론 경로를 학습 데이터 기준(상승률)과 정합 - 이중모드 기준점(이동평균/시연트리거) 추가
2026-08-22 자탐2에 쿠킹(수증기) 습도/MQ2 임계값 규칙판정 추가 - ML 모델 호출 전 선제 필터
2026-08-22 Rename data/summary_by_class.csv to data/수계 엣지/summary_by_class.csv
    [summary_by_class.csv]
2026-08-22 README에 수계 엣지 데이터 섹션 추가
    combined_all_labeled.csv, summary_by_class.csv, summary.md, 충압펌프_전류파형_분석_보고서.md 신설분 반영.
    충압펌프 4클래스(normal/low_flow/dryrun/start_fail) 구성, normal-low_flow RMS 83.7% 중첩 이슈,
    라벨 버그 정정 이력, 클래스 불균형 요약.
2026-08-23 수계 충압펌프(jockey) 분류기 재겨냥 + 5클래스 실측 데이터 DB 반영
    주펌프는 전류센서(INA219) 미장착으로 파형 데이터 자체가 없어 AI 분류 대상에서
    제외됨(압력 기반 규칙판정만 유지). 기존 train_pump_classifier.py의
    pump_type='main' 필터를 'jockey'로 재겨냥하고, combined_all_labeled.csv(1,297개,
    normal/low_flow/dryrun/start_fail 4클래스)를 DB에 반영하는
    import_jockey_pump_labeled_data.py를 추가.
    normal↔low_flow의 RMS 값이 83.7% 겹친다는 분석 보고서 경고에 따라 class_weight=
    'balanced' 적용 후 학습한 결과 accuracy 0.97, dryrun(최소클래스 39개) recall
    100%, normal↔low_flow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
2026-08-23 Add new software documentation for 자탐1
2026-08-23 자탐1 온도상승률 판정 + 점검모드 서버 반영 (펌웨어 연동 대기)
    인수인계 문서(docs/자탐1_온도상승률_판정로직 및 점검모드신설_소프트웨어_인수인계.md)
    기준 서버 쪽 구현. fire_alarm_differential_node.ino가 아직 temp_raw_adc/test_mode
    필드를 안 보내는 상태(2026-08-23 GitHub 기준 재확인)라, 해당 필드 없이 패킷이 와도
    에러 없이 조용히 판정을 건너뛰도록 방어적으로 구현 — 펌웨어 반영은 별도 작업.
    - schema.sql: fire_alarm_log에 temp_raw_adc/temp_v/boot_elapsed_ms/temp_status/
    test_mode 컬럼 추가, test_mode_log 테이블 신설
    - server/storage/migrate_add_differential_t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
2026-08-23 Rename data/차동식_실험보고서.md to data/차동식 엣지/차동식_실험보고서.md
2026-08-23 README에 차동식 엣지 데이터 섹션 추가
    5개 실험(무반응/부작동x2/작동x2) csv, 차동식_실험보고서.md 신설분 반영.
    raw-온도 캘리브레이션 채택 구간(실험5 상승부), 최종 확정 상수(TEMP_RAW_PER_C=-139.0 등),
    부작동시험 오탐 마진 이슈를 요약.
2026-08-23 주펌프 카드에서 rms/peak/duty 줄 제거 (v8 설계상 주펌프는 INA219 미장착 — 항상 NULL)
2026-08-23 주펌프 최근 파형 분류 이력 표에서 체절운전 칸 제거
2026-08-23 README를 현재 저장소 파일 기준으로 전면 정리
    - 상단에 저장소 구조 요약 표 추가, 기존 하단의 중복·낡은 '폴더 구조' 트리 섹션 제거
    (guide/ vs 실제 guides/ 등 이름 불일치, gas_node_v23ino 오타, 오래된 app/·docs/ 파일 목록 등 누적된 불일치 정리)
    - 신설된 bulchimbeon_sw/(라즈베리파이 서버 Python 코드) 섹션 추가
    - docs/ 파일명 오타 수정(Fail-safe -> Fail-Safe, 소프트웨어_구성안_v3.md -> 실제 파일명인 '소프트웨어 구성안 v3.md'),
    누락된 불침번_하드웨어_최종기술문서.pdf 추가
    - app/에 QR코드_생성_가이드.md, 라즈베리파이_연동_가이드.md, raspb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
2026-08-23 성능시험 카드를 H-Q 곡선 차트로 통합, 수동 트리거 버튼 제거
2026-08-23 성능시험 H-Q 곡선 기준값을 축소모델 실측으로 재정의 (RATED_PRESSURE_KPA/RATED_FLOW_LPM)
    체절시험 실측압력 74.37kPa=140% 지점, 실측 최대유량 1.87L/min=150% 지점 기준으로
    역산(RATED_PRESSURE_KPA=53.12, RATED_FLOW_LPM=1.25). 법정 퍼센트 기준(140%/65%)은
    불변, 그 분모가 되는 100%(정격) 값만 축소모델 실측으로 재정의.
2026-08-23 성능시험 기준값 소수점 정밀도 확대 (반올림으로 인한 자기기준 미통과 버그 수정)
    RATED_PRESSURE_KPA=53.12/RATED_FLOW_LPM=1.25(소수점 2자리)로 반올림하면 기준값을
    만든 원본 측정치(74.37kPa/1.87L/min)를 그대로 다시 넣어도 140%/150%를 미세하게
    초과해 "경보"가 뜨는 문제가 있었다. 53.121429/1.246667(6자리)로 정밀도를 높여
    원본 측정치가 정확히 자기 기준을 통과하도록 수정.
    [pump_performance_test.py]
2026-08-23 Update README with calibration results and notes
    Added final calibration results and clarified measurement conditions.
2026-08-23 충압펌프 NTP 타이밍 버그 수정 + flow_lpm/새 valve_state 4단계 서버 반영(이론값 복귀)
    Part A (server/pump_node_INA219_v24.ino):
    - jockeyLastStartEpoch NTP 가드 추가 — NTP 미동기화 시각이 저장되면 나중에 진짜
    에폭값과 빼는 순간 결과가 17억대로 폭주해 JSON이 256바이트 버퍼를 넘겨 잘리는
    버그(2026-08-23 실측 로그로 확인)를 NTP_SYNCED_THRESHOLD 비교로 방지
    - sendJockeyEventPacket/sendMainPumpPacket에 doc.overflowed() 안전장치 추가
    Part B (서버):
    - schema.sql: water_pump_log에 flow_lpm 컬럼 추가, valve_state 주석을 새 4단계
    체계(shutoff/rated_100pct/overload_150pct/transition)로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
    [pump_performance_test.py]
2026-08-23 H-Q 차트를 실측 곡선+추정 연장선(점선)으로 교체 — 정격 도달 전 압력 0 도달을 시각화
2026-08-23 H-Q 차트에서 추정 연장선 제거, X축 범위 고정(정격의 2배)
2026-08-23 수계 AI 추론을 main→jockey로 정정, 라벨 어휘 불일치 수정
2026-08-23 충압펌프 기동간격 표시에 None 가드 추가 (cycle_interval_sec 없을 때 N/A)
2026-08-24 수계 대시보드 — 주펌프 confidence 제거, 파형 분류 카드를 학습데이터 전체 분포로 전환
2026-08-25 소화기 내용연수(10년) 관리 기능 추가
    소방시설등 점검관리 매뉴얼 1-A-008 기준. extinguisher_config 테이블(노드당 1행,
    제조일자)을 신설해 대시보드에서 입력/수정하고, check_extinguisher_lifespan()으로
    정상/교체 임박/만료/미입력 4단계 판정 후 D-day와 배지로 표시. 이탈감지(evaluate_tamper)와
    완전히 별개 축으로 동작.
2026-08-25 대시보드 Chart.js CDN 의존성 제거 - 로컬 static 서빙으로 전환 (오프라인 환경 대응)
2026-08-25 소화기 내용연수: 제조일자+10년 계산 방식을 만료일자 직접입력 방식으로 변경, 대시보드 자동새로고침을 JS 기반으로 전환(입력 중 정지)
2026-08-26 README에 app_api·앱 개발코드·결선 발전방향 반영, 전체 파일 목록 정합성 재점검
    - bulchimbeon_sw/app_api/inspection_api.py(앱 연동 FastAPI) 추가 반영 — 최상위 README와
    bulchimbeon_sw/README.md 구조 트리 양쪽 모두 업데이트
    - app/개발_코드/(Flutter 실제 소스)와 app/네이비브앱_결선_발전방향.md(결선 대기 항목 6종) 추가
    - docs/·guides/·server/·data/README.md는 실제 파일과 대조해 이미 최신 상태임을 확인(변경 없음)
2026-08-28 자탐1/자탐2 공용 LOOP_FIXED_OFFSET_OHM 실측 재보정 (230 → 264), README 문서 값 동기화
2026-08-28 대시보드를 영상 편집용 4열 정사각형 통합 레이아웃으로 재구성 (5개 섹션 → 2개 그리드)
2026-08-28 유도등 카드 표시 순서를 1·3·2·4층으로 조정, 섹션 제목을 통합판 문구 대신 원래 설명 문구로 원복
2026-08-28 대시보드 열그룹 라벨을 행별로 완전히 분리 + 유도등 표시 순서 1·2·3·4층
    자탐/가스계/수계 어느 것도 서로 합쳐지지 않게 헤더를 그리드 행마다 배치.
    소화기·유도등은 get_extinguisher_evac_combined_cards()로 행 단위 인터리브,
    유도등 정렬을 1·3·2·4층 → 1·2·3·4층으로 변경.
2026-08-28 [버그수정] 다른 노드 트래픽으로 socket.timeout이 억제되어 이탈 확정 스윕이 거의 실행 안 되던 문제 수정 - 5초 주기 강제 스윕으로 전환
2026-08-28 대시보드 카드 비율을 1:1에서 4:3으로 완화하고 전체 여백을 축소 - 창 맞춤 축소 시 글자 가독성 확보
2026-08-28 카드 aspect-ratio 제거 - 내용 기반 높이로 복원해 빈 여백 낭비 해소, 브라우저 확대/축소로 전체 화면 표시 가능하게 함
2026-09-01 학습된 AI 모델 파일 커밋 (pump_classifier, nuisance_classifier) - 재현성 확보
    data/ CSV -> import 스크립트 -> ml/train_*.py 로 재학습.
    pump: 정확도 0.97 (manual 라벨 1297개, performance_test 라벨 0개라 fallback 분기)
    nuisance: 5-fold CV 정확도 0.97 (64개 표본)
    .gitignore가 이 파일들을 무시하므로 -f로 강제 추가.
2026-09-01 requirements.txt에 누락된 pyserial 의존성 추가 + 브릿지 파일명 정정
    serial_to_udp_bridge_no_pyserial.py는 실제로 import serial(pyserial)을 쓰는데
    파일명이 정반대여서 serial_to_udp_bridge.py로 rename (참조하는 코드 없음 확인).
2026-09-01 보안: 펌웨어에 하드코딩된 WiFi 비밀번호/서버 IP를 플레이스홀더로 교체
    git 추적 중인 server/*.ino 23개의 WIFI_SSID/WIFI_PASS/SERVER_IP 선언을
    YOUR_SSID / YOUR_PASSWORD / YOUR_SERVER_IP 로 통일.
    extinguisher_leafnode_v2.ino 주석에 남아있던 SSID 문자열도 제거.
    (미커밋 로컬 재구성 작업 esp32/, evac_light_node_v3//v4/ 는 건드리지 않음)
2026-09-01 문서: README 구조도를 실제 저장소 상태(server/*.ino)에 맞게 되돌림 - esp32/ 재구성은 예선 이후로 연기
